Mofiche/Getriebebeleg/Dokumentation/Getriebebeleg.pdf

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

## 1 Zeichnungsdokumentation

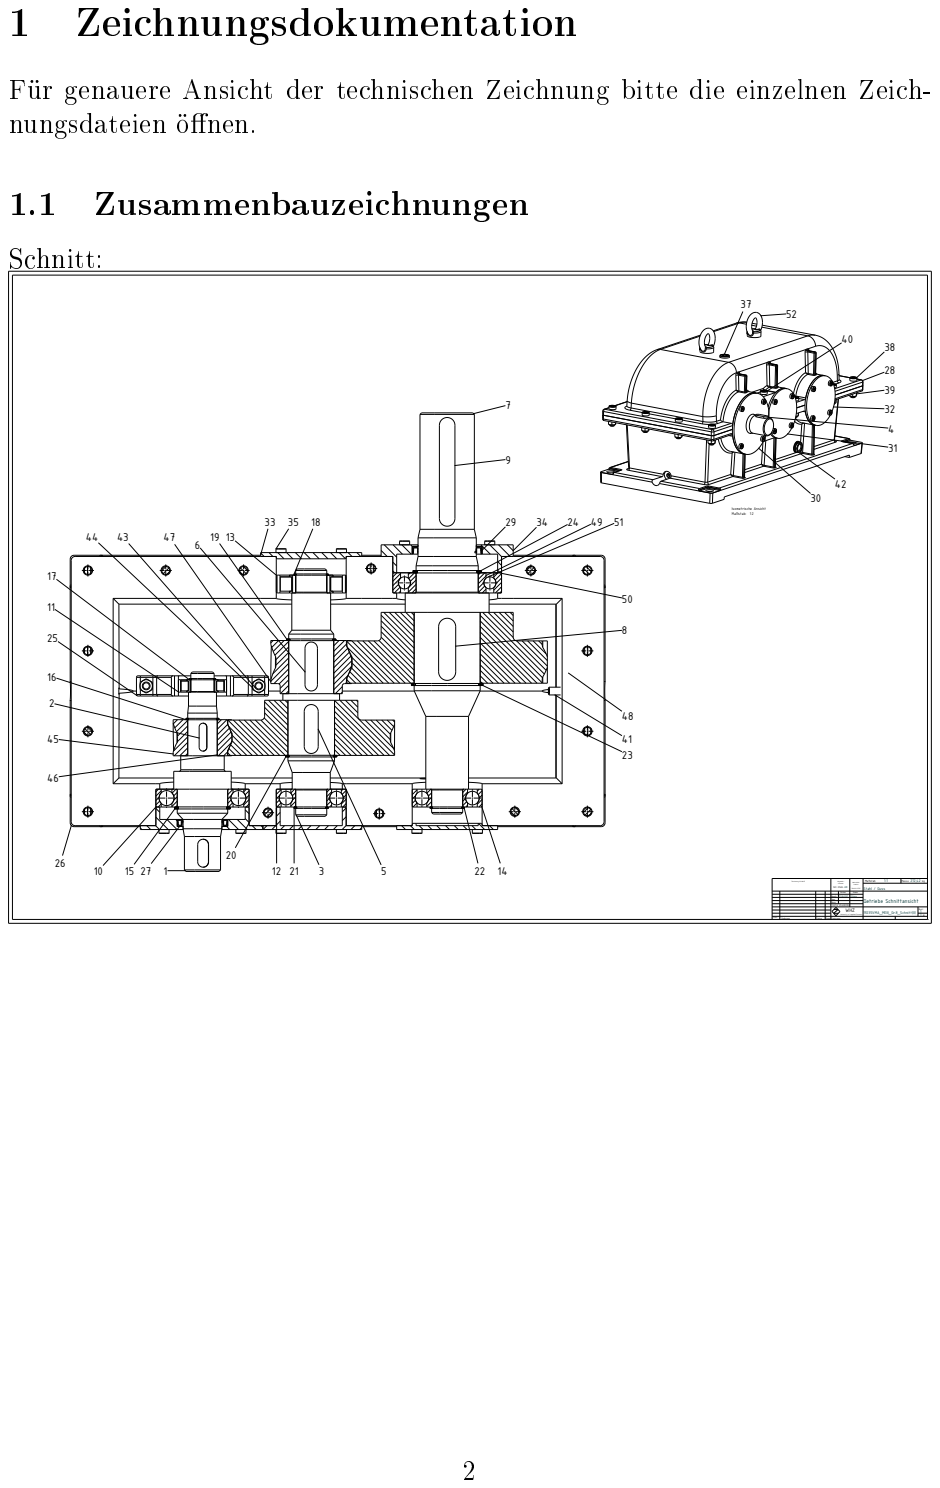
[picture p1: page 2]
Zusammenbauzeichnungen; Schnitt:; Maßstab; Gepr.; Bearb; Zust.; Datum; Name; Änderung; Blatt; Norm CATIA V5-6R2016; Allgemein- toleranz ISO 2768-; Tolerierung ISO 8015; Dateiname; Masse; WHZ; Getriebe Schnittansicht; 19235VMA_MEIII_Gr.8_Schnitt(0); 17.06.2021 M.Enge; Stahl / Guss; Isometrische Ansicht Maßstab: 1:2

Für genauere Ansicht der technischen Zeichnung bitte die einzelnen Zeich-
nungsdateien önen.

Werkstück-
kanten DIN ISO 13715

University of Applied Sciences

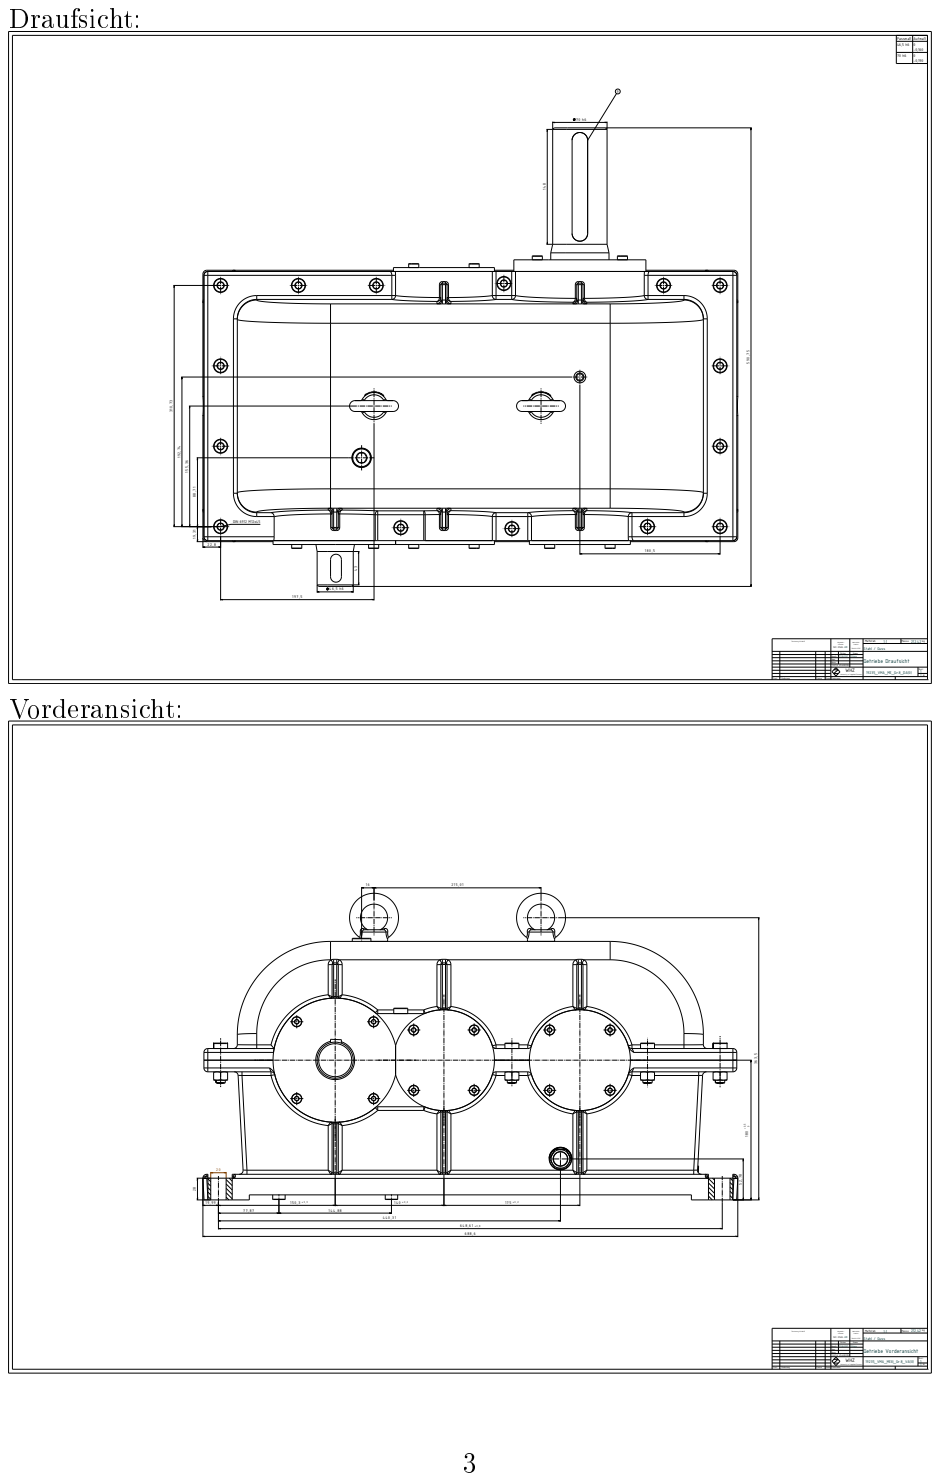
[picture p2: page 3]
Draufsicht:; Gepr.; Bearb; Name; Blatt; Datum; Norm CATIA V5-6R2016 WHZ; Getriebe Draufsicht; 19235_VMA_ME_Gr.8_DA(0); M.Enge; DIN 6912 M12x45; Vorderansicht:

9 70 h6 | Passmaß 46,5 h6 | Aufmaß 0 -0,160

Tolerierung ISO 8015 | Allgemein-toleranz ISO 2768-mK | Werkstück-kanten DIN ISO 13715 | Maßstab 1:1 Masse 212,42 Stahl / Guss | kg

Zust. Änderung | Datum Name Dateiname

University of Applied Sciences

Tolerierung ISO 8015 | ISO 2768-Allgemein-toleranz mK | Werkstück-kanten DIN ISO 13715 | Maßstab 1:1 Masse 212,42 Stahl / Guss | kg

Datum Norm Gepr. Bearb 17.06.2021 CATIA V5-6R2016 | Name M.Enge | Getriebe Vorderansicht

WHZ University of Applied Sciences | Blatt 19235_VMA_MEIII_Gr.8_VA(0) 1 1 | Bl.

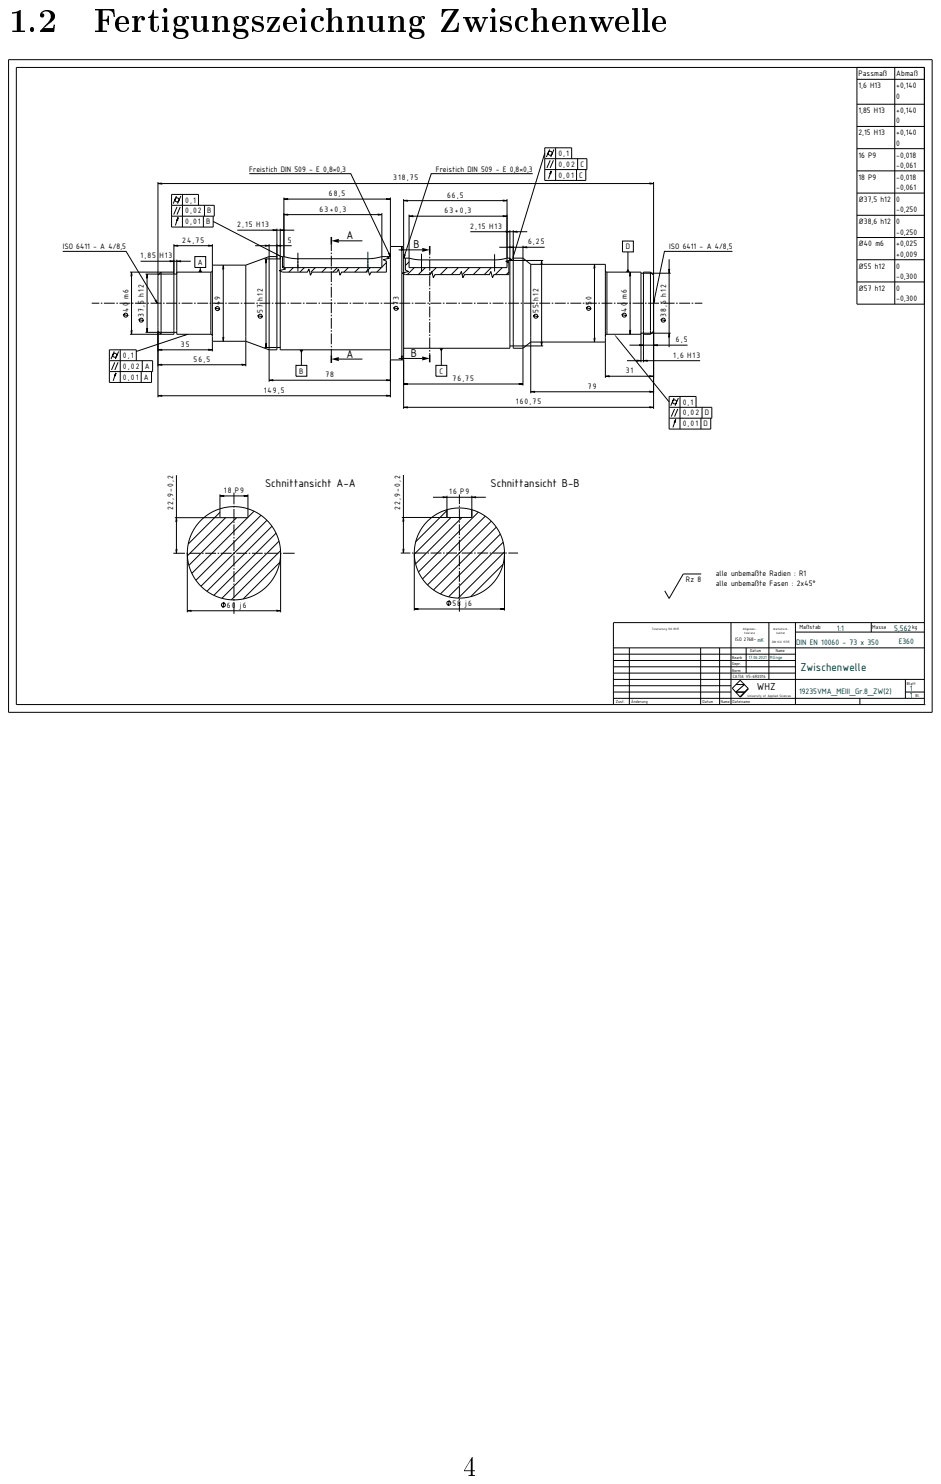
[picture p3: page 4]
Fertigungszeichnung Zwischenwelle; Maßstab; Werkstück- kanten; DIN ISO 13715; Allgemein- toleranz ISO 2768-; Tolerierung ISO 8015; Masse; DIN EN 10060 - 73 x 350; ISO 6411 - A 4/8,5; Freistich DIN 509 - E 0,8×0,3; Schnittansicht A-A; Schnittansicht B-B

Passmaß | Abmaß
1,6 H13 | +0,140 0

alle unbemaßte Radien : R1
alle unbemaßte Fasen : 2x45° Rz 8

Bearb | Datum 17.06.2021 | Name M.Enge | Zwischenwelle

Gepr.
Norm CATIA V5-6R2016

WHZ University of Applied Sciences | | Blatt 1 1 19235VMA_MEIII_Gr.8_ZW(2)

Zust. | Änderung | Datum | Name | Dateiname

1.3 | Stückliste
1 | 2 | 3 | 4 | 5 | 6
Pos. | Menge | Einheit | Benennung | Sachnummer / Norm - Kurzbezeichnung | Bemerkung
1 | 1 | Stck. | Eingangswelle | | C60
3 | 1 | Stck. | Zwischenwelle | | E360
7 | 1 | Stck. | Ausgangswelle | | S235JR
25 | 1 | Stck. | Lagerbock EW LL | | S235JR
26 | 1 | Stck. | Gehäuse Unterteil | | GG
28 | 1 | Stck. | Gehäuse Oberteil | | GG
30 | 1 | Stck. | Lagerdeckel EW LL | | S235JR
31 | 1 | Stck. | Lagerdeckel ZW FL | | S235JR
32 | 1 | Stck. | Lagerdeckel AW LL | | S235JR
33 | 1 | Stck. | Lagerdeckel ZW LL | | S235JR
34 | 1 | Stck. | Lagerdeckel AW FL | | S235JR
45 | 1 | Stck. | Ritzel Stufe 1 | | 16MnCr5
46 | 1 | Stck. | Rad Stufe 1 | | 16MnCr5
47 | 1 | Stck. | Ritzel Stufe 2 | | 16MnCr5
48 | 1 | Stck. | Rad Stufe 2 | | 16MnCr5

Datum | Name | Stückliste Getriebe gefertigt
| Bearb. | 17.06.2021 M.Enge
| Gepr.
| Norm
WH Zwickau | 19235_VMA_MEIII_Gr.8_gef(ST) | Blatt

Bl.
Zust. | Änderung | Datum | Nam
(Urspr.) | (Ers. f. :) | (Ers. d. :)

5

1 | 2 | 3 | 4 | 5 | 6
Pos. | Menge | Einheit | Benennung | Sachnummer / Norm - Kurzbezeichnung | Bemerkung
2 | 1 | Stck. | Paßfeder ZR 11 | A10x8x36 | C45
4 | 1 | Stck. | Paßfeder EW KupplungA14x9x36 | | C45
5 | 1 | Stck. | Paßfeder ZR 12 | A18x11x63 | C45
6 | 1 | Stck. | Paßfeder ZR 21 | A16x10x63 | C45
8 | 1 | Stck. | Paßfeder ZR 22 | A22x14x80 | C45
9 | 1 | Stck. | Paßfeder AW KupplungA20x12x140 | | C45
10 | 1 | Stck. | Lager EW FL | DIN 625 - 6213 | SKF
11 | 1 | Stck. | Lager EW LL | DIN 5412-1 – N206 | SKF
12 | 2 | Stck. | Lager ZW FL / AW LL | DIN 625 - 6308 | FAG
13 | 1 | Stck. | Lager ZW LL | DIN 5412-1 – N308 | Koyo
15 | 1 | Stck. | Sicherungsring EW FL | DIN 471 – 65x2,5 | C45
16 | 1 | Stck. | Sicherungsring ZR 11 | DIN 471 – 38x1,75 | C45
17 | 1 | Stck. | Sicherungsring EW FL | DIN 471 – 30x1,5 | C45
18 | 1 | Stck. | Sicherungsring ZW LL | DIN 471 – 40x1,75 | C45
19 | 1 | Stck. | Sicherungsring ZR 21 | DIN 471 – 58x2 | C45
20 | 1 | Stck. | Sicherungsring ZR 12 | DIN 471 – 60x2 | C45
21 | 2 | Stck. | Sich.ring ZW FL/AW LL DIN 471 – 40x1,75 | | C45
23 | 1 | Stck. | Sicherungsring ZR 22 | DIN 471 – 85x3 | C45
24 | 1 | Stck. | Sicherungsring AW FL | DIN 471 – 80x2,5 | C45
27 | 1 | Stck. | RWDR Eingangswelle | A50x65x8 | NBR
29 | 1 | Stck. | RWDR Ausgangswelle | A70x90x10 | NBR
35 | 20 | .Stck. | Zylinderschraube | DIN 7984 – M8x25 | C45
36 | 15 | Stck. | Zylinderschraube | DIN 7984 – M12x45 | C45
37 | 1 | Stck. | Zylinderschraube | DIN 7984 – M16x30 | C45
39 | 14 | Stck. | Sechskantmutter | ISO 4032 – M12 | C45
40 | 1 | Stck. | Zylinderschraube | DIN 7984 – M12x120 | C45
| | | Datum | Name | Stückliste Getriebe gekauft
| | | | Bearb. | 17.06.2021 | M.Enge
| | | | Gepr.
| | | | Norm
WH Zwickau | 19235_VMA_MEIII_Gr.8_gek
(ST)

Blatt
1
Bl.
Zust. | Änderung | Datum | Nam
(Urspr.) | (Ers. f. :) | (Ers. d. :)

6

1 | 2 | 3 | 4 | 5 | 6
Pos. | Menge | Einheit | Benennung | Sachnummer / Norm - Kurzbezeichnung | Bemerkung
41 | 1 | Stck. | Zylinderschraube | DIN 7984 – M10x16 | C45
42 | 1 | Stck. | Ölschauglas | DIN 31691 – A – M20x1,5 A1A1 C45/Glas
43 | 2 | Stck. | Zylinderschraube | DIN 7984 – M10x55 | C45
44 | 2 | Stck. | Sechskantmutter | ISO 4032 – M10 | C45
49 | 1 | Stck. | Lager AW FL | DIN 625 - 6216 | Koyo
52 | 2 | Stck. | Ringschraube Oberteil | DIN 580 – M10 | C45
51 | 2 | Stck. | Ringschraube Gewinde DIN 580 – M10 | | C45
| 10,8 | Liter | Öl | | Addinol
Datum | Name | Stückliste Getriebe gekauft
| Bearb. | 17.06.2021 | M.Enge
| Gepr.
| Norm
WH Zwickau | 19235_VMA_MEIII_Gr.8_gek
(ST)

Blatt
2
Bl.
Zust. | Änderung | Datum | Nam
(Urspr.) | (Ers. f. :) | (Ers. d. :)

7

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

Für Berechnung der Zähnzahlen der ersten Stufe siehe 3.1.5

MtA2 = i1 · MtA

MtA2 =

z2
z1
- MtA

MtA2 =

82
27
- 402, 07565Nm

MtA2 = 1221, 11864Nm

dub¨ =

3

r
16 · KA · MtA2

π · τt zul

dub¨ =

3

r
16 · 1, 1 · 1221, 11864Nm
π · 30MP a
dub¨ = 61, 094mm → gewahlt d ¨ | W elle2 = 62mm
3.1.2 | Zahnräder
3.1.2.1 | Modulabschätzung

Stufe 1
Annahmen für die Modulabschätzung:
| β = 10◦
| z1 = 27
| SF = 1, 5
| σF lim = 430MP a

mn = 3

s
5 · KA · Mt
- cos²β
z1

2
·

b
d1

·

SF

σF lim

mn =

3

s
5 · 1, 1 · 402, 07565Nm · cos²

(10◦
)
27²
- 0, 6

·

1, 5
430MP a

mn = 2, 57655mm → gewahlt m ¨ n = 2, 5mm

Stufe 2
Annahmen für die Modulabschätzung:

9

| β = 10◦
| z3 = 31
| SF = 1, 5
| σF lim = 430MP a

mn = 3

s
5 · KA · Mt
- cos²β
z3

2
·

b
d1

·

SF

σF lim

mn =

3

s
5 · 1, 1 · 1221, 11864Nm · cos²

(10◦
)
31²
- 0, 6

·

1, 5
430MP a
mn = 3, 40296mm → gewahlt m ¨ | n = 3mm
3.1.2.2 | Mindestteilkreisdurchmesser

Stufe 1
t2 = 3, 3mm aus II 6/3

d1min ≥ dW elle1 + 2(t2 + 2, 5 · mn + 1, 25 · mn)
d1min ≥ 43mm + 2(3, 3mm + 2, 5 · 2, 5mm + 1, 25 · 2, 5mm)

d1min = 68, 35mm

Stufe 2
t2 = 4, 6mm aus II 6/3

d2min ≥ dW elle2 + 2(t2 + 2, 5 · mn + 1, 25 · mn)
d2min ≥ 62mm + 2(4, 6mm + 2, 5 · 3mm + 1, 25 · 3mm)

d2min = 93, 7mm

3.1.2.3 Mindestzähnezahlen

10

Stufe 1

mt1 =

mn
cosβ

mt1 =

2, 5mm
cos10◦
mt1 = 2, 53857mm

z1min =

d1min
mt

z1min =

68, 35mm
2, 53857mm

z1min = 26, 9 → gewahlt z ¨ 1 = 27

Stufe 2

mt2 =

mn
cosβ

mt2 =

3mm
cos10◦
mt2 = 3, 04628mm

z3min =

d2min
mt

z3min =

93, 7mm
3, 04628mm
z3min = 30, 7 → gewahlt z ¨ | 3 = 31
3.1.2.4 | Aufteilung Übersetzungsverhältnis und Auswahl Zähne-
zahlen

Aus iges;soll = i1 · i2 und i2 ≈ 0, 85 · i1 folgt:

i1 ≈

p
iges
0, 85

= 3, 328

→ gewahlt i ¨ 1 = 3

11

i2 =

iges
i1

i2 =

8
3

z2 = i1 · z1
z2 = 3 · 27
z2 = 81 → gewahlt z ¨ 2 = 82

z4 = i2 · z3

z4 =

8
3
- 31

z4 = 82, 6 → gewahlt z ¨ 4 = 83

Es wurde z2 = 82 gewählt,da 27 und 82 zueinander teilerfremd sind. Analog wurde die Auswahl für z4 vorgenommen

| Stufe 1 | Stufe 2
Ritzel | z1 = 27 | z3 = 31
Rad | z2 = 82 | z4 = 83

iges;ist =

z2
z1

·

z4
z3

iges;ist =

82
27

·

83
31
iges;ist = 8, 13142

∆i =

iges;ist − iges;soll

iges;soll
∆i = 0, 01643 = 1, 643%

−3% < ∆i < 3% → i.O.

12

3.1.2.5 Achsabstände

Stufe 1

ad1 = mt1 ·

z1 + z2
2

ad1 = 2, 53857mm ·

27 + 82
2
ad1 = 138, 35188mm → gewahlt a ¨ 1 = 140mm

Stufe 2

ad2 = mt2 ·

z3 + z4
2

ad2 = 3, 04628mm ·

31 + 83
2
ad2 = 173, 63795mm → gewahlt a ¨ | 2 = 175mm
3.1.2.6 | Prolverschiebung der Zahnräder

αt = arctan
tan(αn)
cos(β)

αt = arctan

tan(20◦
)
cos(10◦
)

αt = 20, 28356◦

13

Stufe 1

αwt1 = arccos
ad1
a1
- cos(αt)

αwt1 = arccos
138, 35188mm
140mm
- cos(20, 28356◦
)

αwt1 = 22, 03632◦

(x1 + x2)

1 = (z1 + z2) ·

inv(αwt1) − inv(αt)
2 · tan(αn)

(x1 + x2)

1 = (27 + 82) ·

inv(22, 03632◦

) − inv(20, 28356◦
)
2 · tan(20◦
)
(x1 + x2)
1 = 0, 6868893405

x1 wurde durch Berechnung mit KissSoft so gewählt, dass es zu einem opti-malen spezischem Gleiten kommt

(x1)1 = 0, 3842

(x2)1 = (x1 + x2)

1 − (x1)1
(x2)1 = 0, 3026893405

Stufe 2

αwt2 = arccos
ad2
a2
- cos(αt)

αwt2 = arccos
173, 63795mm
175mm
- cos(20, 28356◦
)

αwt2 = 21, 45769◦

(x1 + x2)

2 = (z3 + z4) ·

inv(αwt2) − inv(αt)
2 · tan(αn)

(x1 + x2)
2 = (31 + 83) ·

inv(21, 45769◦

) − inv(20, 28356◦
)
2 · tan(20◦
)
(x1 + x2)
2 = 0, 4667160627

14 x1 wurde durch Berechnung mit KissSoft so gewählt, dass es zu einem opti-malen spezischem Gleiten kommt

(x1)2 = 0, 6026

(x2)2 = (x1 + x2)

2 − (x1)2
(x2)2 = −0, 1538839373
3.1.3 | Welle-Nabe-Verbindungen
3.1.3.1 | Passfeder Kupplung Eingangswelle

Daten an der Passfederstelle:

| d = 46, 5mm → b = 14mm ; h = 9mm
| i = 1 → ϕ = 1
| Mt = 402, 07565Nm
| KA = 1, 1
| pw = 0, 9 · Re = 0, 9 · 580MP a = 522MP a
| t1 = 5, 5mm

erf. ltr =

2 · Mt

- KA
d · t1 · pw · (i · ϕ)

erf. ltr =

2 · 402.075, 65Nmm · 1, 1
46, 5mm · 5, 5mm · 522MP a · (1 · 1)

erf. ltr = 6, 63mm → gewahlt l ¨ tr = 22mm

Es wurde ltr = 22mm gewählt, da mit dieser tragenden Länge die laut DIN 6885 erforderliche Mindestlänge einer Passfeder mit einem Rohrdurchmesser von 46, 5mm bei einer Breite von b = 14mm erreicht wird. Die Berechnung der erforderlichen tragenden Länge wurde für die Welle berechnet, da die Nabe einen höherwertigen Werksto besitzt.

15

(Welle : C60 ; Nabe : 16MnCr5)

erf. l = erf. ltr + b

erf. l = 22mm + 14mm

erf. l = 36mm → genormteLnge

Vorgabe:

ltr < 1, 3 · d

22mm < 1, 3 · 46, 5mm

22mm < 60, 45mm → i.O.

3.1.3.2 Passfeder Ritzel Stufe 1

Daten an der Passfederstelle:

| d = 38mm → b = 10mm ; h = 8mm
| i = 1 → ϕ = 1
| Mt = 402, 07565Nm
| KA = 1, 1
| pw = 0, 9 · Re = 0, 9 · 580MP a = 522MP a
| t1 = 5mm

erf. ltr =

2 · Mt

- KA
d · t1 · pw · (i · ϕ)

erf. ltr =

2 · 402.075, 65Nmm · 1, 1
38mm · 5mm · 522MP a · (1 · 1)

erf. ltr = 8, 92mm → gewahlt l ¨ tr = 26mm

16

Es wurde ltr = 26mm gewählt, da mit dieser tragenden Länge die genauen durch KissSoft berechneten Sicherheiten gut erfüllt werden.Die Berechnung der erforderlichen tragenden Länge wurde für die Welle berechnet, da die Nabe einen höherwertigen Werksto besitzt.
(Welle : C60 ; Nabe : 16MnCr5)

erf. l = erf. ltr + b

erf. l = 26mm + 10mm

erf. l = 36mm → genormteLnge

Vorgabe:

ltr < 1, 3 · d

26mm < 1, 3 · 38mm

26mm < 49, 4mm → i.O.

3.1.3.3 Passfeder Rad Stufe 1

Daten an der Passfederstelle:

| d = 60mm → b = 18mm ; h = 11mm
| i = 1 → ϕ = 1
| Mt = 1.221, 11864Nm
| KA = 1, 1
| pw = 0, 9 · Re = 0, 9 · 360MP a = 324MP a
| t1 = 7mm

erf. ltr =

2 · Mt

- KA
d · t1 · pw · (i · ϕ)

erf. ltr =

2 · 1.221.118, 64Nmm · 1, 1 46, 5mm · 7mm · 324MP a · (1 · 1)

erf. ltr = 19, 74mm → gewahlt l ¨ tr = 45mm

17

Es wurde ltr = 45mm gewählt, da mit dieser tragenden Länge die genauen durch KissSoft berechneten Sicherheiten gut erfüllt werden.Die Berechnung der erforderlichen tragenden Länge wurde für die Welle berechnet, da die Nabe einen höherwertigen Werksto besitzt.
(Welle : E360 ; Nabe : 16MnCr5)

erf. l = erf. ltr + b

erf. l = 45mm + 18mm

erf. l = 63mm → genormteLnge

Vorgabe:

ltr < 1, 3 · d

45mm < 1, 3 · 60mm

45mm < 78mm → i.O.

3.1.3.4 Passfeder Ritzel Stufe 2

Daten an der Passfederstelle:

| d = 58mm → b = 16mm ; h = 10mm
| i = 1 → ϕ = 1
| Mt = 1.221, 11864Nm
| KA = 1, 1
| pw = 0, 9 · Re = 0, 9 · 360MP a = 324MP a
| t1 = 6mm

erf. ltr =

2 · Mt

- KA
d · t1 · pw · (i · ϕ)

erf. ltr =

2 · 1.221.118, 64Nmm · 1, 1 58mm · 6mm · 324MP a · (1 · 1)

erf. ltr = 28, 5mm → gewahlt l ¨ tr = 47mm

18

Es wurde ltr = 47mm gewählt, da mit dieser tragenden Länge die genauen durch KissSoft berechneten Sicherheiten gut erfüllt werden.Die Berechnung der erforderlichen tragenden Länge wurde für die Welle berechnet, da die Nabe einen höherwertigen Werksto besitzt.
(Welle : E360 ; Nabe : 16MnCr5)

erf. l = erf. ltr + b

erf. l = 47mm + 16mm

erf. l = 63mm → genormteLnge

Vorgabe:

ltr < 1, 3 · d

47mm < 1, 3 · 58mm

47mm < 75, 4mm → i.O.

3.1.3.5 Passfeder Rad Stufe 2

Daten an der Passfederstelle:

| d = 85mm → b = 22mm ; h = 14mm
| i = 1 → ϕ = 1
| Mt = 3.269, 44668Nm
| KA = 1, 1
| pw = 0, 9 · Re = 0, 9 · 235MP a = 211, 5MP a
| t1 = 9mm

erf. ltr =

2 · Mt

- KA
d · t1 · pw · (i · ϕ)

erf. ltr =

2 · 3.269.446, 68Nmm · 1, 1 85mm · 9mm · 211, 5MP a · (1 · 1)

erf. ltr = 44, 46mm → gewahlt l ¨ tr = 58mm

19

Es wurde ltr = 58mm gewählt, da mit dieser tragenden Länge die genauen durch KissSoft berechneten Sicherheiten gut erfüllt werden. Die Berechnung der erforderlichen tragenden Länge wurde für die Welle berechnet, da die Nabe einen höherwertigen Werksto besitzt.
(Welle : S235JR ; Nabe : 16MnCr5)

erf. l = erf. ltr + b

erf. l = 58mm + 20mm

erf. l = 80mm → genormteLnge

Vorgabe:

ltr < 1, 3 · d

58mm < 1, 3 · 85mm

58mm < 110, 5mm → i.O.

3.1.3.6 Passfeder Kupplung Ausgangswelle

Daten an der Passfederstelle:

| d = 70mm → b = 20mm ; h = 12mm
| i = 1 → ϕ = 1
| Mt = 3.269, 44668Nm
| KA = 1, 1
| pw = 0, 9 · Re = 0, 9 · 235MP a = 211, 5MP a
| t1 = 7, 5mm

erf. ltr =

2 · Mt

- KA
d · t1 · pw · (i · ϕ)

erf. ltr =

2 · 3.269.446, 68Nmm · 1, 1 70mm · 7mm · 211, 5MP a · (1 · 1)

erf. ltr = 64, 8mm → gewahlt l ¨ tr = 120mm

20

Es wurde ltr = 120mm gewählt, da mit dieser tragenden Länge die genauen durch KissSoft berechneten Sicherheiten gut erfüllt werden. Die Berechnung der erforderlichen tragenden Länge wurde für die Welle berechnet, da die Nabe einen höherwertigen Werksto besitzt.
(Welle : S235JR ; Nabe : 16MnCr5)

erf. l = erf. ltr + b

erf. l = 120mm + 20mm

erf. l = 140mm → genormteLnge

Vorgabe:

ltr < 1, 3 · d

58mm < 1, 3 · 85mm

58mm < 110, 5mm → i.O.

3.1.4 | Lager
3.1.4.1 | Loslager Eingangswelle
3.1.4.2 | Festlager Eingangswelle
3.1.4.3 | Loslager Zwischenwelle
3.1.4.4 | Festlager Zwischenwelle
3.1.4.5 | Loslager Ausgangswelle
3.1.4.6 | Festlager Augangswelle

21

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

Berechnung:

d = 37, 4mm

A =

π · (37, 4mm)

2

4

= 1098, 583535mm² ≈ 1099mm2

Wb =

π · (37, 4mm)

3

32

= 5135, 878026mm³ ≈ 5136mm³

Wt =

π · (37, 4mm)

3

16

= 10271, 75605mm³ ≈ 10272mm³

ασ,zd = 1 +

1
r
0, 62 ·

0,8mm
9,3mm + 7 ·

0,8mm
37,4mm

·

1 + 2 ·

0,8mm

37,4mm2

= 3, 150904031 ≈ 3, 151

ασ,b = 1 +

1
r
0, 62 ·

0,8mm
9,3mm + 11, 6 ·

0,8mm
37,4mm

·

1 + 2 ·

0,8mm

37,4mm2
+ 0, 2 ·
0,8mm

9,3mm3
·

37,4mm
56mm
= 2, 758909365 ≈ 2, 759

ατ,t = 1 +

1
r
3, 4 ·

0,8mm
9,3mm + 38 ·

0,8mm
37,4mm

·

1 + 2 ·

0,8mm

37,4mm2
+
0,8mm

9,3mm2
·

37,4mm
56mm
= 1, 920074077 ≈ 1, 92

ϕ =

1

4 ·

q9,3mm
0,8mm + 2

= 0, 06394605328 ≈ 0, 064

K1D aus Re = 0, 82

23

Zug/Druck und Biegung:

G

0 =

2, 3 · (1 + 0, 064)
0, 8mm

= 3, 059

1
mm

n = 1 + r
3, 059

1
mm
- 10

−
0,33+
0,82·580 | N mm2
712MP a | !
= 1, 175716365 ≈ 1, 176

βσ;zd =

3, 151
1, 176

= 2, 679421769 ≈ 2, 679

βσ;b =

2, 759
1, 176

= 2, 346088435 ≈ 2, 346

Torsion:

G

0 =

1, 15
0, 8mm

= 1, 4375

1
mm

n = 1 + r
1, 4375

1
mm
- 10

−
0,33+
0,82·580 | N mm2
712MP a | !
= 1, 120455435 ≈ 1, 12

βτ =

1, 92
1, 12

= 1, 714285714 ≈ 1, 714

24

Berechnungswerte:

K1 aus Rm = 0, 9 (II 1/18) K1 aus Re = 0, 82 (II 1/18) K2;b,τ = 0, 89 (II 1/18)
K2;zd = 1 (II 1/18)

KF σ = 1 − 0, 22 · lg
Rz

µm
·
lg

σB(d)
20 N
mm²

!
− 1

!

= 1 − 0, 22 · lg
8µm

µm
·
lg

0, 82 · 850 N
mm²
20 N
mm²

!
− 1

!

= 0, 892275612 ≈ 0, 892

KF τ = 0, 575 · 0, 892275612 + 0, 425 = 0, 9380582752 ≈ 0, 938

KV = 1

Kσ;zd =

βσ

K2;zd

+

1

KF σ

− 1

·

1
KV

=

2, 679
1

+

1
0, 875

− 1

·

1
1
= 2, 800151424 ≈ 2, 8

Kσ;b =

βσ

K2;b

+

1

KF σ

− 1

·

1
KV

=

2, 346
0, 89

+

1
0, 875

− 1

·

1
1
= 2, 756784369 ≈ 2, 757

Kτ =

βτ

K2;t

+

1

KF τ

− 1

·

1
KV

=

1, 714
0, 89

+

1
0, 938

− 1

·

1
1
= 1, 992229669 ≈ 1, 992

25

σzdFK = K1 Re

- Re · γF

= 0, 82 · 580

N
mm²
- 1

= 475, 6

N
mm²

σbFK = K1 Re

- σbF · γF

= 0, 82 · 638

N
mm²
- 1

= 523, 16

N
mm²

τtFK = K1 Re

- τtF · γF

= 0, 82 · 368

N
mm²
- 1

= 301, 76

N
mm²

σzdWK =

σzdW · K1;Rm
Kσ

=

340 N
mm²
- 0, 9
2, 8

= 109, 2857143

N
mm²

≈ 109, 286

N
mm²

σbWK =

σbW · K1;Rm
Kσ

=

425 N
mm²
- 0, 9
2, 757

= 138, 7486103

N
mm²

≈ 138, 749

N
mm²

τtWK =

τtW · K1;Rm
Kτ

=

255 N
mm²
- 0, 9
1, 992

= 115, 1975616

N
mm²

≈ 115, 198

N
mm²
26

σzdm =

FL
A

=

2044, 38N
1099mm²

= 1, 86021838

N
mm²

≈ 1, 86

N
mm²

σzda = σzdm · KA − σzdm

= 0, 186

N
mm²

σbm = 0, da wechselnd

σba =

Mbres
Wb

=

326663 N
mm²
5136mm³

= 63, 60260903

N
mm²

≈ 63, 6

N
mm²

τtm =

Mtres
Wt

=

402076Nmm
10272mm³

= 39, 14291277

N
mm²

≈ 39, 14

N
mm²

τta = τtm · KA − τtm

= 3, 914

N
mm²

27

ψzdσK =

σzdWK

2 · K1 · Rm − σzdWK

=

109, 286 N
mm²
2 · 0, 9 · 850 N

mm² − 109, 286 N
mm²
= 0, 07724450519 ≈ 0, 077

ψbσK =

σbWK

2 · K1 · Rm − σbWK

=

138, 749 N
mm²
2 · 0, 9 · 850 N

mm² − 138, 749 N
mm²
= 0, 09972935969 ≈ 0, 1

ψtτK =

τtWK

2 · K1 · Rm − τtWK

=

115, 198 N
mm²
2 · 0, 9 · 850 N

mm² − 115, 198 N
mm²
= 0, 08142307255 ≈ 0, 081

σmv =

q
(σzdm + σbm)

2 + 3 · (τtm)

2

=

s
1, 86

N
mm²

+ 0

N
mm²

2
+ 3 ·
39, 14

N
mm²

2

= 67, 81797992

N
mm²

≈ 67, 82

N
mm²

τtmv =

σmv √
3

=

67, 82 N
mm² √
3

= 39, 15472896

N
mm²

≈ 39, 15

N
mm²

28

RzdσKv =

σmv − σzda

σmv + σzda

=

67, 82 N

mm² − 0, 186 N
mm²
67, 82 N

mm² + 0, 186 N
mm²
= 0, 9945298944 ≈ 0, 995

RzdG =

1 + ψzdσK − 2 ·

σzdWK
σzdFK
1 − ψzdσK

=

1 + 0, 077 − 2 ·

109,286 N
mm2
475,6

N
mm2
1 − 0, 077
= 0, 6693806127 ≈ 0, 669

RzdσKv > RzdG :

σzdADK =

σzdFK

1 + σmv/σzda

=

475, 6

N
mm²
1 + 67,82 N
mm2
0,186 N
mm2
= 1, 300829747

N
mm²

≈ 1, 301

N
mm²

29

RbσKv =

σmv − σba

σmv + σba

=

67, 82 N
mm² − 63, 6

N
mm²
67, 82 N
mm² + 63, 6

N
mm²
= 0, 03211078983 ≈ 0, 032

RbG =

1 + ψbσK − 2 ·

σbWK
σbFK
1 − ψbσK

=

1 + 0, 1 − 2 ·

138,749 N
mm2
523,16 N
mm2
1 − 0, 1
= 0, 6323700741 ≈ 0, 632

RbσKv < RbG :

σbADK =

σbWK

1 + ψbσK · σmv/σba

=

138, 749 N
mm²
1 + 0, 1 ·

67,82 N
mm2
63,6

N
mm2
= 125, 4122302

N
mm²

≈ 125, 412

N
mm²

30

RtτKv =

τtmv − τta

τtmv + τta

=

39, 15 N

mm² − 3, 914 N
mm²
39, 15 N
mm² + 3, 914 N
mm²
= 0, 8182240386 ≈ 0, 818

RtG =

1 + ψtτK − 2 ·

τtWK
τtFK
1 − ψtτK

=

1 + 0, 081 − 2 ·

115,198 N
mm2
301,76 N
mm2
1 − 0, 081
= 0, 346098999 ≈ 0, 346

RtτKv > RtG

τtADK =

τtFK

1 + τtmv/τta

=

301, 76 N
mm²
1 + 39, 15 N

mm² /3, 914 N
mm²
= 27, 42635705

N
mm²

≈ 27, 426

N
mm²

31

Sicherheiten Dauerfestigkeit:

SD;zd =

σzdADK

σzda

=

1, 301 N
mm²
0, 186 N
mm²
= 6, 993709317 ≈ 6, 994

SD;b =

σbADK

σbda

=

125, 412 N
mm²
63, 6

N
mm²
= 1, 971890412 ≈ 1, 972

SD;t =

τtADK

τtda

=

27, 426 N
mm²
3, 914 N
mm²
= 7, 007245031 ≈ 7, 007

SD =

1
r
1
SD;zd

+

1
SD;b

2
+
1
SD;t

2

=

1
r
1
6,994 +

1

1,9722
+
1

7,0072

= 1, 502421074 ≈ 1, 502

32

Sicherheiten Flieÿen:

SF;zd =

σzdFK

σzdmax

=

σzdFK

σzdm · KA

=

475, 6

N
mm²
1, 86 N
mm²
- 1, 1
= 232, 4535679 ≈ 232, 454

SF;b =

σbFK

σbmax

=

σbFK

σba

=

523, 16 N
mm²
63, 6

N
mm²
= 7, 477987421 ≈ 7, 478

SF;t =

τtFK

τtmax

=

τtFK

τtm · KA

=

301, 76 N
mm²
39, 14 N
mm²
- 1, 1
= 7, 008872579 ≈ 7, 009

SF =

1
r
1
SF ;zd

+

1
SF ;b

2
+
1
SF ;t

2

=

1
r
1
232,454 +

1

7,4782
+
1

7,0092

= 5, 037403861 ≈ 5, 037

33

3.2.1.2 Passfeder
Belastungen an dieser Stellen:
| Mbx = 324.026, 1475Nmm ≈ 324.026Nmm
| Mby = 162.803, 685Nmm ≈ 162.804Nmm
| FL = 2.044, 38N Mt = 402.075, 6457Nmm ≈ 402.076Nmm

Mbres =

q
(Mbx)

2 + (Mby)

2

=

q
(324.026Nmm)

2 + (162.804Nmm)

2

= 362.626, 517Nmm ≈ 362.627Nmm

Zulässige Maximalspannungen

Re = 580

N
mm²

Rm = 850

N
mm²

σzdW ≈ 0, 4 · Rm = 340

N
mm²

σbW ≈ 0, 5 · Rm = 425

N
mm²

τtW ≈ 0, 3 · Rm = 255

N
mm²

σbF ≈ 1, 1 · Re = 638

N
mm²

τtF ≈

1, 1
√
3
- Re ≈ 368

N
mm²

34

Berechnung:

d = 38mm

A =

π · (38mm)

2

4

= 1.134, 114948mm² ≈ 1.134mm2

Wb =

π · (38mm)

3

32

= 5.387, 046003mm³ ≈ 5.387mm³

Wt =

π · (38mm)

3

16

= 10.774, 09201mm³ ≈ 10.774mm³

βσ = 2, 85 (II 1/17)
βτ = 1, 75 (II 1/17)
K1 aus Rm = 0, 9 (II 1/18) K1 aus Re = 0, 87 (II 1/18) K2;b,τ = 0, 89 (II 1/18)
K2;zd = 1 (II 1/18)

KF σ = 1 − 0, 22 · lg
Rz

µm
·
lg

σB(d)
20 N
mm²

!
− 1

!

= 1 − 0, 22 · lg
8µm

µm
·
lg

0, 9 · 850 N
mm²
20 N
mm²

!
− 1

!

= 0, 884249038 ≈ 0, 884

KF τ = 0, 575 · 0, 884249038 + 0, 425 = 0, 9334396697 ≈ 0, 933

KV = 1

35

Kσ;zd =

βσ

K2;zd

+

1

KF σ

− 1

·

1
KV

=

2, 85
1

+

1
0, 884

− 1

·

1
1
= 2, 980850253 ≈ 2, 981

Kσ;b =

βσ

K2;b

+

1

KF σ

− 1

·

1
KV

=

2, 85
0, 89

+

1
0, 884

− 1

·

1
1
= 3, 333097444 ≈ 3, 333

Kτ =

βτ

K2;t

+

1

KF τ

− 1

·

1
KV

=

1, 75
0, 89

+

1
0, 933

− 1

·

1
1
= 2, 03759865 ≈ 2, 038

σzdFK = K1 Re

- Re · γF

= 0, 87 · 580

N
mm²
- 1

= 504, 6

N
mm²

σbFK = K1 Re

- σbF · γF

= 0, 87 · 638

N
mm²
- 1

= 555, 6

N
mm²

τtFK = K1 Re

- τtF · γF

= 0, 87 · 368

N
mm²
- 1

= 320, 16

N
mm²

36

σzdWK =

σzdW · K1;Rm
Kσ

=

340 N
mm²
- 0, 9
2, 981

= 102, 6552742

N
mm²

≈ 102, 655

N
mm²

σbWK =

σbW · K1;Rm
Kσ

=

425 N
mm²
- 0, 9
3, 333

= 114, 7581211

N
mm²

≈ 114, 758

N
mm²

τtWK =

τtW · K1;Rm
Kτ

=

255 N
mm²
- 0, 9
2, 038

= 112, 6325835

N
mm²

≈ 112, 633

N
mm²

σzdm =

FL
A

=

2044, 38N
1134mm²

= 1, 802804233

N
mm²

≈ 1, 8

N
mm²

σzda = σzdm · KA − σzdm

= 0, 18

N
mm²

σbm = 0, da wechselnd

σba =

Mbres
Wb

=

362.627 N
mm²
5387mm³

= 67, 31520327

N
mm²

≈ 67, 3

N
mm²
37

τtm =

Mtres
Wt

=

402076Nmm
10774mm³

= 37, 31910154

N
mm²

≈ 37, 3

N
mm²

τta = τtm · KA − τtm

= 3, 73

N
mm²

ψzdσK =

σzdWK

2 · K1 · Rm − σzdWK

=

102, 655 N
mm²
2 · 0, 9 · 850 N

mm² − 102, 655 N
mm²
= 0, 07192044945 ≈ 0, 072

ψbσK =

σbWK

2 · K1 · Rm − σbWK

=

114, 758 N
mm²
2 · 0, 9 · 850 N

mm² − 114, 758 N
mm²
= 0, 08108728464 ≈ 0, 081

ψtτK =

τtWK

2 · K1 · Rm − τtWK

=

112, 633 N
mm²
2 · 0, 9 · 850 N

mm² − 112, 633 N
mm²
= 0, 07936604539 ≈ 0, 079

σmv =

q
(σzdm + σbm)

2 + 3 · (τtm)

2

=

s
1, 8

N
mm²

+ 0

N
mm²

2
+ 3 ·
37, 3

N
mm²

2

= 64, 63056552

N
mm²

≈ 64, 631

N
mm²

38

τtmv =

σmv √
3

=

64, 631 N
mm² √
3

= 37, 3144744

N
mm²

≈ 37, 314

N
mm²

RzdσKv =

σmv − σzda

σmv + σzda

=

64, 631 N

mm² − 0, 18 N
mm²
64, 621 N

mm² + 0, 18 N
mm²
= 0, 9944453017 ≈ 0, 994

RzdG =

1 + ψzdσK − 2 ·

σzdWK
σzdFK
1 − ψzdσK

=

1 + 0, 072 − 2 ·

102,655 N
mm2
555,6

N
mm2
1 − 0, 072
= 0, 7146777975 ≈ 0, 715

RzdσKv > RzdG :

σzdADK =

σzdFK

1 + σmv/σzda

=

504, 6

N
mm²
1 + 64,631 N
mm2
0,18 N
mm2
= 1, 401450393

N
mm²

≈ 1, 401

N
mm²

39

RbσKv =

σmv − σba

σmv + σba

=

64, 631 N
mm² − 67, 3

N
mm²
64, 631 N
mm² + 67, 3

N
mm²
= −0, 020238005 ≈ −0, 020

RbG =

1 + ψbσK − 2 ·

σbWK
σbFK
1 − ψbσK

=

1 + 0, 1 − 2 ·

138,749 N
mm2
523,16 N
mm2
1 − 0, 1
= 0, 6323700741 ≈ 0, 632

RbσKv < RbG :

σbADK =

σbWK

1 + ψbσK · σmv/σba

=

114, 758 N
mm²
1 + 0, 082 ·

64,631 N
mm2
67,3

N
mm2
= 106, 4691374

N
mm²

≈ 106, 469

N
mm²

40

RtτKv =

τtmv − τta

τtmv + τta

=

37, 31 N

mm² − 3, 73 N
mm²
37, 31 N
mm² + 3, 73 N
mm²
= 0, 8182261209 ≈ 0, 818

RtG =

1 + ψtτK − 2 ·

τtWK
τtFK
1 − ψtτK

=

1 + 0, 079 − 2 ·

112,636 N
mm2
320,16 N
mm2
1 − 0, 079
= 0, 4082889999 ≈ 0, 408

RtτKv > RtG

τtADK =

τtFK

1 + τtmv/τta

=

320, 16 N
mm²
1 + 37, 31 N

mm² /3, 73 N
mm²
= 20, 09836257

N
mm²

≈ 29, 098

N
mm²

41

Sicherheiten Dauerfestigkeit:

SD;zd =

σzdADK

σzda

=

1, 401 N
mm²
0, 18 N
mm²
= 7, 785835517 ≈ 7, 786

SD;b =

σbADK

σbda

=

106, 469 N
mm²
67, 315 N
mm²
= 1, 581650686 ≈ 1, 582

SD;t =

τtADK

τtda

=

29, 098 N
mm²
3, 73 N
mm²
= 7, 80116959 ≈ 7, 801

SD =

1
r
1
SD;zd

+

1
SD;b

2
+
1
SD;t

2

=

1
r
1
7,786 +

1

1,5822
+
1

7,8012

= 1, 296320606 ≈ 1, 296

42

Sicherheiten Flieÿen:

SF;zd =

σzdFK

σzdmax

=

σzdFK

σzdm · KA

=

504, 6

N
mm²
1, 8

N
mm²
- 1, 1
= 254, 4520721 ≈ 254, 452

SF;b =

σbFK

σbmax

=

σbFK

σba

=

555, 6

N
mm²
67, 3

N
mm²
= 8, 253707528 ≈ 8, 254

SF;t =

τtFK

τtmax

=

τtFK

τtm · KA

=

320, 16 N
mm²
37, 319 N
mm²
- 1, 1
= 7, 799076972 ≈ 7, 799

SF =

1
r
1
SF ;zd

+

1
SF ;b

2
+
1
SF ;t

2

=

1
r
1
254,452 +

1

8,2542
+
1

7,7992

= 5, 582553646 ≈ 5, 583

3.2.2 | Verformungen
3.2.3 | Biegekritische Drehzahl
3.2.4 | Welle-Nabe-Verbindung
3.2.4.1 | Passfeder Kupplung
| d = 45mm
| b = 14mm

43

| h = 9mm
| ltr = 22mm
| i = 1 → ϕ = 1
| Mt = 402, 07565Nm
| KA = 1, 1
| t1 = 5, 5mm
| pzul = 0, 9 · Rm
| = 0, 9 · 580

N
mm²
| = 522

N
mm²

pW =

2 · Mt

- KA
d · t1 · ltr · (i · ϕ)

pW =

2 · 402.075, 65Nmm · 1, 1
45mm · 5, 5mm · 22mm · (1 · 1)

= 162, 453596

N
mm²

≈ 162, 5

N
mm²

pW < pzul → i.O.

3.2.4.2 | Passfeder Zahnrad
| d = 45mm
| b = 14mm
| h = 9mm
| ltr = 22mm
| i = 1 → ϕ = 1
| Mt = 402, 07565Nm
| KA = 1, 1

44

t1 = 5, 5mm

pzul = 0, 9 · Rm

= 0, 9 · 580

N
mm²

= 522

N
mm²

pW =

2 · Mt

- KA
d · t1 · ltr · (i · ϕ)

pW =

2 · 402.075, 65Nmm · 1, 1
45mm · 5, 5mm · 22mm · (1 · 1)

= 162, 453596

N
mm²

≈ 162, 5

N
mm²

pW < pzul → i.O.

3.2.5 | Lager
3.2.5.1 | Festlager
Lager SKF 6213 Aus SKF Katalog folgt:
| C = 58, 5kN
| C0 = 40, 5kN

45

dF L = 65mm

Fa = 2044, 38N

FF x = 2690, 97N

FF y = 5355, 81N

Fr =

q
(2690, 97N)

2 + (5355, 81N)

2
≈ 5993, 83N

Fa
C0

=

2044, 38N
40500N

= 0, 0504781852 ≈ 0, 050

Lineare Regression für e und Y zwischen benachbarten Werten:

→ e = 0, 252

Fa
Fr

=

2044, 38N
5993, 83N

≈ 0, 341

Fa
Fr

> e

X = 0, 56

→ Y = 1, 765

P = 0, 56 · 5993, 83N + 1, 765 · 2044, 38N ≈ 6.965N

Lh =

10⁶
60 · 950 1
min

·

58, 5kN

6, 965kN 3
≈ 10395h

3.2.5.2 Loslager
Lager SKF N206 ECM Aus SKF Katalog folgt:

46

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
