Mofiche/Getriebebeleg/Dokumentation/KissSoft/Getriebebeleg - Ausgangswelle.pdf

KISSsoft Release 2020 B
KISSsoft – student license (not for commercial use) Projekt
Name | : | Getriebebeleg
Beschreibung: | MEIII Beleg
Kunde | : | Prof. Fischer
| | | Datei
Name | : | Ausgangswelle
Geändert von: | Moritz | am: 18.06.2021 | um: 09:55:13

### Berechnung von Wellen, Achsen und Trägern

Eingabedaten

Koordinatensystem Welle: | siehe Bild W-002
Bezeichnung | Welle 1
Zeichnung
Startposition (mm) | | 0.000
Länge (mm) | | 517.000
Drehzahl (1/min) | | 116.83
Drehrichtung: | im Uhrzeigersinn
Werkstoff | S235J2 (St37.3 N)
Elastizitätsmodul (N/mm²) | | 206000.000
Poissonzahl nu | | 0.300
Dichte (kg/m³) | | 7830.000
Wärmeausdehnungskoeffizient | (10^-6/K) | 11.500
Temperatur (°C) | | 70.000
Gewicht der Welle (kg) | | 16.881
Hinweis: Gewicht gilt für die Welle ohne Berücksichtigung der Zahnräder
Gewicht der Welle, inklusive Zusatzmassen (kg) | 35.934
Massenträgheitsmoment (kg*m²) | | 0.183
Schwungmoment GD2 (Nm²) | | 7.176
Lage im Raum (°) | | 0.000
Zahnräder als Massen berücksichtigt
Schubverformungen werden berücksichtigt
Schubkorrekturfaktor | | 1.100
Der Druckwinkel von Wälzlagern wird berücksichtigt
Toleranzlage: | Mittelwert

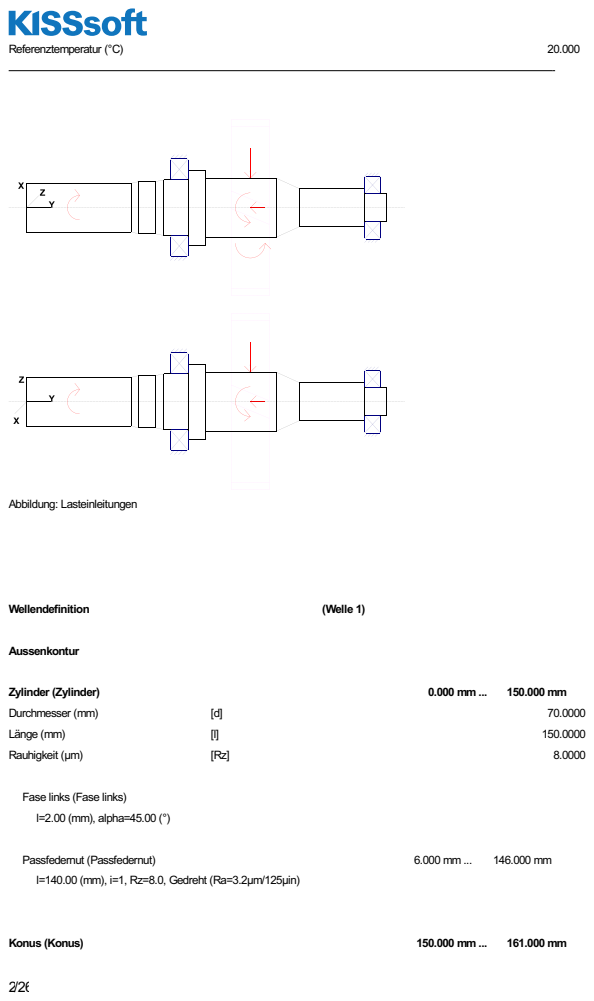
[picture p4: page 2]
Referenztemperatur (°C); Abbildung: Lasteinleitungen; Wellendefinition; (Welle 1); Aussenkontur; Zylinder (Zylinder); Durchmesser (mm); Länge (mm); Rauhigkeit (µm); Passfedernut (Passfedernut); Konus (Konus)

Fase links (Fase links)
l=2.00 (mm), alpha=45.00 (°)

l=140.00 (mm), i=1, Rz=8.0, Gedreht (Ra=3.2μm/125μin)

Durchmesser links (mm) | [dl] | 70.0000
Durchmesser rechts (mm) | [dr] | 75.0000
Länge (mm) | [l] | 11.0000
Rauhigkeit (µm) | [Rz] | 8.0000
Zylinder (Zylinder) | 161.000 mm ... | 185.000 mm
Durchmesser (mm) | [d] | 75.0000
Länge (mm) | [l] | 24.0000
Rauhigkeit (µm) | [Rz] | 1.8000
Konus (Konus) | 185.000 mm ... | 197.000 mm
Durchmesser links (mm) | [dl] | 75.0000
Durchmesser rechts (mm) | [dr] | 80.0000
Länge (mm) | [l] | 12.0000
Rauhigkeit (µm) | [Rz] | 8.0000
Zylinder (Zylinder) | 197.000 mm ... | 232.000 mm
Durchmesser (mm) | [d] | 80.0000
Länge (mm) | [l] | 35.0000
Rauhigkeit (µm) | [Rz] | 8.0000

Radius rechts (Radius rechts)
r=1.00 (mm), Rz=8.0, Gedreht (Ra=3.2μm/125μin)

Rechtecknut (Rechtecknut)
b=3.15 (mm), t=1.75 (mm), r=0.30 (mm), Rz=8.0, Gedreht (Ra=3.2μm/125μin)
Zylinder (Zylinder) | 232.000 mm ... | 257.000 mm
Durchmesser (mm) | [d] | 108.0000
Länge (mm) | [l] | 25.0000
Rauhigkeit (µm) | [Rz] | 8.0000
Zylinder (Zylinder) | 257.000 mm ... | 358.000 mm
Durchmesser (mm) | [d] | 85.0000
Länge (mm) | [l] | 101.0000
Rauhigkeit (µm) | [Rz] | 8.0000
Passfedernut (Passfedernut) | 264.600 mm ... | 344.600 mm
l=80.00 (mm), i=1, Rz=8.0, Gedreht (Ra=3.2μm/125μin)

Freistich links (Freistich links)
r=1.20 (mm), t=0.40 (mm), l=4.00 (mm), Rz=8.0, Gedreht (Ra=3.2μm/125μin) Form E (DIN 509), Reihe 1, mit üblicher Beanspruchung

Rechtecknut (Rechtecknut)
b=2.65 (mm), t=1.75 (mm), r=0.30 (mm), Rz=8.0, Gedreht (Ra=3.2μm/125μin)
Konus (Konus) | 358.000 mm ... | 391.000 mm
Durchmesser links (mm) | [dl] | 85.0000
Durchmesser rechts (mm) | [dr] | 55.0000
Länge (mm) | [l] | 33.0000
Rauhigkeit (µm) | [Rz] | 8.0000
Zylinder (Zylinder) | 391.000 mm ... | 485.000 mm
Durchmesser (mm) | [d] | 55.0000
Länge (mm) | [l] | 94.0000
Rauhigkeit (µm) | [Rz] | 8.0000
Zylinder (Zylinder) | 485.000 mm ... | 517.000 mm
Durchmesser (mm) | [d] | 40.0000
Länge (mm) | [l] | 32.0000
Rauhigkeit (µm) | [Rz] | 8.0000

Radius links (Radius links)
r=1.00 (mm), Rz=32.0, Gedreht (Ra=3.2μm/125μin)

Rechtecknut (Rechtecknut)
b=1.85 (mm), t=1.25 (mm), r=0.17 (mm), Rz=8.0, Gedreht (Ra=3.2μm/125μin)

Fase rechts (Fase rechts)
l=2.00 (mm), alpha=45.00 (°)

Kräfte

Art des Kraftelements | | Kupplung/Motor
Bezeichnung im Modell | | Kupplung/Motor
Position auf Welle (mm) | [ylocal] | 76.0000
Position im globalen System (mm) | [yglobal] | 76.0000

Wirkdurchmesser (mm) | 0.0000
Radialkraftfaktor (-) | 0.0000
Richtung der Radialkraft (°) | 0.0000
Axialkraftfaktor (-) | 0.0000
Länge der Krafteinleitung (mm) | 140.0000
Leistung (kW) | 40.0000 | treibend
(Abtrieb)
Drehmoment (Nm) | -3269.4477
Axialkraft (N) | 0.0000
Querkraft X (N) | 0.0000
Querkraft Z (N) | 0.0000
Biegemoment X (Nm) | 0.0000
Biegemoment Z (Nm) | 0.0000
Masse (kg) | 0.0000
Massenträgheitsmoment Jp (kg*m²) | 0.0000
Massenträgheitsmoment Jxx (kg*m²) | 0.0000
Massenträgheitsmoment Jzz (kg*m²) | 0.0000
Exzentrizität (mm) | 0.0000
Art des Kraftelements | Stirnrad
Bezeichnung im Modell | Stirnrad
Position auf Welle (mm) | [ylocal] | 321.0000
Position im globalen System (mm) | [yglobal] | 321.0000
Wälzkreisdurchmesser (mm) | 253.1250
Schrägungswinkel (°) | 10.2530 | rechts
Betriebseingriffswinkel im Normalschnitt (°) | 23.5454
Position des Eingriffs (°) | 0.0000
Länge der Krafteinleitung (mm) | 54.5000
Leistung (kW) | 40.0000 | getrieben
(Antrieb)
Drehmoment (Nm) | 3269.4477
Axialkraft (N) | -4672.7048
Querkraft X (N) | -11439.3671
Querkraft Z (N) | -25832.6732
Biegemoment X (Nm) | 0.0000
Biegemoment Z (Nm) | -591.3892

Lager

---------------------------------------------------------------------------------------------------------------------------- Bezeichnung im Modell | FL
Lager Typ | SKF 216
Lager Bauform | Rillenkugellager (einreihig)

Lager Position (mm) | [ylokal] | 219.000
Lager Position (mm) | [yglobal] | 219.000
Befestigung Aussenring | Festlager
Innendurchmesser (mm) | [d] | 80.000
Aussendurchmesser (mm) | [D] | 140.000
Breite (mm) | [b] | 26.000
Eckradius (mm) | [r] | 2.000
Statische Tragzahl (kN) | [C0] | 85.000
Dynamische Tragzahl (kN) | [C] | 88.000
Tragzahl Ermüdung (kN) | [Cu] | 3.500
Werte für die approximierte Geometrie:
Dynamische Tragzahl (kN) | [Ctheo] | 0.000
Statische Tragzahl (kN) | [C0theo] | 0.000
Korrekturfaktor Dynamische Tragzahl | [fC] | 1.000
Korrekturfaktor Statische Tragzahl | [fC0] | 1.000
---------------------------------------------------------------------------------------------------------------------------- Bezeichnung im Modell | LL
Lager Typ | SKF 6308
Lager Bauform | Rillenkugellager (einreihig)
SKF Explorer
Lager Position (mm) | [ylokal] | 496.500
Lager Position (mm) | [yglobal] | 496.500
Befestigung Aussenring | Loslager
Innendurchmesser (mm) | [d] | 40.000
Aussendurchmesser (mm) | [D] | 90.000
Breite (mm) | [b] | 23.000
Eckradius (mm) | [r] | 1.500
Statische Tragzahl (kN) | [C0] | 24.000
Dynamische Tragzahl (kN) | [C] | 42.300
Tragzahl Ermüdung (kN) | [Cu] | 1.000
Werte für die approximierte Geometrie:
Dynamische Tragzahl (kN) | [Ctheo] | 0.000
Statische Tragzahl (kN) | [C0theo] | 0.000
Korrekturfaktor Dynamische Tragzahl | [fC] | 1.000
Korrekturfaktor Statische Tragzahl | [fC0] | 1.000
---------------------------------------- Welle 'Welle 1': Die Masse von folgendem Element wird berücksichtigt (y= | 321.0000 (mm)): Stirnrad

'Stirnrad' 6/26

m (yS= | 321.0000 (mm)): | 19.0528 (kg)
Jp: | 0.1698 (kg*m²), Jxx: | 0.0896 (kg*m²), Jzz: | 0.0896 (kg*m²)

Resultate

Welle

Maximale Durchbiegung (μm) | 77.267
Position des Maximums (mm) | 0.000
Massenschwerpunkt (mm) | 239.088
Summe der axialen Belastung (N) | -4672.705
Verdrehung unter Drehmoment (°) | 0.165

Lager

Ausfallwahrscheinlichkeit | [n] | 10.00 | %
Axialspiel (ISO 281) | [uA] | 10.00
µm
Schmierstoff | ISO-VG 220
Schmierstoff - Betriebstemperatur | [TB] | 20.00 | °C
Wälzlager klassisch (Druckwinkel berücksichtigen)
Welle 'Welle 1' Wälzlager 'FL' Position (Y-Koordinate) | [y] | 219.00 | mm
Dynamisch äquivalente Belastung | [P] | 19.07 | kN
Statisch äquivalente Belastung | [P0] | 19.07 | kN
Faktor für Ausfallwahrscheinlichkeit | [a1] | 1.000

Ergebnisse nach ISO 281:
Schmierstoff | ISO-VG 220
Lastverhältnis | [C/P] | 4.615
Betriebsviskosität | [ν] | 912.866
mm²/s
Bezugsviskosität | [ν1] | 0.000
mm²/s
Viskositätsverhältnis | [κ] | 0.000
Nominelle Lagerlebensdauer | [Lnh] | 14022.00 | h
Statischer Sicherheitsfaktor | [S0] | 4.46

Lagerreaktionskraft | [Fx] | 9.366 | kN
Lagerreaktionskraft | [Fy] | 4.673 | kN
Lagerreaktionskraft | [Fz] | 16.610 | kN
Lagerreaktionskraft | [Fr] | 19.068 | kN (60.58°)
Lagerreaktionsmoment | [Mx] | 0.00 | Nm
Lagerreaktionsmoment | [My] | 0.00 | Nm
Lagerreaktionsmoment | [Mz] | -0.00 | Nm
Lagerreaktionsmoment | [Mr] | 0.00 | Nm (0°)
Ölstand | [H] | 0.000 | mm
Rollreibungsmoment | [Mrr] | 1.402
Nm
Gleitreibungsmoment | [Msl] | 1.297
Nm
Reibungsmoment Dichtungen | [Mseal] | 0.000
Nm
Reibungsmoment Dichtungen nach SKF-Hauptkatalog 17000/1 EN:2018 bestimmt
Reibungsmoment Strömungsverluste | [Mdrag] | 0.000
Nm
Reibungsmoment | [Mloss] | 2.699
Nm
Verlustleistung | [Ploss] | 33.023 | W
Das Reibungsmoment wird nach Angaben aus dem SKF-Katalog 2018 berechnet. Es wird immer mit einem Beiwert für Zusätze im Schmierstoff μbl=0.15 gerechnet. Die Faktoren zur Berechnung des Reibmomentes wurden für dieses Lager angenommen. Lagerverschiebung | [ux] | -4.861

µm
Lagerverschiebung | [uy] | -10.000
µm
Lagerverschiebung | [uz] | -8.739
µm
Lagerverschiebung | [ur] | 10.000
µm | (-119.08°)
Lagerneigung | [rx] | -0.384
mrad | (-1.32')
Lagerneigung | [ry] | 2.147
mrad | (7.38')
Lagerneigung | [rz] | 0.106
mrad | (0.36')
Lagerneigung | [rr] | 0.398
mrad | (1.37')
Welle 'Welle 1' Wälzlager 'LL' Position (Y-Koordinate) | [y] | 496.50 | mm

Dynamisch äquivalente Belastung | [P] | 9.80 | kN
Statisch äquivalente Belastung | [P0] | 9.80 | kN
Faktor für Ausfallwahrscheinlichkeit | [a1] | 1.000

Ergebnisse nach ISO 281:
Schmierstoff | ISO-VG 220
Lastverhältnis | [C/P] | 4.318
Betriebsviskosität | [ν] | 912.866
mm²/s
Bezugsviskosität | [ν1] | 0.000
mm²/s
Viskositätsverhältnis | [κ] | 0.000
Nominelle Lagerlebensdauer | [Lnh] | 11481.31 | h
Statischer Sicherheitsfaktor | [S0] | 2.45
Lagerreaktionskraft | [Fx] | 2.073 | kN
Lagerreaktionskraft | [Fy] | 0.000 | kN
Lagerreaktionskraft | [Fz] | 9.575 | kN
Lagerreaktionskraft | [Fr] | 9.797 | kN (77.78°)
Ölstand | [H] | 0.000 | mm
Rollreibungsmoment | [Mrr] | 0.180
Nm
Gleitreibungsmoment | [Msl] | 0.215
Nm
Reibungsmoment Dichtungen | [Mseal] | 0.000
Nm
Reibungsmoment Dichtungen nach SKF-Hauptkatalog 17000/1 EN:2018 bestimmt
Reibungsmoment Strömungsverluste | [Mdrag] | 0.000
Nm
Reibungsmoment | [Mloss] | 0.395
Nm
Verlustleistung | [Ploss] | 4.838 | W
Das Reibungsmoment wird nach Angaben aus dem SKF-Katalog 2018 berechnet. Es wird immer mit einem Beiwert für Zusätze im Schmierstoff μbl=0.15 gerechnet. Lagerverschiebung | [ux] | -1.367

µm
Lagerverschiebung | [uy] | 149.186
µm
Lagerverschiebung | [uz] | -6.355
µm
Lagerverschiebung | [ur] | 6.500
µm | (-102.14°)
Lagerneigung | [rx] | 0.603
mrad | (2.07')
Lagerneigung | [ry] | 2.872

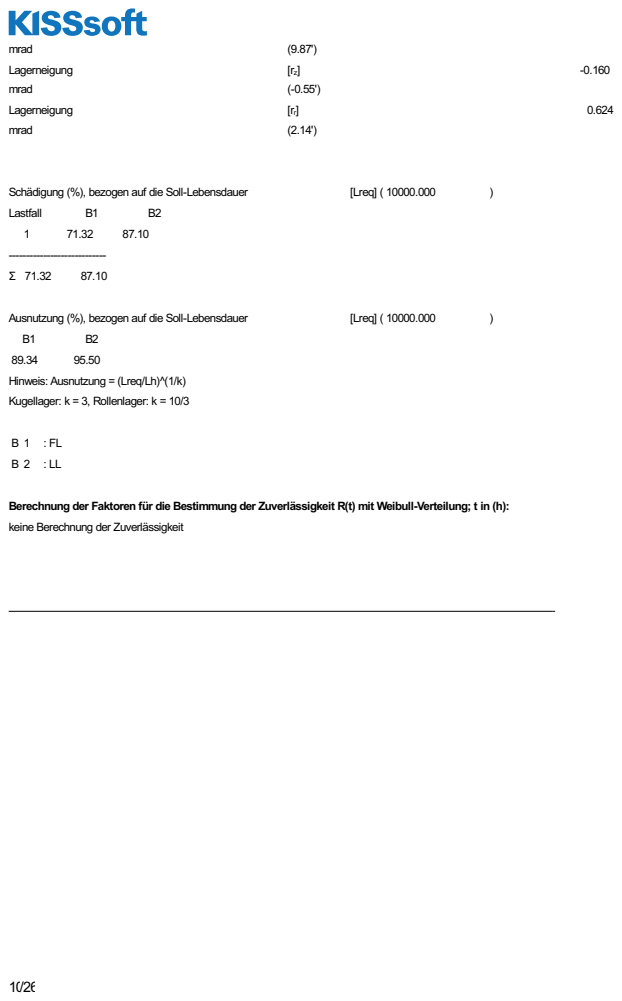
[picture p5: page 10]
mrad; Lagerneigung; Schädigung (%), bezogen auf die Soll-Lebensdauer; [Lreq] ( 10000.000; Lastfall; Ausnutzung (%), bezogen auf die Soll-Lebensdauer

Hinweis: Ausnutzung = (Lreq/Lh)^(1/k)
Kugellager: k = 3, Rollenlager: k = 10/3

Berechnung der Faktoren für die Bestimmung der Zuverlässigkeit R(t) mit Weibull-Verteilung; t in (h):
keine Berechnung der Zuverlässigkeit

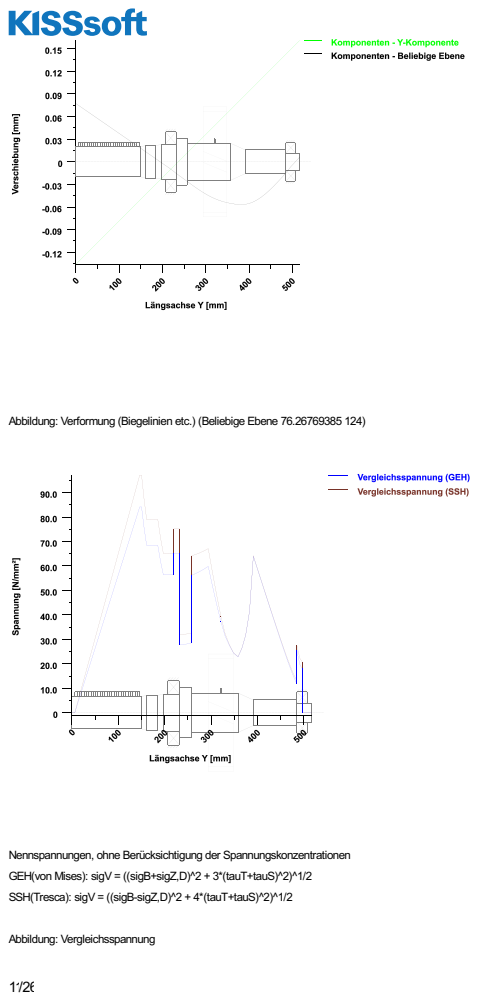
[picture p6: page 11]
Abbildung: Vergleichsspannung

Abbildung: Verformung (Biegelinien etc.) (Beliebige Ebene 76.26769385 124)

Nennspannungen, ohne Berücksichtigung der Spannungskonzentrationen
GEH(von Mises): sigV = ((sigB+sigZ,D)^2 + 3*(tauT+tauS)^2)^1/2
SSH(Tresca): sigV = ((sigB-sigZ,D)^2 + 4*(tauT+tauS)^2)^1/2

### Eigenfrequenzen

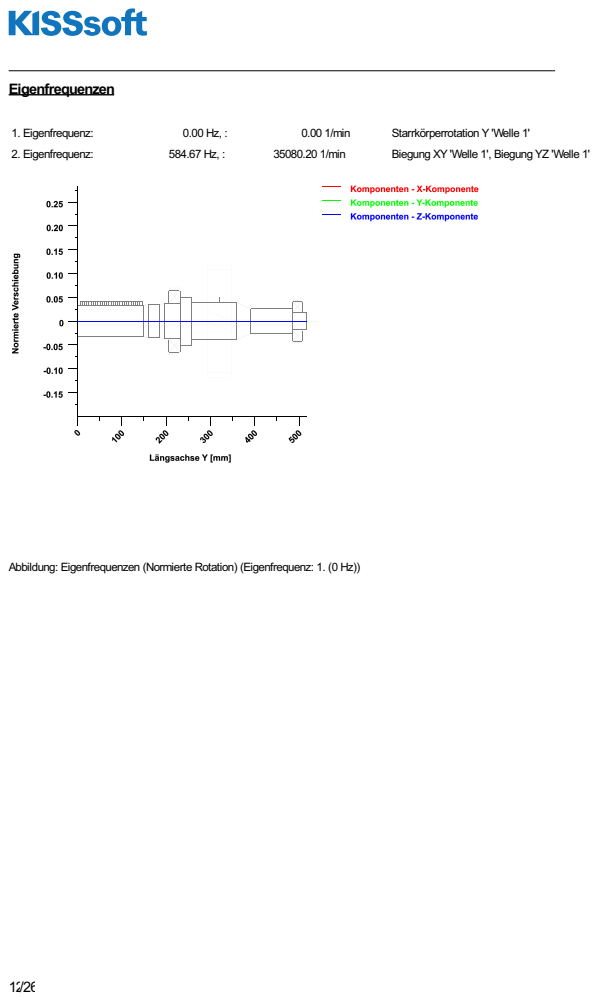
[picture p7: page 12]
1. Eigenfrequenz:; 0.00 1/min; Starrkörperrotation Y 'Welle 1' 2. Eigenfrequenz:; 35080.20 1/min; Biegung XY 'Welle 1', Biegung YZ 'Welle 1'

Abbildung: Eigenfrequenzen (Normierte Rotation) (Eigenfrequenz: 1. (0 Hz))

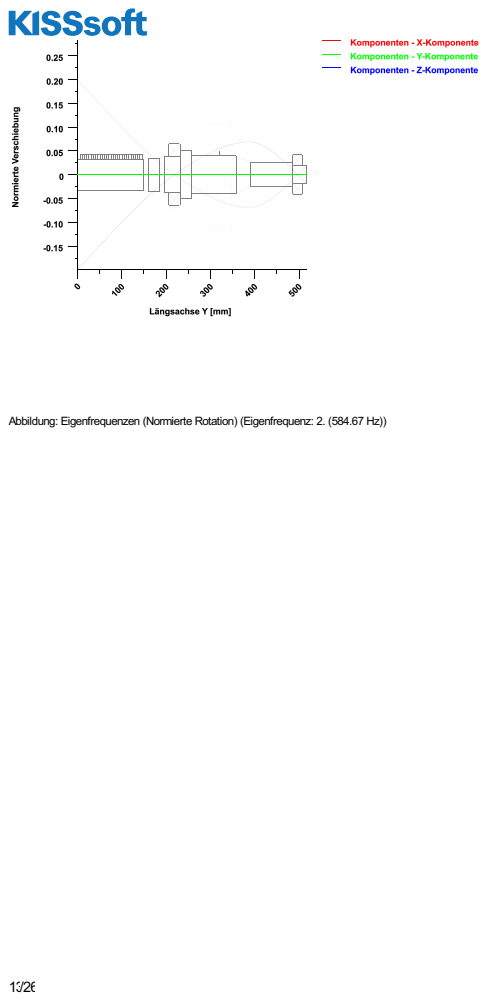
[picture p8: page 13]

Abbildung: Eigenfrequenzen (Normierte Rotation) (Eigenfrequenz: 2. (584.67 Hz))

### Festigkeitsberechnung nach DIN 743:2012

Zusammenfassung

Welle 1

Werkstoff | S235J2 (St37.3 N)
Werkstoffart | Baustahl
Werkstoff-Behandlung | unbehandelt
Oberflächen-Behandlung | Keine

Berechnung der Dauerfestigkeit und der statischen Festigkeit

Berechnung für Beanspruchungsfall 2 (σav/σmv = konst)
Querschnitt | Lage (Y-Koor) (mm)
A-A | 293.75 | Passfeder
B-B | 230.00 | Press-Sitz
C-C | 264.61 | Passfeder
D-D | 257.00 | Wellenabsatz mit Freistich
E-E | 264.59 | Glatte Welle
F-F | 232.00 | Wellenabsatz

Resultate:
Querschnitt | βσ | KFσ | K2d | SD | SS
A-A | 2.14 | 1.00 | 0.84 | 1.41 | 4.24
B-B | 1.82 | 1.00 | 0.84 | 1.70 | 3.91
C-C | 2.14 | 1.00 | 0.84 | 1.75 | 4.52
D-D | 2.26 | 0.95 | 0.84 | 1.86 | 4.48
E-E | 1.00 | 0.95 | 0.84 | 1.87 | 4.52
F-F | 2.36 | 0.95 | 0.84 | 1.89 | 3.91
Sollsicherheiten: | | | | 1.20 | 1.20

Abkürzungen:
βσ: Kerbfaktor Biegung
KFσ: Oberflächenfaktor
K2d: Grössenfaktor Biegung SD: Sicherheit Dauerfestigkeit SS: Sicherheit Streckgrenze

Ausnutzung (%) | [Smin/S]
Querschnitt | Statisch | Dauerfest
A-A | 28.312 | 84.876
B-B | 30.680 | 70.574
C-C | 26.545 | 68.563
D-D | 26.808 | 64.439
E-E | 26.544 | 64.231
F-F | 30.688 | 63.519
Maximale Ausnutzung (%) | [A] | 84.876

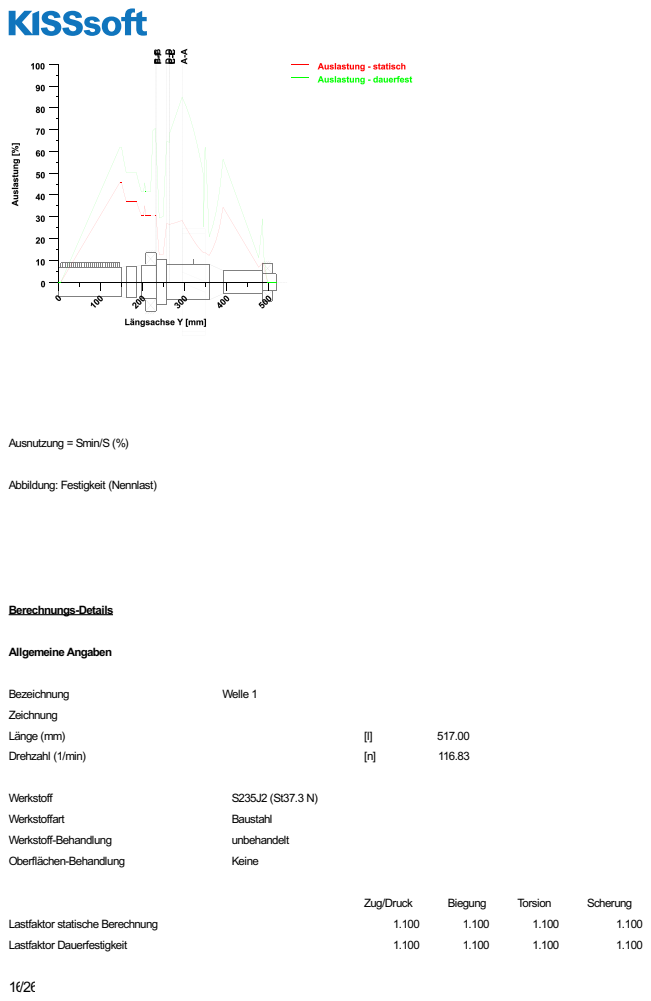
[picture p9: page 16]
Ausnutzung = Smin/S (%); Berechnungs-Details; Allgemeine Angaben; Bezeichnung; Welle 1; Zeichnung; Länge (mm); Drehzahl (1/min); Werkstoff; Werkstoffart; Baustahl; Werkstoff-Behandlung; unbehandelt; Oberflächen-Behandlung; Keine; Zug/Druck; Biegung; Torsion; Scherung; Lastfaktor statische Berechnung; Lastfaktor Dauerfestigkeit

Abbildung: Festigkeit (Nennlast)

Bezugsdurchmesser Werkstoff (mm) | [dB] | 16.00
σB nach DIN 743, bei dB (N/mm²) | [σB] | 360.00
σS nach DIN 743, bei dB (N/mm²) | [σS] | 235.00
[σzdW], bei dB (N/mm²) | 145.00
[σbW], | bei dB (N/mm²) | 180.00
[τtW], | bei dB (N/mm²) | 110.00
Dicke Rohmaterial (mm) | [dWerkst] | 110.00
Werkstoffdaten nach DIN743/3 mit K1(d) berechnet
Werkstoff-Festigkeitswerte aus Dicke Rohmaterial bestimmt
Geometrischer Grössenfaktor K1d mit Rohdurchmesser berechnet
[σBeff] (N/mm²) | 356.57
[σSeff] (N/mm²) | 202.24
[σbFK] (N/mm²) | 242.68
[τtFK] (N/mm²) | 140.11
[σbBRand] (N/mm²) | 360.00
[σzdW] (N/mm²) | 143.62
[σbW] (N/mm²) | 178.29
[τtW] (N/mm²) | 108.95

Dauerfestigkeit für Einstufenbeanspruchung

Berechnung für Beanspruchungsfall 2 (σ.av/σ.mv = konst)

Querschnitt 'A-A' | Passfeder
Kommentar | Y= 264.60...344.60mm
Position (Y-Koordinate) (mm) | [y] | 293.750
Aussendurchmesser (mm) | [da] | 85.000
Innendurchmesser (mm) | [di] | 0.000
Kerbwirkung | Passfeder
Anzahl Passfedern | [n] | 1
Nut mit Fingerfräser bearbeitet
Norm: | DIN 6885.1:1968 Standard
[b, t] (mm) | 22.000 9.100
Mittlere Rauheit (µm) | [Rz] | 8.000
Zug/Druck | Biegung | Torsion | Scherung
Belastung: (N) (Nm)
Mittelwert | [Fzdm, Mbm, Tm, Fqm] | -4677.4 | 0.0 | 3272.7 | 0.0
Ausschlag (Amplitude) | [Fzda, Mba, Ta, Fqa] | 462.6 | 1554.5 | 323.7 | 20872.7
Maximalwert | [Fzdmax, Mbmax, Tmax, Fqmax] | -5140.0 | 1554.5 | 3596.4 | 20872.7
Querschnitt, Widerstandsmomente: (mm²) (mm3)

[A, Wb, Wt, A] | 5674.5 | 60291.6 | 120583.2 | 5674.5

Spannungen: (N/mm²)
[σzdm, σbm, τm, τqm] (N/mm²) | -0.824 | 0.000 | 27.141 | 0.000
[σzda, σba, τa, τqa] (N/mm²) | 0.082 | 25.782 | 2.684 | 4.904
[σzdmax,σbmax,τmax,τqmax] (N/mm²) | -0.906 | 25.782 | 29.825 | 4.904
Technologischer Grösseneinfluss | [K1(σB)] | 0.990
| [K1(σS)] | 0.861
| | Zug/Druck | Biegung | Torsion
Kerbwirkungszahl | [ß(dB)] | 2.100 | 2.100 | 1.300
[dB] (mm) = | 40.0
Geometrischer Grösseneinfluss | [K3(d)] | 0.948 | 0.948 | 0.982
Geometrischer Grösseneinfluss | [K3(dB)] | 0.964 | 0.964 | 0.987
Kerbwirkungszahl | [ß] | 2.136 | 2.136 | 1.308
Geometrischer Grösseneinfluss | [K2(d)] | 1.000 | 0.838 | 0.838
Einflussfaktor Oberflächenrauheit | [KF] | 1.000 | 1.000 | 1.000
Rauheitsfaktor ist gemäss Norm in der Kerbwirkungszahl inbegriffen
Oberflächenverfestigungfaktor | [KV] | 1.000 | 1.000 | 1.000
Gesamteinflussfaktor | [K] | 2.136 | 2.549 | 1.561

Vorhandene Sicherheitszahl für den Dauerfestigkeitsnachweis:
Vergleichsmittelspannung (N/mm²) | [σmV] | | | 47.002
Vergleichsmittelspannung (N/mm²) | [τmV] | | | 27.137
Bauteilwechselfestigkeit (N/mm²) | [σWK] | 67.240 | 69.941 | 69.818
Einflussfaktor Mittelspannungsempf. | [ψσK] | 0.104 | 0.109 | 0.109
Ertragbare Amplitude (N/mm²) | [σADK] | 0.350 | 58.370 | 12.612
Sicherheit gegen Ermüdung | [S] | | | 1.414
Sollsicherheit gegen Ermüdung | [Smin] | | | 1.200
Resultat (%) | [S/Smin] | | | 117.8

Vorhandene Sicherheitszahl
für den Nachweis gegen Überschreiten der Fliessgrenze:
Statische Stützziffer | [K2F] | 1.000 | 1.200 | 1.200
Erhöhungsfaktor | [γF] | 1.000 | 1.000 | 1.000
Bauteilfliessgrenze (N/mm²) | [σFK] | 202.236 | 242.683 | 140.113
Sicherheit Fliessgrenze | [S] | | | 4.238
Sollsicherheit | [Smin] | | | 1.200

Resultat (%) | [S/Smin] | 353.2
Querschnitt 'B-B' | Press-Sitz
Kommentar
Position (Y-Koordinate) (mm) | [y] | 230.000
Aussendurchmesser (mm) | [da] | 80.000
Innendurchmesser (mm) | [di] | 0.000
Kerbwirkung | Press-Sitz
Charakteristik: | Fester Press-Sitz
Mittlere Rauheit (µm) | [Rz] | 8.000
Zug/Druck | Biegung | Torsion | Scherung
Belastung: (N) (Nm)
Mittelwert | [Fzdm, Mbm, Tm, Fqm] | -4677.4 | 0.0 | 3272.7 | 0.0
Ausschlag (Amplitude) | [Fzda, Mba, Ta, Fqa] | 462.6 | 222.9 | 323.7 | 20905.6
Maximalwert | [Fzdmax, Mbmax, Tmax, Fqmax] | -5140.0 | 222.9 | 3596.4 | 20905.6
Querschnitt, Widerstandsmomente: (mm²) (mm3)
[A, Wb, Wt, A] | 5026.5 | 50265.5 | 100531.0 | 5026.5

Spannungen: (N/mm²)
[σzdm, σbm, τm, τqm] (N/mm²) | -0.931 | 0.000 | 32.554 | 0.000
[σzda, σba, τa, τqa] (N/mm²) | 0.092 | 4.435 | 3.220 | 5.545
[σzdmax,σbmax,τmax,τqmax] (N/mm²) | -1.023 | 4.435 | 35.774 | 5.545
Technologischer Grösseneinfluss | [K1(σB)] | 0.990
| [K1(σS)] | 0.861
| | Zug/Druck | Biegung | Torsion
Kerbwirkungszahl | [ß(dB)] | 1.800 | 1.800 | 1.200
[dB] (mm) = | 40.0
Geometrischer Grösseneinfluss | [K3(d)] | 0.960 | 0.960 | 0.987
Geometrischer Grösseneinfluss | [K3(dB)] | 0.971 | 0.971 | 0.991
Kerbwirkungszahl | [ß] | 1.822 | 1.822 | 1.204
Geometrischer Grösseneinfluss | [K2(d)] | 1.000 | 0.842 | 0.842
Einflussfaktor Oberflächenrauheit | [KF] | 1.000 | 1.000 | 1.000
Rauheitsfaktor ist gemäss Norm in der Kerbwirkungszahl inbegriffen

Oberflächenverfestigungfaktor | [KV] | 1.000 | 1.000 | 1.000
Gesamteinflussfaktor | [K] | 1.822 | 2.164 | 1.431

Vorhandene Sicherheitszahl für den Dauerfestigkeitsnachweis:
Vergleichsmittelspannung (N/mm²) | [σmV] | | | 56.378
Vergleichsmittelspannung (N/mm²) | [τmV] | | | 32.550
Bauteilwechselfestigkeit (N/mm²) | [σWK] | 78.818 | 82.381 | 76.163
Einflussfaktor Mittelspannungsempf. | [ψσK] | 0.124 | 0.131 | 0.120
Ertragbare Amplitude (N/mm²) | [σADK] | 0.330 | 17.698 | 12.612
Sicherheit gegen Ermüdung | [S] | | | 1.700
Sollsicherheit gegen Ermüdung | [Smin] | | | 1.200
Resultat (%) | [S/Smin] | | | 141.7

Vorhandene Sicherheitszahl
für den Nachweis gegen Überschreiten der Fliessgrenze:
Statische Stützziffer | [K2F] | 1.000 | 1.200 | 1.200
Erhöhungsfaktor | [γF] | 1.000 | 1.000 | 1.000
Bauteilfliessgrenze (N/mm²) | [σFK] | 202.236 | 242.683 | 140.113
Sicherheit Fliessgrenze | [S] | | | 3.911
Sollsicherheit | [Smin] | | | 1.200
Resultat (%) | [S/Smin] | | | 325.9
Querschnitt 'C-C' | Passfeder
Kommentar | Y= 264.60...344.60mm
Position (Y-Koordinate) (mm) | [y] | 264.610
Aussendurchmesser (mm) | [da] | 85.000
Innendurchmesser (mm) | [di] | 0.000
Kerbwirkung | Passfeder
Anzahl Passfedern | [n] | 1
Nut mit Fingerfräser bearbeitet
Norm: | DIN 6885.1:1968 Standard
[b, t] (mm) | 22.000 9.100
Mittlere Rauheit (µm) | [Rz] | 8.000
Zug/Druck | Biegung | Torsion | Scherung
Belastung: (N) (Nm)
Mittelwert | [Fzdm, Mbm, Tm, Fqm] | -4677.4 | 0.0 | 3272.7 | 0.0
Ausschlag (Amplitude) | [Fzda, Mba, Ta, Fqa] | 462.6 | 946.1 | 323.7 | 20884.8
Maximalwert | [Fzdmax, Mbmax, Tmax, Fqmax] | -5140.0 | 946.1 | 3596.4 | 20884.8

Querschnitt, Widerstandsmomente: (mm²) (mm3)
[A, Wb, Wt, A] | 5674.5 | 60291.6 | 120583.2 | 5674.5

Spannungen: (N/mm²)
[σzdm, σbm, τm, τqm] (N/mm²) | -0.824 | 0.000 | 27.141 | 0.000
[σzda, σba, τa, τqa] (N/mm²) | 0.082 | 15.691 | 2.684 | 4.907
[σzdmax,σbmax,τmax,τqmax] (N/mm²) | -0.906 | 15.691 | 29.825 | 4.907
Technologischer Grösseneinfluss | [K1(σB)] | 0.990
| [K1(σS)] | 0.861
| | Zug/Druck | Biegung | Torsion
Kerbwirkungszahl | [ß(dB)] | 2.100 | 2.100 | 1.300
[dB] (mm) = | 40.0
Geometrischer Grösseneinfluss | [K3(d)] | 0.948 | 0.948 | 0.982
Geometrischer Grösseneinfluss | [K3(dB)] | 0.964 | 0.964 | 0.987
Kerbwirkungszahl | [ß] | 2.136 | 2.136 | 1.308
Geometrischer Grösseneinfluss | [K2(d)] | 1.000 | 0.838 | 0.838
Einflussfaktor Oberflächenrauheit | [KF] | 1.000 | 1.000 | 1.000
Rauheitsfaktor ist gemäss Norm in der Kerbwirkungszahl inbegriffen
Oberflächenverfestigungfaktor | [KV] | 1.000 | 1.000 | 1.000
Gesamteinflussfaktor | [K] | 2.136 | 2.549 | 1.561

Vorhandene Sicherheitszahl für den Dauerfestigkeitsnachweis:
Vergleichsmittelspannung (N/mm²) | [σmV] | | | 47.002
Vergleichsmittelspannung (N/mm²) | [τmV] | | | 27.137
Bauteilwechselfestigkeit (N/mm²) | [σWK] | 67.240 | 69.941 | 69.818
Einflussfaktor Mittelspannungsempf. | [ψσK] | 0.104 | 0.109 | 0.109
Ertragbare Amplitude (N/mm²) | [σADK] | 0.350 | 52.757 | 12.612
Sicherheit gegen Ermüdung | [S] | | | 1.750
Sollsicherheit gegen Ermüdung | [Smin] | | | 1.200
Resultat (%) | [S/Smin] | | | 145.9

Vorhandene Sicherheitszahl
für den Nachweis gegen Überschreiten der Fliessgrenze:
Statische Stützziffer | [K2F] | 1.000 | 1.200 | 1.200
Erhöhungsfaktor | [γF] | 1.000 | 1.000 | 1.000
Bauteilfliessgrenze (N/mm²) | [σFK] | 202.236 | 242.683 | 140.113
Sicherheit Fliessgrenze | [S] | | | 4.521

Sollsicherheit | [Smin] | 1.200
Resultat (%) | [S/Smin] | 376.7
Querschnitt 'D-D' | Wellenabsatz mit Freistich
Kommentar | Y= 257.00mm
Position (Y-Koordinate) (mm) | [y] | 257.000
Aussendurchmesser (mm) | [da] | 85.000
Innendurchmesser (mm) | [di] | 0.000
Kerbwirkung | Wellenabsatz mit Freistich
[D, d, D1, r, t1] (mm) | 108.000 | 84.200 | 85.000 | 1.200 | 0.400
Form B
Mittlere Rauheit (µm) | [Rz] | 8.000
Zug/Druck | Biegung | Torsion | Scherung
Belastung: (N) (Nm)
Mittelwert | [Fzdm, Mbm, Tm, Fqm] | -4677.4 | 0.0 | 3272.7 | 0.0
Ausschlag (Amplitude) | [Fzda, Mba, Ta, Fqa] | 462.6 | 787.1 | 323.7 | 20888.0
Maximalwert | [Fzdmax, Mbmax, Tmax, Fqmax] | -5140.0 | 787.1 | 3596.4 | 20888.0
Querschnitt, Widerstandsmomente: (mm²) (mm3)
[A, Wb, Wt, A] | 5568.2 | 58605.2 | 117210.4 | 5568.2

Spannungen: (N/mm²)
[σzdm, σbm, τm, τqm] (N/mm²) | -0.840 | 0.000 | 27.922 | 0.000
[σzda, σba, τa, τqa] (N/mm²) | 0.083 | 13.431 | 2.761 | 5.002
[σzdmax,σbmax,τmax,τqmax] (N/mm²) | -0.923 | 13.431 | 30.683 | 5.002
Technologischer Grösseneinfluss | [K1(σB)] | 0.990
| [K1(σS)] | 0.861
| | Zug/Druck | Biegung | Torsion
Formzahl | [α] | 3.439 | 3.052 | 2.041
Bezogenes Spannungsgefälle | [G'] | 2.048 | 2.048 | 0.958
Stützziffer | [n] | 1.348 | 1.348 | 1.238
Kerbwirkungszahl | [ß] | 2.551 | 2.264 | 1.648
Geometrischer Grösseneinfluss | [K2(d)] | 1.000 | 0.838 | 0.838
Einflussfaktor Oberflächenrauheit | [KF] | 0.950 | 0.950 | 0.971

Oberflächenverfestigungfaktor | [KV] | 1.000 | 1.000 | 1.000
Gesamteinflussfaktor | [K] | 2.604 | 2.754 | 1.996

Vorhandene Sicherheitszahl für den Dauerfestigkeitsnachweis:
Vergleichsmittelspannung (N/mm²) | [σmV] | | | 48.355
Vergleichsmittelspannung (N/mm²) | [τmV] | | | 27.918
Bauteilwechselfestigkeit (N/mm²) | [σWK] | 55.155 | 64.732 | 54.573
Einflussfaktor Mittelspannungsempf. | [ψσK] | 0.084 | 0.100 | 0.083
Ertragbare Amplitude (N/mm²) | [σADK] | 0.399 | 47.617 | 12.612
Sicherheit gegen Ermüdung | [S] | | | 1.862
Sollsicherheit gegen Ermüdung | [Smin] | | | 1.200
Resultat (%) | [S/Smin] | | | 155.2

Vorhandene Sicherheitszahl
für den Nachweis gegen Überschreiten der Fliessgrenze:
Statische Stützziffer | [K2F] | 1.000 | 1.200 | 1.200
Erhöhungsfaktor | [γF] | 1.150 | 1.150 | 1.000
Bauteilfliessgrenze (N/mm²) | [σFK] | 232.571 | 279.085 | 140.113
Sicherheit Fliessgrenze | [S] | | | 4.476
Sollsicherheit | [Smin] | | | 1.200
Resultat (%) | [S/Smin] | | | 373.0
Querschnitt 'E-E' | Glatte Welle
Kommentar | Y= 257.00mm
Position (Y-Koordinate) (mm) | [y] | 264.590
Aussendurchmesser (mm) | [da] | 85.000
Innendurchmesser (mm) | [di] | 0.000
Kerbwirkung | Glatte Welle
Mittlere Rauheit (µm) | [Rz] | 8.000
Zug/Druck | Biegung | Torsion | Scherung
Belastung: (N) (Nm)
Mittelwert | [Fzdm, Mbm, Tm, Fqm] | -4677.4 | 0.0 | 3272.7 | 0.0
Ausschlag (Amplitude) | [Fzda, Mba, Ta, Fqa] | 462.6 | 945.6 | 323.7 | 20884.8
Maximalwert | [Fzdmax, Mbmax, Tmax, Fqmax] | -5140.0 | 945.6 | 3596.4 | 20884.8
Querschnitt, Widerstandsmomente: (mm²) (mm3)
[A, Wb, Wt, A] | 5674.5 | 60291.6 | 120583.2 | 5674.5

Spannungen: (N/mm²)
[σzdm, σbm, τm, τqm] (N/mm²) | -0.824 | 0.000 | 27.141 | 0.000
[σzda, σba, τa, τqa] (N/mm²) | 0.082 | 15.684 | 2.684 | 4.907
[σzdmax,σbmax,τmax,τqmax] (N/mm²) | -0.906 | 15.684 | 29.825 | 4.907
Technologischer Grösseneinfluss | [K1(σB)] | 0.990
| [K1(σS)] | 0.861
| | Zug/Druck | Biegung | Torsion
Kerbwirkungszahl | [ß] | 1.000 | 1.000 | 1.000
Geometrischer Grösseneinfluss | [K2(d)] | 1.000 | 0.838 | 0.838
Einflussfaktor Oberflächenrauheit | [KF] | 0.950 | 0.950 | 0.971
Oberflächenverfestigungfaktor | [KV] | 1.000 | 1.000 | 1.000
Gesamteinflussfaktor | [K] | 1.053 | 1.246 | 1.223

Vorhandene Sicherheitszahl für den Dauerfestigkeitsnachweis:
Vergleichsmittelspannung (N/mm²) | [σmV] | | | 47.002
Vergleichsmittelspannung (N/mm²) | [τmV] | | | 27.137
Bauteilwechselfestigkeit (N/mm²) | [σWK] | 136.454 | 143.093 | 89.089
Einflussfaktor Mittelspannungsempf. | [ψσK] | 0.237 | 0.251 | 0.143
Ertragbare Amplitude (N/mm²) | [σADK] | 0.350 | 60.720 | 12.612
Sicherheit gegen Ermüdung | [S] | | | 1.868
Sollsicherheit gegen Ermüdung | [Smin] | | | 1.200
Resultat (%) | [S/Smin] | | | 155.7

Vorhandene Sicherheitszahl
für den Nachweis gegen Überschreiten der Fliessgrenze:
Statische Stützziffer | [K2F] | 1.000 | 1.200 | 1.200
Erhöhungsfaktor | [γF] | 1.000 | 1.000 | 1.000
Bauteilfliessgrenze (N/mm²) | [σFK] | 202.236 | 242.683 | 140.113
Sicherheit Fliessgrenze | [S] | | | 4.521
Sollsicherheit | [Smin] | | | 1.200
Resultat (%) | [S/Smin] | | | 376.7
Querschnitt 'F-F' | Wellenabsatz
Kommentar | Y= 232.00mm

Position (Y-Koordinate) (mm) | [y] | 232.000
Aussendurchmesser (mm) | [da] | 80.000
Innendurchmesser (mm) | [di] | 0.000
Kerbwirkung | Wellenabsatz
[D, r, t] (mm) | 108.000 | 1.000 | 14.000
Mittlere Rauheit (µm) | [Rz] | 8.000
Zug/Druck | Biegung | Torsion | Scherung
Belastung: (N) (Nm)
Mittelwert | [Fzdm, Mbm, Tm, Fqm] | -4677.4 | 0.0 | 3272.7 | 0.0
Ausschlag (Amplitude) | [Fzda, Mba, Ta, Fqa] | 462.6 | 264.7 | 323.7 | 20904.8
Maximalwert | [Fzdmax, Mbmax, Tmax, Fqmax] | -5140.0 | 264.7 | 3596.4 | 20904.8
Querschnitt, Widerstandsmomente: (mm²) (mm3)
[A, Wb, Wt, A] | 5026.5 | 50265.5 | 100531.0 | 5026.5

Spannungen: (N/mm²)
[σzdm, σbm, τm, τqm] (N/mm²) | -0.931 | 0.000 | 32.554 | 0.000
[σzda, σba, τa, τqa] (N/mm²) | 0.092 | 5.266 | 3.220 | 5.545
[σzdmax,σbmax,τmax,τqmax] (N/mm²) | -1.023 | 5.266 | 35.774 | 5.545
Technologischer Grösseneinfluss | [K1(σB)] | 0.990
| [K1(σS)] | 0.861
| | Zug/Druck | Biegung | Torsion
Formzahl | [α] | 3.709 | 3.255 | 2.158
Bezogenes Spannungsgefälle | [G'] | 2.436 | 2.436 | 1.150
Stützziffer | [n] | 1.380 | 1.380 | 1.261
Kerbwirkungszahl | [ß] | 2.689 | 2.359 | 1.712
Geometrischer Grösseneinfluss | [K2(d)] | 1.000 | 0.842 | 0.842
Einflussfaktor Oberflächenrauheit | [KF] | 0.950 | 0.950 | 0.971
Oberflächenverfestigungfaktor | [KV] | 1.000 | 1.000 | 1.000
Gesamteinflussfaktor | [K] | 2.741 | 2.855 | 2.062

Vorhandene Sicherheitszahl für den Dauerfestigkeitsnachweis:
Vergleichsmittelspannung (N/mm²) | [σmV] | | | 56.378
Vergleichsmittelspannung (N/mm²) | [τmV] | | | 32.550
Bauteilwechselfestigkeit (N/mm²) | [σWK] | 52.388 | 62.453 | 52.827
Einflussfaktor Mittelspannungsempf. | [ψσK] | 0.079 | 0.096 | 0.080
Ertragbare Amplitude (N/mm²) | [σADK] | 0.379 | 23.843 | 12.612

Sicherheit gegen Ermüdung | [S] | | | 1.889
Sollsicherheit gegen Ermüdung | [Smin] | | | 1.200
Resultat (%) | [S/Smin] | | | 157.4

Vorhandene Sicherheitszahl
für den Nachweis gegen Überschreiten der Fliessgrenze:
Statische Stützziffer | [K2F] | 1.000 | 1.200 | 1.200
Erhöhungsfaktor | [γF] | 1.150 | 1.150 | 1.000
Bauteilfliessgrenze (N/mm²) | [σFK] | 232.571 | 279.085 | 140.113
Sicherheit Fliessgrenze | [S] | | | 3.910
Sollsicherheit | [Smin] | | | 1.200
Resultat (%) | [S/Smin] | | | 325.9
Hinweise: - | Die Querkraft wird bei der Berechnung nach DIN 743 nicht berücksichtigt. - | Querschnitt mit Presssitz: Die Kerbfaktoren für den Fall 'Leichter Presssitz' sind nicht mehr definiert in DIN743. Die Faktoren werden aus der FKM-Richtlinine übernommen, ausser die Faktoren für den 'festen Pressitz' nach DIN sind kleiner, dann werden diese verwendet. Ende Protokoll

Zeilen: 883
