Mofiche/Getriebebeleg/Dokumentation/KissSoft/Getriebebeleg - Eingangswelle.pdf

KISSsoft Release 2020 B
KISSsoft – student license (not for commercial use) Projekt
Name | : | Getriebebeleg
Beschreibung: | MEIII Beleg
Kunde | : | Prof. Fischer
| | | Datei
Name | : | Eingangswelle
Geändert von: | Moritz | am: 18.06.2021 | um: 09:54:51

Wichtiger Hinweis: Bei der Berechnung sind Warnungen aufgetreten:

1-> Berechnung Kerbfaktor für Rechtecknut:
Als Bezugsdurchmesser wird dB = 30.00 mm verwendet, der Strukturradius ro* wird nach der Formel für Stahl berechnet. 2-> Berechnung Kerbfaktor für Rechtecknut:

Als Bezugsdurchmesser wird dB = 30.00 mm verwendet, der Strukturradius ro* wird nach der Formel für Stahl berechnet. Berechnung von Wellen, Achsen und Trägern

Eingabedaten

Koordinatensystem Welle: | siehe Bild W-002
Bezeichnung | Welle 1
Zeichnung
Startposition (mm) | | 0.000
Länge (mm) | | 257.000
Drehzahl (1/min) | | 950.00
Drehrichtung: | im Uhrzeigersinn
Werkstoff | C60
Elastizitätsmodul (N/mm²) | | 206000.000
Poissonzahl nu | | 0.300
Dichte (kg/m³) | | 7830.000
Wärmeausdehnungskoeffizient | (10^-6/K) | 11.500

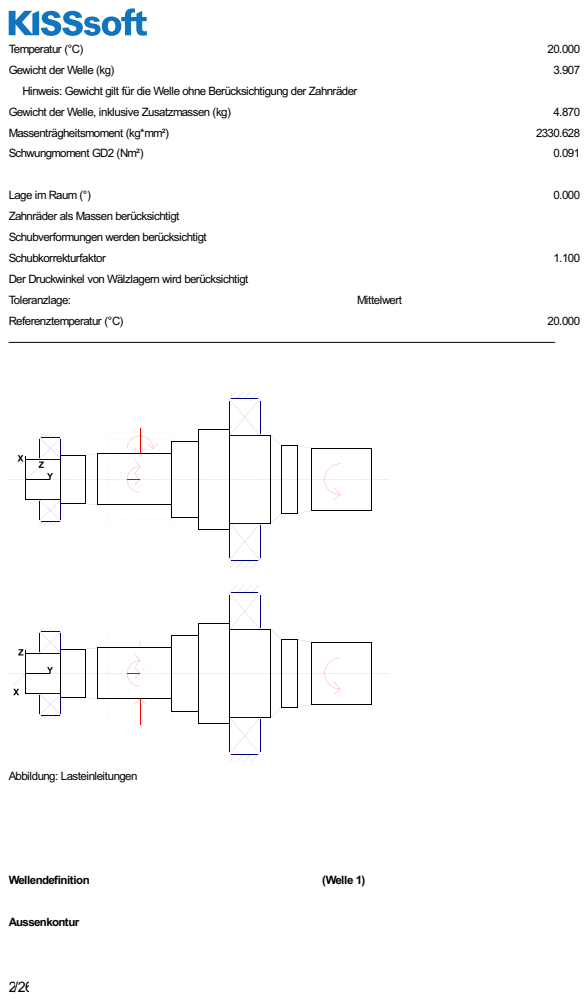
[picture p10: page 2]
Temperatur (°C); Gewicht der Welle (kg); Gewicht der Welle, inklusive Zusatzmassen (kg); Massenträgheitsmoment (kg*mm²); Schwungmoment GD2 (Nm²); Lage im Raum (°); Schubkorrekturfaktor; Toleranzlage:; Mittelwert; Referenztemperatur (°C); Abbildung: Lasteinleitungen; Wellendefinition; (Welle 1); Aussenkontur

Hinweis: Gewicht gilt für die Welle ohne Berücksichtigung der Zahnräder

Zahnräder als Massen berücksichtigt
Schubverformungen werden berücksichtigt
Der Druckwinkel von Wälzlagern wird berücksichtigt

Zylinder (Zylinder) | 0.000 mm ... | 26.000 mm
Durchmesser (mm) | [d] | 30.0000
Länge (mm) | [l] | 26.0000
Rauhigkeit (µm) | [Rz] | 8.0000

Fase links (Fase links)
l=2.00 (mm), alpha=45.00 (°)

Rechtecknut (Rechtecknut)
b=1.60 (mm), t=0.70 (mm), r=0.15 (mm), Rz=8.0, Gedreht (Ra=3.2μm/125μin)

Radius rechts (Radius rechts)
r=0.75 (mm), Rz=8.0, Gedreht (Ra=3.2μm/125μin)
Zylinder (Zylinder) | 26.000 mm ... | 44.000 mm
Durchmesser (mm) | [d] | 36.0000
Länge (mm) | [l] | 18.0000
Rauhigkeit (µm) | [Rz] | 8.0000
Konus (Konus) | 44.000 mm ... | 53.000 mm
Durchmesser links (mm) | [dl] | 36.0000
Durchmesser rechts (mm) | [dr] | 38.0000
Länge (mm) | [l] | 9.0000
Rauhigkeit (µm) | [Rz] | 8.0000
Zylinder (Zylinder) | 53.000 mm ... | 108.000 mm
Durchmesser (mm) | [d] | 38.0000
Länge (mm) | [l] | 55.0000
Rauhigkeit (µm) | [Rz] | 8.0000

Rechtecknut (Rechtecknut)
b=1.85 (mm), t=1.00 (mm), r=0.17 (mm), Rz=8.0, Gedreht (Ra=3.2μm/125μin)

Freistich rechts (Freistich rechts)
r=0.80 (mm), t=0.30 (mm), l=2.50 (mm), Rz=32.0, Gedreht (Ra=3.2μm/125μin)
Form E (DIN 509), Reihe 1, mit üblicher Beanspruchung
Passfedernut (Passfedernut) | 66.000 mm ... | 102.000 mm
l=36.00 (mm), i=1, Rz=8.0, Gedreht (Ra=3.2μm/125μin)

Zylinder (Zylinder) | 108.000 mm ... | 128.000 mm
Durchmesser (mm) | [d] | 56.0000
Länge (mm) | [l] | 20.0000
Rauhigkeit (µm) | [Rz] | 8.0000

Radius rechts (Radius rechts)
r=2.00 (mm), Rz=8.0, Gedreht (Ra=3.2μm/125μin)
Zylinder (Zylinder) | 128.000 mm ... | 151.000 mm
Durchmesser (mm) | [d] | 74.0000
Länge (mm) | [l] | 23.0000
Rauhigkeit (µm) | [Rz] | 8.0000
Zylinder (Zylinder) | 151.000 mm ... | 182.000 mm
Durchmesser (mm) | [d] | 65.0000
Länge (mm) | [l] | 31.0000
Rauhigkeit (µm) | [Rz] | 8.0000

Rechtecknut (Rechtecknut)
b=2.65 (mm), t=1.50 (mm), r=0.25 (mm), Rz=8.0, Gedreht (Ra=3.2μm/125μin)

Freistich links (Freistich links)
r=0.80 (mm), t=0.30 (mm), l=2.50 (mm), Rz=32.0, Gedreht (Ra=3.2μm/125μin) Form E (DIN 509), Reihe 1, mit üblicher Beanspruchung
Konus (Konus) | 182.000 mm ... | 190.000 mm
Durchmesser links (mm) | [dl] | 65.0000
Durchmesser rechts (mm) | [dr] | 50.0000
Länge (mm) | [l] | 8.0000
Rauhigkeit (µm) | [Rz] | 8.0000
Zylinder (Zylinder) | 190.000 mm ... | 202.000 mm
Durchmesser (mm) | [d] | 50.0000
Länge (mm) | [l] | 12.0000
Rauhigkeit (µm) | [Rz] | 1.8000
Konus (Konus) | 202.000 mm ... | 212.000 mm
Durchmesser links (mm) | [dl] | 50.0000
Durchmesser rechts (mm) | [dr] | 46.5000

Länge (mm) | [l] | 10.0000
Rauhigkeit (µm) | [Rz] | 8.0000
Zylinder (Zylinder) | 212.000 mm ... | 257.000 mm
Durchmesser (mm) | [d] | 46.5000
Länge (mm) | [l] | 45.0000
Rauhigkeit (µm) | [Rz] | 8.0000

Fase rechts (Fase rechts)
l=2.00 (mm), alpha=45.00 (°)
Passfedernut (Passfedernut) | 215.500 mm ... | 251.500 mm
l=36.00 (mm), i=1, Rz=8.0, Gedreht (Ra=3.2μm/125μin)

Kräfte

Art des Kraftelements | Kupplung/Motor
Bezeichnung im Modell | Kupplung/Motor
Position auf Welle (mm) | [ylocal] | 233.5000
Position im globalen System (mm) | [yglobal] | 233.5000
Wirkdurchmesser (mm) | 0.0000
Radialkraftfaktor (-) | 0.0000
Richtung der Radialkraft (°) | 0.0000
Axialkraftfaktor (-) | 0.0000
Länge der Krafteinleitung (mm) | 36.0000
Leistung (kW) | 40.0000 | getrieben
(Antrieb)
Drehmoment (Nm) | 402.0756
Axialkraft (N) | 0.0000
Querkraft X (N) | 0.0000
Querkraft Z (N) | 0.0000
Biegemoment X (Nm) | 0.0000
Biegemoment Z (Nm) | 0.0000
Masse (kg) | 0.0000
Massenträgheitsmoment Jp (kg*m²) | 0.0000
Massenträgheitsmoment Jxx (kg*m²) | 0.0000
Massenträgheitsmoment Jzz (kg*m²) | 0.0000
Exzentrizität (mm) | 0.0000
Art des Kraftelements | Stirnrad
Bezeichnung im Modell | Stirnrad

Position auf Welle (mm) | [ylocal] | 84.7500
Position im globalen System (mm) | [yglobal] | 84.7500
Wälzkreisdurchmesser (mm) | 69.3578
Schrägungswinkel (°) | 10.1167 | rechts
Betriebseingriffswinkel im Normalschnitt (°) | 21.7258
Position des Eingriffs (°) | 0.0000
Länge der Krafteinleitung (mm) | 46.5000
Leistung (kW) | 40.0000 | treibend
(Abtrieb)
Drehmoment (Nm) | -402.0756
Axialkraft (N) | 2068.7319
Querkraft X (N) | -4692.9324
Querkraft Z (N) | 11594.2448
Biegemoment X (Nm) | -0.0000
Biegemoment Z (Nm) | 71.7413

Lager

---------------------------------------------------------------------------------------------------------------------------- Bezeichnung im Modell | LL
Lager Typ | SKF NJ 206 ECP
Lager Bauform | Zylinderrollenlager (einreihig)
SKF Explorer
Lager Position (mm) | [ylokal] | 18.000
Lager Position (mm) | [yglobal] | 18.000
Befestigung Aussenring | Loslager
Innendurchmesser (mm) | [d] | 30.000
Aussendurchmesser (mm) | [D] | 62.000
Breite (mm) | [b] | 16.000
Eckradius (mm) | [r] | 1.000
Statische Tragzahl (kN) | [C0] | 36.500
Dynamische Tragzahl (kN) | [C] | 44.000
Tragzahl Ermüdung (kN) | [Cu] | 4.500
Werte für die approximierte Geometrie:
Dynamische Tragzahl (kN) | [Ctheo] | 0.000
Statische Tragzahl (kN) | [C0theo] | 0.000
Korrekturfaktor Dynamische Tragzahl | [fC] | 1.000
Korrekturfaktor Statische Tragzahl | [fC0] | 1.000
---------------------------------------------------------------------------------------------------------------------------- Bezeichnung im Modell | FL
Lager Typ | SKF 6213
Lager Bauform | Rillenkugellager (einreihig)

SKF Explorer
Lager Position (mm) | [ylokal] | 162.500
Lager Position (mm) | [yglobal] | 162.500
Befestigung Aussenring | Festlager
Innendurchmesser (mm) | [d] | 65.000
Aussendurchmesser (mm) | [D] | 120.000
Breite (mm) | [b] | 23.000
Eckradius (mm) | [r] | 1.500
Statische Tragzahl (kN) | [C0] | 40.500
Dynamische Tragzahl (kN) | [C] | 58.500
Tragzahl Ermüdung (kN) | [Cu] | 1.700
Werte für die approximierte Geometrie:
Dynamische Tragzahl (kN) | [Ctheo] | 0.000
Statische Tragzahl (kN) | [C0theo] | 0.000
Korrekturfaktor Dynamische Tragzahl | [fC] | 1.000
Korrekturfaktor Statische Tragzahl | [fC0] | 1.000
---------------------------------------- Welle 'Welle 1': Die Masse von folgendem Element wird berücksichtigt (y= | 84.7500 (mm)): Stirnrad
'Stirnrad' m (yS= | 84.7500 (mm)): | 0.9627 (kg)
Jp: | 0.0008 (kg*m²), Jxx: | 0.0005 (kg*m²), Jzz: | 0.0005 (kg*m²)

Resultate

Welle

Maximale Durchbiegung (μm) | 46.554
Position des Maximums (mm) | 80.149
Massenschwerpunkt (mm) | 146.928
Summe der axialen Belastung (N) | 2068.732
Verdrehung unter Drehmoment (°) | 0.073

Lager

Ausfallwahrscheinlichkeit | [n] | 10.00 | %

Axialspiel (ISO 281) | [uA] | 10.00
µm
Schmierstoff | ISO-VG 220
Schmierstoff - Betriebstemperatur | [TB] | 70.00 | °C
Wälzlager klassisch (Druckwinkel berücksichtigen)
Welle 'Welle 1' Wälzlager 'LL' Position (Y-Koordinate) | [y] | 18.00 | mm
Dynamisch äquivalente Belastung | [P] | 6.55 | kN
Statisch äquivalente Belastung | [P0] | 6.55 | kN
Faktor für Ausfallwahrscheinlichkeit | [a1] | 1.000

Ergebnisse nach ISO 281:
Schmierstoff | ISO-VG 220
Lastverhältnis | [C/P] | 6.717
Betriebsviskosität | [ν] | 48.884
mm²/s
Bezugsviskosität | [ν1] | 0.000
mm²/s
Viskositätsverhältnis | [κ] | 0.000
Nominelle Lagerlebensdauer | [Lnh] | 10031.02 | h
Statischer Sicherheitsfaktor | [S0] | 5.57
Lagerreaktionskraft | [Fx] | 2.028 | kN
Lagerreaktionskraft | [Fy] | 0.000 | kN
Lagerreaktionskraft | [Fz] | -6.229 | kN
Lagerreaktionskraft | [Fr] | 6.551 | kN (-71.96°)
Ölstand | [H] | 0.000 | mm
Rollreibungsmoment | [Mrr] | 0.101
Nm
Gleitreibungsmoment | [Msl] | 0.010
Nm
Reibungsmoment Dichtungen | [Mseal] | 0.000
Nm
Reibungsmoment Dichtungen nach SKF-Hauptkatalog 17000/1 EN:2018 bestimmt
Reibungsmoment Strömungsverluste | [Mdrag] | 0.000
Nm
Reibungsmoment | [Mloss] | 0.111
Nm
Verlustleistung | [Ploss] | 11.012 | W
Das Reibungsmoment wird nach Angaben aus dem SKF-Katalog 2018 berechnet. Es wird immer mit einem Beiwert für Zusätze im Schmierstoff μbl=0.15 gerechnet. Lagerverschiebung | [ux] | -4.968

µm

Lagerverschiebung | [uy] | 10.376
µm
Lagerverschiebung | [uz] | 15.472
µm
Lagerverschiebung | [ur] | 16.250
µm | (107.8°)
Lagerneigung | [rx] | 0.595
mrad | (2.05')
Lagerneigung | [ry] | -0.000
mrad | (0')
Lagerneigung | [rz] | 0.241
mrad | (0.83')
Lagerneigung | [rr] | 0.642
mrad | (2.21')
Welle 'Welle 1' Wälzlager 'FL' Position (Y-Koordinate) | [y] | 162.50 | mm
Dynamisch äquivalente Belastung | [P] | 6.79 | kN
Statisch äquivalente Belastung | [P0] | 5.95 | kN
Faktor für Ausfallwahrscheinlichkeit | [a1] | 1.000

Ergebnisse nach ISO 281:
Schmierstoff | ISO-VG 220
Lastverhältnis | [C/P] | 8.610
Betriebsviskosität | [ν] | 48.884
mm²/s
Bezugsviskosität | [ν1] | 0.000
mm²/s
Viskositätsverhältnis | [κ] | 0.000
Nominelle Lagerlebensdauer | [Lnh] | 11199.62 | h
Statischer Sicherheitsfaktor | [S0] | 6.81
Lagerreaktionskraft | [Fx] | 2.664 | kN
Lagerreaktionskraft | [Fy] | -2.068 | kN
Lagerreaktionskraft | [Fz] | -5.317 | kN
Lagerreaktionskraft | [Fr] | 5.947 | kN (-63.39°)
Ölstand | [H] | 0.000 | mm
Rollreibungsmoment | [Mrr] | 0.362
Nm
Gleitreibungsmoment | [Msl] | 0.182
Nm
Reibungsmoment Dichtungen | [Mseal] | 0.000
Nm
Reibungsmoment Dichtungen nach SKF-Hauptkatalog 17000/1 EN:2018 bestimmt

Reibungsmoment Strömungsverluste | [Mdrag] | 0.000
Nm
Reibungsmoment | [Mloss] | 0.545
Nm
Verlustleistung | [Ploss] | 54.187 | W
Das Reibungsmoment wird nach Angaben aus dem SKF-Katalog 2018 berechnet. Es wird immer mit einem Beiwert für Zusätze im Schmierstoff μbl=0.15 gerechnet. Lagerverschiebung | [ux] | -4.017

µm
Lagerverschiebung | [uy] | 10.000
µm
Lagerverschiebung | [uz] | 8.054
µm
Lagerverschiebung | [ur] | 9.000
µm | (116.51°)
Lagerneigung | [rx] | -0.509
mrad | (-1.75')
Lagerneigung | [ry] | 0.754
mrad | (2.59')
Lagerneigung | [rz] | -0.192
mrad | (-0.66')
Lagerneigung | [rr] | 0.543
mrad | (1.87')
Schädigung (%), bezogen auf die Soll-Lebensdauer | [Lreq] ( 10000.000 | )
Lastfall | B1 | B2
1 | 99.69 | 89.29
---------------------------- Σ 99.69 | 89.29
Ausnutzung (%), bezogen auf die Soll-Lebensdauer | [Lreq] ( 10000.000 | )
B1 | B2
99.91 | 96.29
Hinweis: Ausnutzung = (Lreq/Lh)^(1/k)
Kugellager: k = 3, Rollenlager: k = 10/3

B 1 : LL
B 2 : FL

Berechnung der Faktoren für die Bestimmung der Zuverlässigkeit R(t) mit Weibull-Verteilung; t in (h): keine Berechnung der Zuverlässigkeit

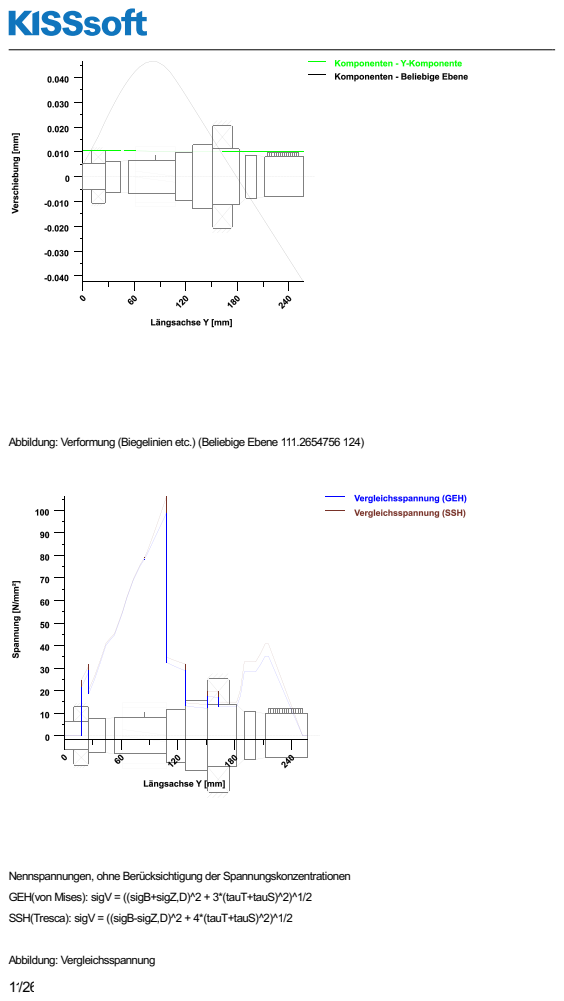
[picture p11: page 11]
Abbildung: Vergleichsspannung

Abbildung: Verformung (Biegelinien etc.) (Beliebige Ebene 111.2654756 124)

Nennspannungen, ohne Berücksichtigung der Spannungskonzentrationen
GEH(von Mises): sigV = ((sigB+sigZ,D)^2 + 3*(tauT+tauS)^2)^1/2
SSH(Tresca): sigV = ((sigB-sigZ,D)^2 + 4*(tauT+tauS)^2)^1/2

### Eigenfrequenzen

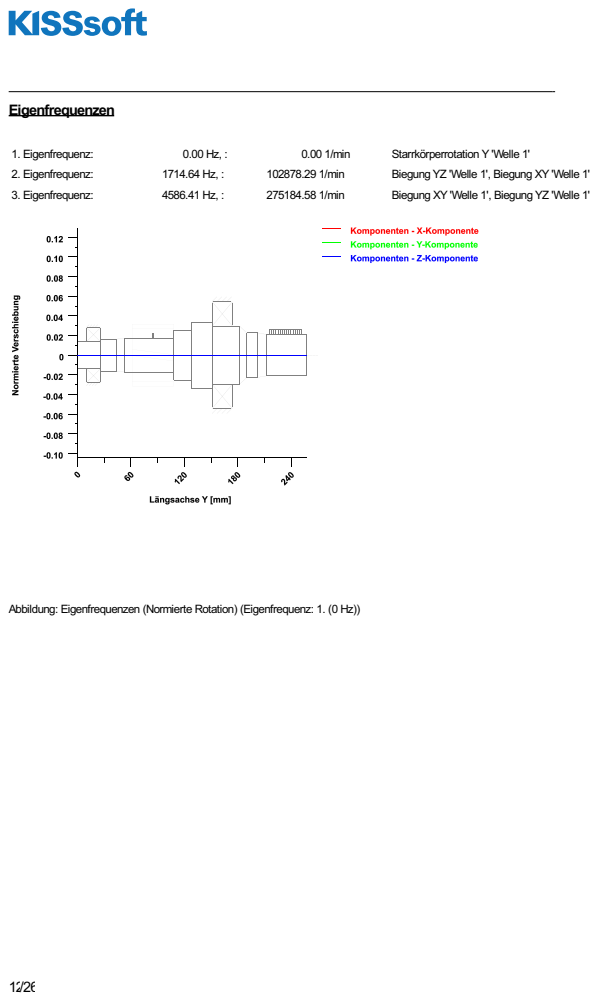
[picture p12: page 12]
1. Eigenfrequenz:; 0.00 1/min; Starrkörperrotation Y 'Welle 1' 2. Eigenfrequenz:; 102878.29 1/min; Biegung YZ 'Welle 1', Biegung XY 'Welle 1' 3. Eigenfrequenz:; 275184.58 1/min; Biegung XY 'Welle 1', Biegung YZ 'Welle 1'

Abbildung: Eigenfrequenzen (Normierte Rotation) (Eigenfrequenz: 1. (0 Hz))

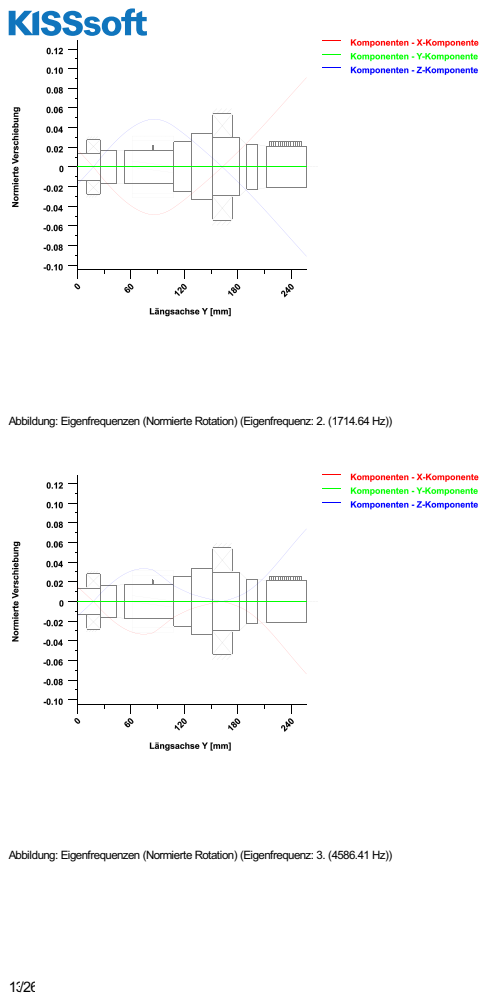
[picture p13: page 13]

Abbildung: Eigenfrequenzen (Normierte Rotation) (Eigenfrequenz: 2. (1714.64 Hz))

Abbildung: Eigenfrequenzen (Normierte Rotation) (Eigenfrequenz: 3. (4586.41 Hz))

### Festigkeitsberechnung nach DIN 743:2012

Zusammenfassung

Welle 1

Werkstoff | C60
Werkstoffart | Vergütungsstahl
Werkstoff-Behandlung | unlegiert, vergütet
Oberflächen-Behandlung | Keine

Berechnung der Dauerfestigkeit und der statischen Festigkeit

Berechnung für Beanspruchungsfall 2 (σav/σmv = konst)
Querschnitt | Lage (Y-Koor) (mm)
A-A | 101.36 | Passfeder
B-B | 101.99 | Passfeder
C-C | 108.00 | Wellenabsatz mit Freistich
D-D | 61.50 | Rechtecknut
E-E | 60.67 | Rechtecknut
F-F | 66.01 | Passfeder

Resultate:
Querschnitt | βσ | KFσ | K2d | SD | SS
A-A | 2.60 | 1.00 | 0.89 | 1.28 | 5.77
B-B | 2.60 | 1.00 | 0.89 | 1.29 | 5.75
C-C | 2.31 | 0.82 | 0.89 | 1.32 | 5.57
D-D | 2.66 | 1.06 | 0.90 | 1.76 | 8.63
E-E | 2.66 | 1.06 | 0.90 | 1.79 | 8.80
F-F | 2.60 | 1.00 | 0.89 | 1.81 | 8.36
Sollsicherheiten: | | | | 1.20 | 1.20

Abkürzungen:
βσ: Kerbfaktor Biegung
KFσ: Oberflächenfaktor
K2d: Grössenfaktor Biegung SD: Sicherheit Dauerfestigkeit SS: Sicherheit Streckgrenze

Ausnutzung (%) | [Smin/S]
Querschnitt | Statisch | Dauerfest
A-A | 20.808 | 93.389
B-B | 20.866 | 93.275
C-C | 21.561 | 90.954
D-D | 13.902 | 68.301
E-E | 13.638 | 67.006
F-F | 14.358 | 66.247
Maximale Ausnutzung (%) | [A] | 93.389

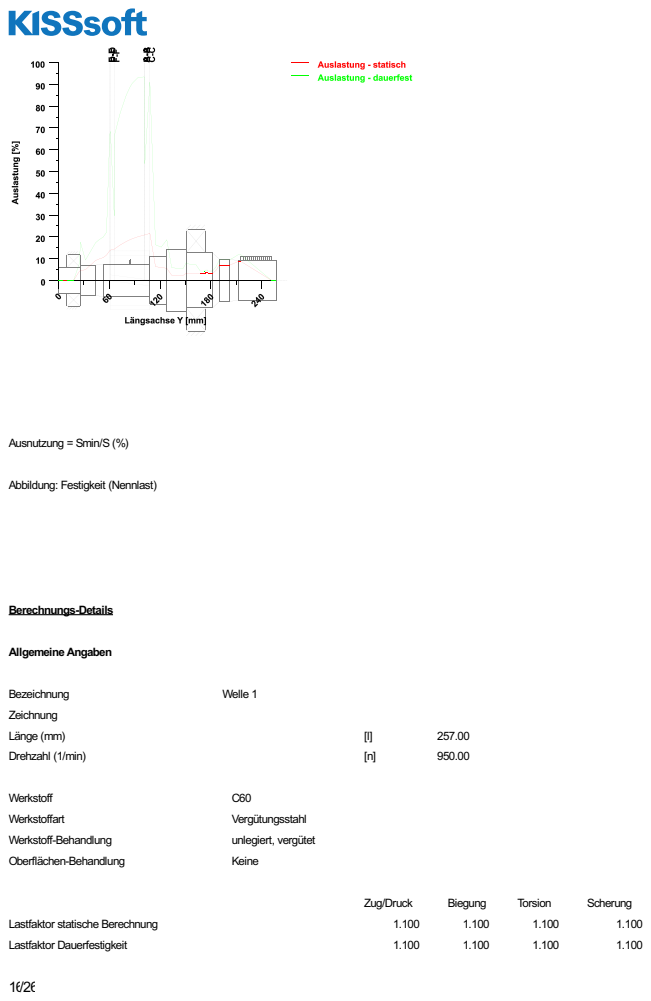
[picture p14: page 16]
Ausnutzung = Smin/S (%); Berechnungs-Details; Allgemeine Angaben; Bezeichnung; Welle 1; Zeichnung; Länge (mm); Drehzahl (1/min); Werkstoff; Werkstoffart; Vergütungsstahl; Werkstoff-Behandlung; unlegiert, vergütet; Oberflächen-Behandlung; Keine; Zug/Druck; Biegung; Torsion; Scherung; Lastfaktor statische Berechnung; Lastfaktor Dauerfestigkeit

Abbildung: Festigkeit (Nennlast)

Bezugsdurchmesser Werkstoff (mm) | [dB] | 16.00
σB nach DIN 743, bei dB (N/mm²) | [σB] | 850.00
σS nach DIN 743, bei dB (N/mm²) | [σS] | 580.00
[σzdW], bei dB (N/mm²) | 340.00
[σbW], | bei dB (N/mm²) | 425.00
[τtW], | bei dB (N/mm²) | 250.00
Dicke Rohmaterial (mm) | [dWerkst] | 75.00
Werkstoffdaten nach DIN743/3 mit K1(d) berechnet
Werkstoff-Festigkeitswerte aus Dicke Rohmaterial bestimmt
Geometrischer Grössenfaktor K1d mit Rohdurchmesser berechnet
[σBeff] (N/mm²) | 701.72
[σSeff] (N/mm²) | 447.69
[σbFK] (N/mm²) | 537.23
[τtFK] (N/mm²) | 310.17
[σbBRand] (N/mm²) | 743.75
[σzdW] (N/mm²) | 280.69
[σbW] (N/mm²) | 350.86
[τtW] (N/mm²) | 206.39

Dauerfestigkeit für Einstufenbeanspruchung

Berechnung für Beanspruchungsfall 2 (σ.av/σ.mv = konst)

Querschnitt 'A-A' | Passfeder
Kommentar | Y= 66.00...102.00mm
Position (Y-Koordinate) (mm) | [y] | 101.357
Aussendurchmesser (mm) | [da] | 38.000
Innendurchmesser (mm) | [di] | 0.000
Kerbwirkung | Passfeder
Anzahl Passfedern | [n] | 1
Nut mit Fingerfräser bearbeitet
Norm: | DIN 6885.1:1968 Standard
[b, t] (mm) | 10.000 5.100
Mittlere Rauheit (µm) | [Rz] | 8.000
Zug/Druck | Biegung | Torsion | Scherung
Belastung: (N) (Nm)
Mittelwert | [Fzdm, Mbm, Tm, Fqm] | -1774.5 | 0.0 | 345.0 | 0.0
Ausschlag (Amplitude) | [Fzda, Mba, Ta, Fqa] | 175.5 | 390.6 | 34.1 | 4614.8
Maximalwert | [Fzdmax, Mbmax, Tmax, Fqmax] | -1950.0 | 390.6 | 379.1 | 4614.8
Querschnitt, Widerstandsmomente: (mm²) (mm3)

[A, Wb, Wt, A] | 1134.1 | 5387.0 | 10774.1 | 1134.1

Spannungen: (N/mm²)
[σzdm, σbm, τm, τqm] (N/mm²) | -1.565 | 0.000 | 32.019 | 0.000
[σzda, σba, τa, τqa] (N/mm²) | 0.155 | 72.516 | 3.167 | 5.425
[σzdmax,σbmax,τmax,τqmax] (N/mm²) | -1.719 | 72.516 | 35.186 | 5.425
Technologischer Grösseneinfluss | [K1(σB)] | 0.826
| [K1(σS)] | 0.772
| | Zug/Druck | Biegung | Torsion
Kerbwirkungszahl | [ß(dB)] | 2.603 | 2.603 | 1.602
[dB] (mm) = | 40.0
Geometrischer Grösseneinfluss | [K3(d)] | 0.955 | 0.955 | 0.978
Geometrischer Grösseneinfluss | [K3(dB)] | 0.954 | 0.954 | 0.977
Kerbwirkungszahl | [ß] | 2.600 | 2.600 | 1.601
Geometrischer Grösseneinfluss | [K2(d)] | 1.000 | 0.892 | 0.892
Einflussfaktor Oberflächenrauheit | [KF] | 1.000 | 1.000 | 1.000
Rauheitsfaktor ist gemäss Norm in der Kerbwirkungszahl inbegriffen
Oberflächenverfestigungfaktor | [KV] | 1.000 | 1.000 | 1.000
Gesamteinflussfaktor | [K] | 2.600 | 2.915 | 1.795

Vorhandene Sicherheitszahl für den Dauerfestigkeitsnachweis:
Vergleichsmittelspannung (N/mm²) | [σmV] | | | 55.437
Vergleichsmittelspannung (N/mm²) | [τmV] | | | 32.007
Bauteilwechselfestigkeit (N/mm²) | [σWK] | 107.975 | 120.348 | 114.978
Einflussfaktor Mittelspannungsempf. | [ψσK] | 0.083 | 0.094 | 0.089
Ertragbare Amplitude (N/mm²) | [σADK] | 1.246 | 112.295 | 27.925
Sicherheit gegen Ermüdung | [S] | | | 1.285
Sollsicherheit gegen Ermüdung | [Smin] | | | 1.200
Resultat (%) | [S/Smin] | | | 107.1

Vorhandene Sicherheitszahl
für den Nachweis gegen Überschreiten der Fliessgrenze:
Statische Stützziffer | [K2F] | 1.000 | 1.200 | 1.200
Erhöhungsfaktor | [γF] | 1.000 | 1.000 | 1.000
Bauteilfliessgrenze (N/mm²) | [σFK] | 447.690 | 537.228 | 310.169
Sicherheit Fliessgrenze | [S] | | | 5.767
Sollsicherheit | [Smin] | | | 1.200

Resultat (%) | [S/Smin] | 480.6
Querschnitt 'B-B' | Passfeder
Kommentar | Y= 66.00...102.00mm
Position (Y-Koordinate) (mm) | [y] | 101.990
Aussendurchmesser (mm) | [da] | 38.000
Innendurchmesser (mm) | [di] | 0.000
Kerbwirkung | Passfeder
Anzahl Passfedern | [n] | 1
Nut mit Fingerfräser bearbeitet
Norm: | DIN 6885.1:1968 Standard
[b, t] (mm) | 10.000 5.100
Mittlere Rauheit (µm) | [Rz] | 8.000
Zug/Druck | Biegung | Torsion | Scherung
Belastung: (N) (Nm)
Mittelwert | [Fzdm, Mbm, Tm, Fqm] | -1802.7 | 0.0 | 350.5 | 0.0
Ausschlag (Amplitude) | [Fzda, Mba, Ta, Fqa] | 178.3 | 388.1 | 34.7 | 4801.0
Maximalwert | [Fzdmax, Mbmax, Tmax, Fqmax] | -1981.0 | 388.1 | 385.1 | 4801.0
Querschnitt, Widerstandsmomente: (mm²) (mm3)
[A, Wb, Wt, A] | 1134.1 | 5387.0 | 10774.1 | 1134.1

Spannungen: (N/mm²)
[σzdm, σbm, τm, τqm] (N/mm²) | -1.590 | 0.000 | 32.528 | 0.000
[σzda, σba, τa, τqa] (N/mm²) | 0.157 | 72.049 | 3.217 | 5.644
[σzdmax,σbmax,τmax,τqmax] (N/mm²) | -1.747 | 72.049 | 35.745 | 5.644
Technologischer Grösseneinfluss | [K1(σB)] | 0.826
| [K1(σS)] | 0.772
| | Zug/Druck | Biegung | Torsion
Kerbwirkungszahl | [ß(dB)] | 2.603 | 2.603 | 1.602
[dB] (mm) = | 40.0
Geometrischer Grösseneinfluss | [K3(d)] | 0.955 | 0.955 | 0.978
Geometrischer Grösseneinfluss | [K3(dB)] | 0.954 | 0.954 | 0.977
Kerbwirkungszahl | [ß] | 2.600 | 2.600 | 1.601

Geometrischer Grösseneinfluss | [K2(d)] | 1.000 | 0.892 | 0.892
Einflussfaktor Oberflächenrauheit | [KF] | 1.000 | 1.000 | 1.000
Rauheitsfaktor ist gemäss Norm in der Kerbwirkungszahl inbegriffen
Oberflächenverfestigungfaktor | [KV] | 1.000 | 1.000 | 1.000
Gesamteinflussfaktor | [K] | 2.600 | 2.915 | 1.795

Vorhandene Sicherheitszahl für den Dauerfestigkeitsnachweis:
Vergleichsmittelspannung (N/mm²) | [σmV] | | | 56.318
Vergleichsmittelspannung (N/mm²) | [τmV] | | | 32.515
Bauteilwechselfestigkeit (N/mm²) | [σWK] | 107.975 | 120.348 | 114.978
Einflussfaktor Mittelspannungsempf. | [ψσK] | 0.083 | 0.094 | 0.089
Ertragbare Amplitude (N/mm²) | [σADK] | 1.246 | 112.127 | 27.925
Sicherheit gegen Ermüdung | [S] | | | 1.287
Sollsicherheit gegen Ermüdung | [Smin] | | | 1.200
Resultat (%) | [S/Smin] | | | 107.2

Vorhandene Sicherheitszahl
für den Nachweis gegen Überschreiten der Fliessgrenze:
Statische Stützziffer | [K2F] | 1.000 | 1.200 | 1.200
Erhöhungsfaktor | [γF] | 1.000 | 1.000 | 1.000
Bauteilfliessgrenze (N/mm²) | [σFK] | 447.690 | 537.228 | 310.169
Sicherheit Fliessgrenze | [S] | | | 5.751
Sollsicherheit | [Smin] | | | 1.200
Resultat (%) | [S/Smin] | | | 479.2
Querschnitt 'C-C' | Wellenabsatz mit Freistich
Kommentar | Y= 108.00mm
Position (Y-Koordinate) (mm) | [y] | 108.000
Aussendurchmesser (mm) | [da] | 38.000
Innendurchmesser (mm) | [di] | 0.000
Kerbwirkung | Wellenabsatz mit Freistich
[D, d, D1, r, t1] (mm) | 56.000 | 37.400 | 38.000 | 0.800 | 0.300
Form B
Mittlere Rauheit (µm) | [Rz] | 32.000
Zug/Druck | Biegung | Torsion | Scherung
Belastung: (N) (Nm)
Mittelwert | [Fzdm, Mbm, Tm, Fqm] | -2070.4 | 0.0 | 402.5 | 0.0
Ausschlag (Amplitude) | [Fzda, Mba, Ta, Fqa] | 204.8 | 358.4 | 39.8 | 6571.4

Maximalwert | [Fzdmax, Mbmax, Tmax, Fqmax] | -2275.1 | 358.4 | 442.3 | 6571.4
Querschnitt, Widerstandsmomente: (mm²) (mm3)
[A, Wb, Wt, A] | | 1098.6 | 5135.9 | 10271.8 | 1098.6

Spannungen: (N/mm²)
[σzdm, σbm, τm, τqm] (N/mm²) | -1.885 | 0.000 | 39.183 | 0.000
[σzda, σba, τa, τqa] (N/mm²) | 0.186 | 69.785 | 3.875 | 7.976
[σzdmax,σbmax,τmax,τqmax] (N/mm²) | -2.071 | 69.785 | 43.058 | 7.976
Technologischer Grösseneinfluss | [K1(σB)] | 0.826
| [K1(σS)] | 0.772
| | Zug/Druck | Biegung | Torsion
Formzahl | [α] | 3.151 | 2.759 | 1.920
Bezogenes Spannungsgefälle | [G'] | 3.059 | 3.059 | 1.437
Stützziffer | [n] | 1.192 | 1.192 | 1.132
Kerbwirkungszahl | [ß] | 2.643 | 2.314 | 1.696
Geometrischer Grösseneinfluss | [K2(d)] | 1.000 | 0.892 | 0.892
Einflussfaktor Oberflächenrauheit | [KF] | 0.819 | 0.819 | 0.896
Oberflächenverfestigungfaktor | [KV] | 1.000 | 1.000 | 1.000
Gesamteinflussfaktor | [K] | 2.863 | 2.815 | 2.018

Vorhandene Sicherheitszahl für den Dauerfestigkeitsnachweis:
Vergleichsmittelspannung (N/mm²) | [σmV] | | | 67.841
Vergleichsmittelspannung (N/mm²) | [τmV] | | | 39.168
Bauteilwechselfestigkeit (N/mm²) | [σWK] | 98.041 | 124.625 | 102.256
Einflussfaktor Mittelspannungsempf. | [ψσK] | 0.075 | 0.097 | 0.079
Ertragbare Amplitude (N/mm²) | [σADK] | 1.411 | 113.840 | 27.925
Sicherheit gegen Ermüdung | [S] | | | 1.319
Sollsicherheit gegen Ermüdung | [Smin] | | | 1.200
Resultat (%) | [S/Smin] | | | 109.9

Vorhandene Sicherheitszahl
für den Nachweis gegen Überschreiten der Fliessgrenze:
Statische Stützziffer | [K2F] | 1.000 | 1.200 | 1.200
Erhöhungsfaktor | [γF] | 1.150 | 1.100 | 1.000
Bauteilfliessgrenze (N/mm²) | [σFK] | 514.844 | 590.951 | 310.169
Sicherheit Fliessgrenze | [S] | | | 5.566
Sollsicherheit | [Smin] | | | 1.200

Resultat (%) | [S/Smin] | 463.8
Querschnitt 'D-D' | Rechtecknut
Kommentar | Y= 59.75... 61.60mm
Position (Y-Koordinate) (mm) | [y] | 61.500
Aussendurchmesser (mm) | [da] | 38.000
Innendurchmesser (mm) | [di] | 0.000
Kerbwirkung | Rechtecknut
[d, r, t, m] (mm) | 36.00 | 0.17 | 1.00 | 1.85
Mittlere Rauheit (µm) | [Rz] | 8.000
Zug/Druck | Biegung | Torsion | Scherung
Belastung: (N) (Nm)
Mittelwert | [Fzdm, Mbm, Tm, Fqm] | 0.4 | 0.0 | 0.0 | 0.0
Ausschlag (Amplitude) | [Fzda, Mba, Ta, Fqa] | 0.0 | 313.6 | 0.0 | 7211.1
Maximalwert | [Fzdmax, Mbmax, Tmax, Fqmax] | 0.5 | 313.6 | 0.0 | 7211.1
Querschnitt, Widerstandsmomente: (mm²) (mm3)
[A, Wb, Wt, A] | 1017.9 | 4580.4 | 9160.9 | 1017.9

Spannungen: (N/mm²)
[σzdm, σbm, τm, τqm] (N/mm²) | 0.000 | 0.000 | 0.000 | 0.000
[σzda, σba, τa, τqa] (N/mm²) | 0.000 | 68.459 | 0.000 | 9.446
[σzdmax,σbmax,τmax,τqmax] (N/mm²) | 0.000 | 68.459 | 0.000 | 9.446
Technologischer Grösseneinfluss | [K1(σB)] | 0.826
| [K1(σS)] | 0.772
| | Zug/Druck | Biegung | Torsion
Kerbwirkungszahl | [ß(dB)] | 2.897 | 2.645 | 2.401
[dB] (mm) = | 30.0
Geometrischer Grösseneinfluss | [K3(d)] | 0.952 | 0.956 | 0.960
Geometrischer Grösseneinfluss | [K3(dB)] | 0.957 | 0.961 | 0.965
Kerbwirkungszahl | [ß] | 2.914 | 2.660 | 2.412
Geometrischer Grösseneinfluss | [K2(d)] | 1.000 | 0.895 | 0.895
Einflussfaktor Oberflächenrauheit | [KF] | 1.057 | 1.057 | 1.030
Oberflächenverfestigungfaktor | [KV] | 1.000 | 1.000 | 1.000

Gesamteinflussfaktor | [K] | 2.861 | 2.917 | 2.665

Vorhandene Sicherheitszahl für den Dauerfestigkeitsnachweis:
Vergleichsmittelspannung (N/mm²) | [σmV] | | | 0.000
Vergleichsmittelspannung (N/mm²) | [τmV] | | | 0.000
Bauteilwechselfestigkeit (N/mm²) | [σWK] | 98.114 | 120.277 | 77.440
Einflussfaktor Mittelspannungsempf. | [ψσK] | 0.075 | 0.094 | 0.058
Ertragbare Amplitude (N/mm²) | [σADK] | 95.040 | 120.277 | 76.332
Sicherheit gegen Ermüdung | [S] | | | 1.757
Sollsicherheit gegen Ermüdung | [Smin] | | | 1.200
Resultat (%) | [S/Smin] | | | 146.4

Vorhandene Sicherheitszahl
für den Nachweis gegen Überschreiten der Fliessgrenze:
Statische Stützziffer | [K2F] | 1.000 | 1.200 | 1.200
Erhöhungsfaktor | [γF] | 1.100 | 1.100 | 1.000
Bauteilfliessgrenze (N/mm²) | [σFK] | 492.459 | 590.951 | 310.169
Sicherheit Fliessgrenze | [S] | | | 8.632
Sollsicherheit | [Smin] | | | 1.200
Resultat (%) | [S/Smin] | | | 719.3
Querschnitt 'E-E' | Rechtecknut
Kommentar | Y= 59.75... 61.60mm
Position (Y-Koordinate) (mm) | [y] | 60.675
Aussendurchmesser (mm) | [da] | 38.000
Innendurchmesser (mm) | [di] | 0.000
Kerbwirkung | Rechtecknut
[d, r, t, m] (mm) | 36.00 | 0.17 | 1.00 | 1.85
Mittlere Rauheit (µm) | [Rz] | 8.000
Zug/Druck | Biegung | Torsion | Scherung
Belastung: (N) (Nm)
Mittelwert | [Fzdm, Mbm, Tm, Fqm] | 0.4 | 0.0 | 0.0 | 0.0
Ausschlag (Amplitude) | [Fzda, Mba, Ta, Fqa] | 0.0 | 307.6 | 0.0 | 7211.0
Maximalwert | [Fzdmax, Mbmax, Tmax, Fqmax] | 0.5 | 307.6 | 0.0 | 7211.0
Querschnitt, Widerstandsmomente: (mm²) (mm3)
[A, Wb, Wt, A] | 1017.9 | 4580.4 | 9160.9 | 1017.9

Spannungen: (N/mm²)
[σzdm, σbm, τm, τqm] (N/mm²) | 0.000 | 0.000 | 0.000 | 0.000
[σzda, σba, τa, τqa] (N/mm²) | 0.000 | 67.160 | 0.000 | 9.446
[σzdmax,σbmax,τmax,τqmax] (N/mm²) | 0.000 | 67.160 | 0.000 | 9.446
Technologischer Grösseneinfluss | [K1(σB)] | 0.826
| [K1(σS)] | 0.772
| | Zug/Druck | Biegung | Torsion
Kerbwirkungszahl | [ß(dB)] | 2.897 | 2.645 | 2.401
[dB] (mm) = | 30.0
Geometrischer Grösseneinfluss | [K3(d)] | 0.952 | 0.956 | 0.960
Geometrischer Grösseneinfluss | [K3(dB)] | 0.957 | 0.961 | 0.965
Kerbwirkungszahl | [ß] | 2.914 | 2.660 | 2.412
Geometrischer Grösseneinfluss | [K2(d)] | 1.000 | 0.895 | 0.895
Einflussfaktor Oberflächenrauheit | [KF] | 1.057 | 1.057 | 1.030
Oberflächenverfestigungfaktor | [KV] | 1.000 | 1.000 | 1.000
Gesamteinflussfaktor | [K] | 2.861 | 2.917 | 2.665

Vorhandene Sicherheitszahl für den Dauerfestigkeitsnachweis:
Vergleichsmittelspannung (N/mm²) | [σmV] | | | 0.000
Vergleichsmittelspannung (N/mm²) | [τmV] | | | 0.000
Bauteilwechselfestigkeit (N/mm²) | [σWK] | 98.114 | 120.277 | 77.440
Einflussfaktor Mittelspannungsempf. | [ψσK] | 0.075 | 0.094 | 0.058
Ertragbare Amplitude (N/mm²) | [σADK] | 95.040 | 120.277 | 76.332
Sicherheit gegen Ermüdung | [S] | | | 1.791
Sollsicherheit gegen Ermüdung | [Smin] | | | 1.200
Resultat (%) | [S/Smin] | | | 149.2

Vorhandene Sicherheitszahl
für den Nachweis gegen Überschreiten der Fliessgrenze:
Statische Stützziffer | [K2F] | 1.000 | 1.200 | 1.200
Erhöhungsfaktor | [γF] | 1.100 | 1.100 | 1.000
Bauteilfliessgrenze (N/mm²) | [σFK] | 492.459 | 590.951 | 310.169
Sicherheit Fliessgrenze | [S] | | | 8.799
Sollsicherheit | [Smin] | | | 1.200
Resultat (%) | [S/Smin] | | | 733.3

Querschnitt 'F-F' | Passfeder
Kommentar | Y= 66.00...102.00mm
Position (Y-Koordinate) (mm) | [y] | 66.010
Aussendurchmesser (mm) | [da] | 38.000
Innendurchmesser (mm) | [di] | 0.000
Kerbwirkung | Passfeder
Anzahl Passfedern | [n] | 1
Nut mit Fingerfräser bearbeitet
Norm: | DIN 6885.1:1968 Standard
[b, t] (mm) | 10.000 5.100
Mittlere Rauheit (µm) | [Rz] | 8.000
Zug/Druck | Biegung | Torsion | Scherung
Belastung: (N) (Nm)
Mittelwert | [Fzdm, Mbm, Tm, Fqm] | -200.4 | 0.0 | 39.0 | 0.0
Ausschlag (Amplitude) | [Fzda, Mba, Ta, Fqa] | 19.8 | 345.5 | 3.9 | 5881.1
Maximalwert | [Fzdmax, Mbmax, Tmax, Fqmax] | -220.2 | 345.5 | 42.9 | 5881.1
Querschnitt, Widerstandsmomente: (mm²) (mm3)
[A, Wb, Wt, A] | 1134.1 | 5387.0 | 10774.1 | 1134.1

Spannungen: (N/mm²)
[σzdm, σbm, τm, τqm] (N/mm²) | -0.177 | 0.000 | 3.623 | 0.000
[σzda, σba, τa, τqa] (N/mm²) | 0.017 | 64.142 | 0.358 | 6.914
[σzdmax,σbmax,τmax,τqmax] (N/mm²) | -0.194 | 64.142 | 3.981 | 6.914
Technologischer Grösseneinfluss | [K1(σB)] | 0.826
| [K1(σS)] | 0.772
| | Zug/Druck | Biegung | Torsion
Kerbwirkungszahl | [ß(dB)] | 2.603 | 2.603 | 1.602
[dB] (mm) = | 40.0
Geometrischer Grösseneinfluss | [K3(d)] | 0.955 | 0.955 | 0.978
Geometrischer Grösseneinfluss | [K3(dB)] | 0.954 | 0.954 | 0.977
Kerbwirkungszahl | [ß] | 2.600 | 2.600 | 1.601
Geometrischer Grösseneinfluss | [K2(d)] | 1.000 | 0.892 | 0.892
Einflussfaktor Oberflächenrauheit | [KF] | 1.000 | 1.000 | 1.000
Rauheitsfaktor ist gemäss Norm in der Kerbwirkungszahl inbegriffen
Oberflächenverfestigungfaktor | [KV] | 1.000 | 1.000 | 1.000

Gesamteinflussfaktor | [K] | 2.600 | 2.915 | 1.795

Vorhandene Sicherheitszahl für den Dauerfestigkeitsnachweis:
Vergleichsmittelspannung (N/mm²) | [σmV] | | | 6.273
Vergleichsmittelspannung (N/mm²) | [τmV] | | | 3.622
Bauteilwechselfestigkeit (N/mm²) | [σWK] | 107.975 | 120.348 | 114.978
Einflussfaktor Mittelspannungsempf. | [ψσK] | 0.083 | 0.094 | 0.089
Ertragbare Amplitude (N/mm²) | [σADK] | 1.244 | 119.254 | 27.925
Sicherheit gegen Ermüdung | [S] | | | 1.811
Sollsicherheit gegen Ermüdung | [Smin] | | | 1.200
Resultat (%) | [S/Smin] | | | 150.9

Vorhandene Sicherheitszahl
für den Nachweis gegen Überschreiten der Fliessgrenze:
Statische Stützziffer | [K2F] | 1.000 | 1.200 | 1.200
Erhöhungsfaktor | [γF] | 1.000 | 1.000 | 1.000
Bauteilfliessgrenze (N/mm²) | [σFK] | 447.690 | 537.228 | 310.169
Sicherheit Fliessgrenze | [S] | | | 8.358
Sollsicherheit | [Smin] | | | 1.200
Resultat (%) | [S/Smin] | | | 696.5
Hinweise: - | Die Querkraft wird bei der Berechnung nach DIN 743 nicht berücksichtigt. - | Querschnitt mit Presssitz: Die Kerbfaktoren für den Fall 'Leichter Presssitz' sind nicht mehr definiert in DIN743. Die Faktoren werden aus der FKM-Richtlinine übernommen, ausser die Faktoren für den 'festen Pressitz' nach DIN sind kleiner, dann werden diese verwendet. Ende Protokoll

Zeilen: 898
