Mofiche/Getriebebeleg/Dokumentation/KissSoft/Getriebebeleg - Zwischenwelle.pdf

KISSsoft Release 2020 B
KISSsoft – student license (not for commercial use) Projekt
Name | : | Getriebebeleg
Beschreibung: | MEIII Beleg
Kunde | : | Prof. Fischer
| | | Datei
Name | : | Zwischenwelle
Geändert von: | Moritz | am: 18.06.2021 | um: 09:48:33

Wichtiger Hinweis: Bei der Berechnung sind Warnungen aufgetreten:

1-> Berechnung Kerbfaktor für Rechtecknut:
Als Bezugsdurchmesser wird dB = 30.00 mm verwendet, der Strukturradius ro* wird nach der Formel für Stahl berechnet. 2-> Berechnung Kerbfaktor für Rechtecknut:

Als Bezugsdurchmesser wird dB = 30.00 mm verwendet, der Strukturradius ro* wird nach der Formel für Stahl berechnet. Berechnung von Wellen, Achsen und Trägern

Eingabedaten

Koordinatensystem Welle: | siehe Bild W-002
Bezeichnung | Welle 1
Zeichnung
Startposition (mm) | | 0.000
Länge (mm) | | 318.750
Drehzahl (1/min) | | 312.80
Drehrichtung: | im Uhrzeigersinn
Werkstoff | E360 (St70.2)
Elastizitätsmodul (N/mm²) | | 206000.000
Poissonzahl nu | | 0.300
Dichte (kg/m³) | | 7830.000
Wärmeausdehnungskoeffizient | (10^-6/K) | 11.500

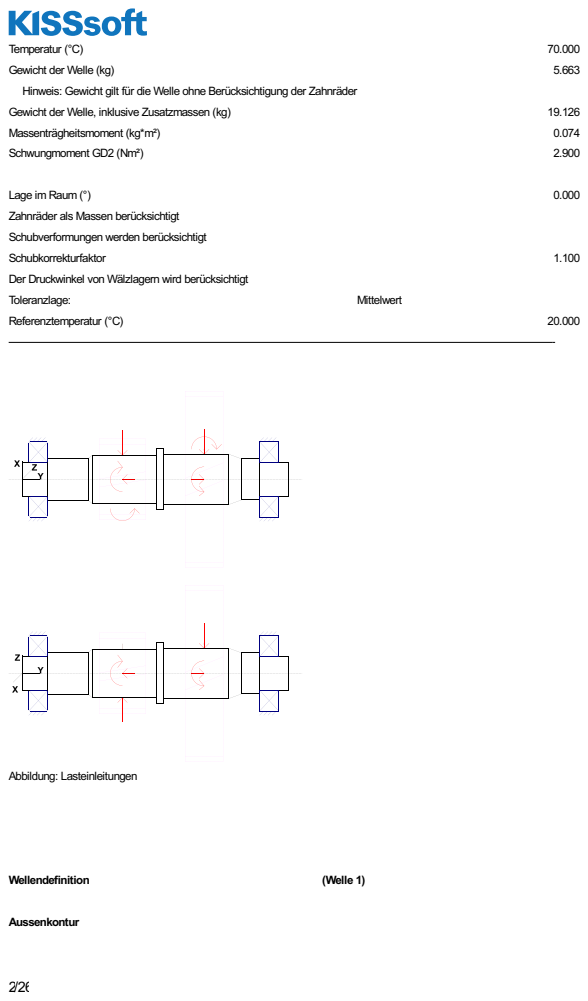
[picture p15: page 2]
Temperatur (°C); Gewicht der Welle (kg); Gewicht der Welle, inklusive Zusatzmassen (kg); Massenträgheitsmoment (kg*m²); Schwungmoment GD2 (Nm²); Lage im Raum (°); Schubkorrekturfaktor; Toleranzlage:; Mittelwert; Referenztemperatur (°C); Abbildung: Lasteinleitungen; Wellendefinition; (Welle 1); Aussenkontur

Hinweis: Gewicht gilt für die Welle ohne Berücksichtigung der Zahnräder

Zahnräder als Massen berücksichtigt
Schubverformungen werden berücksichtigt
Der Druckwinkel von Wälzlagern wird berücksichtigt

Zylinder (Zylinder) | 0.000 mm ... | 31.000 mm
Durchmesser (mm) | [d] | 40.0000
Länge (mm) | [l] | 31.0000
Rauhigkeit (µm) | [Rz] | 8.0000

Fase links (Fase links)
l=2.00 (mm), alpha=45.00 (°)

Radius rechts (Radius rechts)
r=1.00 (mm), Rz=32.0, Gedreht (Ra=3.2μm/125μin)

Rechtecknut (Rechtecknut)
b=1.60 (mm), t=0.70 (mm), r=0.15 (mm), Rz=8.0, Gedreht (Ra=3.2μm/125μin)
Zylinder (Zylinder) | 31.000 mm ... | 79.000 mm
Durchmesser (mm) | [d] | 50.0000
Länge (mm) | [l] | 48.0000
Rauhigkeit (µm) | [Rz] | 8.0000
Konus (Konus) | 79.000 mm ... | 84.000 mm
Durchmesser links (mm) | [dl] | 50.0000
Durchmesser rechts (mm) | [dr] | 58.0000
Länge (mm) | [l] | 5.0000
Rauhigkeit (µm) | [Rz] | 8.0000
Zylinder (Zylinder) | 84.000 mm ... | 160.750 mm
Durchmesser (mm) | [d] | 58.0000
Länge (mm) | [l] | 76.7500
Rauhigkeit (µm) | [Rz] | 8.0000

Rechtecknut (Rechtecknut)
b=2.15 (mm), t=1.50 (mm), r=0.20 (mm), Rz=8.0, Gedreht (Ra=3.2μm/125μin)

Freistich rechts (Freistich rechts)
r=0.80 (mm), t=0.30 (mm), l=2.50 (mm), Rz=32.0, Gedreht (Ra=3.2μm/125μin)
Form E (DIN 509), Reihe 1, mit üblicher Beanspruchung
Passfedernut (Passfedernut) | 94.250 mm ... | 157.250 mm
l=63.00 (mm), i=1, Rz=8.0, Gedreht (Ra=3.2μm/125μin)

Zylinder (Zylinder) | 160.750 mm ... | 169.250 mm
Durchmesser (mm) | [d] | 73.0000
Länge (mm) | [l] | 8.5000
Rauhigkeit (µm) | [Rz] | 8.0000
Zylinder (Zylinder) | 169.250 mm ... | 247.250 mm
Durchmesser (mm) | [d] | 60.0000
Länge (mm) | [l] | 78.0000
Rauhigkeit (µm) | [Rz] | 8.0000

Rechtecknut (Rechtecknut)
b=2.15 (mm), t=1.50 (mm), r=0.20 (mm), Rz=8.0, Gedreht (Ra=3.2μm/125μin)
Passfedernut (Passfedernut) | 174.750 mm ... | 237.750 mm
l=63.00 (mm), i=1, Rz=8.0, Gedreht (Ra=3.2μm/125μin)

Freistich links (Freistich links)
r=0.80 (mm), t=0.30 (mm), l=2.50 (mm), Rz=32.0, Gedreht (Ra=3.2μm/125μin) Form E (DIN 509), Reihe 1, mit üblicher Beanspruchung
Konus (Konus) | 247.250 mm ... | 262.250 mm
Durchmesser links (mm) | [dl] | 60.0000
Durchmesser rechts (mm) | [dr] | 49.0000
Länge (mm) | [l] | 15.0000
Rauhigkeit (µm) | [Rz] | 8.0000
Zylinder (Zylinder) | 262.250 mm ... | 283.750 mm
Durchmesser (mm) | [d] | 49.0000
Länge (mm) | [l] | 21.5000
Rauhigkeit (µm) | [Rz] | 8.0000
Zylinder (Zylinder) | 283.750 mm ... | 318.750 mm
Durchmesser (mm) | [d] | 40.0000
Länge (mm) | [l] | 35.0000
Rauhigkeit (µm) | [Rz] | 8.0000

Fase rechts (Fase rechts)
l=2.00 (mm), alpha=45.00 (°)

Rechtecknut (Rechtecknut)

b=1.85 (mm), t=1.25 (mm), r=0.17 (mm), Rz=32.0, Gedreht (Ra=3.2μm/125μin)

Radius links (Radius links)
r=1.00 (mm), Rz=32.0, Gedreht (Ra=3.2μm/125μin)

Kräfte

Art des Kraftelements | Stirnrad
Bezeichnung im Modell | Stirnrad
Position auf Welle (mm) | [ylocal] | 120.0000
Position im globalen System (mm) | [yglobal] | 120.0000
Wälzkreisdurchmesser (mm) | 96.8750
Schrägungswinkel (°) | 10.2530 | links
Betriebseingriffswinkel im Normalschnitt (°) | 23.5454
Position des Eingriffs (°) | 0.0000
Länge der Krafteinleitung (mm) | 55.5000
Leistung (kW) | 40.0000 | treibend
(Abtrieb)
Drehmoment (Nm) | -1221.1189
Axialkraft (N) | -4560.1092
Querkraft X (N) | -11163.7189
Querkraft Z (N) | 25210.1973
Biegemoment X (Nm) | 0.0000
Biegemoment Z (Nm) | -220.8803
Art des Kraftelements | Stirnrad
Bezeichnung im Modell | Stirnrad
Position auf Welle (mm) | [ylocal] | 217.5000
Position im globalen System (mm) | [yglobal] | 217.5000
Wälzkreisdurchmesser (mm) | 210.6422
Schrägungswinkel (°) | 10.1167 | links
Betriebseingriffswinkel im Normalschnitt (°) | 21.7258
Position des Eingriffs (°) | 0.0000
Länge der Krafteinleitung (mm) | 45.5000
Leistung (kW) | 40.0000 | getrieben
(Antrieb)
Drehmoment (Nm) | 1221.1189
Axialkraft (N) | 2068.7325
Querkraft X (N) | -4692.9336
Querkraft Z (N) | -11594.2477
Biegemoment X (Nm) | -0.0000
Biegemoment Z (Nm) | 217.8812

Lager

---------------------------------------------------------------------------------------------------------------------------- Bezeichnung im Modell | Loslager
Lager Typ | Koyo N308
Lager Bauform | Zylinderrollenlager (einreihig)
Lager Position (mm) | [ylokal] | 19.500
Lager Position (mm) | [yglobal] | 19.500
Befestigung Aussenring | Loslager
Innendurchmesser (mm) | [d] | 40.000
Aussendurchmesser (mm) | [D] | 90.000
Breite (mm) | [b] | 23.000
Eckradius (mm) | [r] | 1.500
Statische Tragzahl (kN) | [C0] | 56.900
Dynamische Tragzahl (kN) | [C] | 73.400
Tragzahl Ermüdung (kN) | [Cu] | 7.850
Werte für die approximierte Geometrie:
Dynamische Tragzahl (kN) | [Ctheo] | 0.000
Statische Tragzahl (kN) | [C0theo] | 0.000
Korrekturfaktor Dynamische Tragzahl | [fC] | 1.000
Korrekturfaktor Statische Tragzahl | [fC0] | 1.000
---------------------------------------------------------------------------------------------------------------------------- Bezeichnung im Modell | Festlager
Lager Typ | FAG 6308
Lager Bauform | Rillenkugellager (einreihig)
Lager Position (mm) | [ylokal] | 295.250
Lager Position (mm) | [yglobal] | 295.250
Befestigung Aussenring | Festlager
Innendurchmesser (mm) | [d] | 40.000
Aussendurchmesser (mm) | [D] | 90.000
Breite (mm) | [b] | 23.000
Eckradius (mm) | [r] | 0.000
Statische Tragzahl (kN) | [C0] | 25.000
Dynamische Tragzahl (kN) | [C] | 45.500
Tragzahl Ermüdung (kN) | [Cu] | 1.690
Werte für die approximierte Geometrie:
Dynamische Tragzahl (kN) | [Ctheo] | 0.000
Statische Tragzahl (kN) | [C0theo] | 0.000
Korrekturfaktor Dynamische Tragzahl | [fC] | 1.000

Korrekturfaktor Statische Tragzahl | [fC0] | 1.000
---------------------------------------- Welle 'Welle 1': Die Masse von folgendem Element wird berücksichtigt (y= | 120.0000 (mm)): Stirnrad
'Stirnrad' m (yS= | 120.0000 (mm)): | 2.0549 (kg)
Jp: | 0.0033 (kg*m²), Jxx: | 0.0022 (kg*m²), Jzz: | 0.0022 (kg*m²)
----------------------------------------- Welle 'Welle 1': Die Masse von folgendem Element wird berücksichtigt (y= | 217.5000 (mm)): Stirnrad
'Stirnrad' m (yS= | 217.5000 (mm)): | 11.4079 (kg)
Jp: | 0.0684 (kg*m²), Jxx: | 0.0362 (kg*m²), Jzz: | 0.0362 (kg*m²)

Resultate

Welle

Maximale Durchbiegung (μm) | 89.821
Position des Maximums (mm) | 129.652
Massenschwerpunkt (mm) | 161.200
Summe der axialen Belastung (N) | -2491.377
Verdrehung unter Drehmoment (°) | 0.069

Lager

Ausfallwahrscheinlichkeit | [n] | 10.00 | %
Axialspiel (ISO 281) | [uA] | 10.00
µm
Schmierstoff | ISO-VG 220
Schmierstoff - Betriebstemperatur | [TB] | 70.00 | °C
Wälzlager klassisch (Druckwinkel berücksichtigen)

Welle 'Welle 1' Wälzlager 'Loslager' 7/26

Position (Y-Koordinate) | [y] | 19.50 | mm
Dynamisch äquivalente Belastung | [P] | 15.23 | kN
Statisch äquivalente Belastung | [P0] | 15.23 | kN
Faktor für Ausfallwahrscheinlichkeit | [a1] | 1.000

Ergebnisse nach ISO 281:
Schmierstoff | ISO-VG 220
Lastverhältnis | [C/P] | 4.820
Betriebsviskosität | [ν] | 48.884
mm²/s
Bezugsviskosität | [ν1] | 0.000
mm²/s
Viskositätsverhältnis | [κ] | 0.000
Nominelle Lagerlebensdauer | [Lnh] | 10080.69 | h
Statischer Sicherheitsfaktor | [S0] | 3.74
Lagerreaktionskraft | [Fx] | 8.429 | kN
Lagerreaktionskraft | [Fy] | 0.000 | kN
Lagerreaktionskraft | [Fz] | -12.682 | kN
Lagerreaktionskraft | [Fr] | 15.227 | kN (-56.39°)
Ölstand | [H] | 0.000 | mm
Rollreibungsmoment | [Mrr] | 0.160
Nm
Gleitreibungsmoment | [Msl] | 0.074
Nm
Reibungsmoment Dichtungen | [Mseal] | 0.000
Nm
Reibungsmoment Dichtungen nach SKF-Hauptkatalog 17000/1 EN:2018 bestimmt
Reibungsmoment Strömungsverluste | [Mdrag] | 0.000
Nm
Reibungsmoment | [Mloss] | 0.234
Nm
Verlustleistung | [Ploss] | 7.659 | W
Das Reibungsmoment wird nach Angaben aus dem SKF-Katalog 2018 berechnet. Es wird immer mit einem Beiwert für Zusätze im Schmierstoff μbl=0.15 gerechnet. Lagerverschiebung | [ux] | -10.285

µm
Lagerverschiebung | [uy] | -169.774
µm
Lagerverschiebung | [uz] | 15.678
µm
Lagerverschiebung | [ur] | 18.750
µm | (123.26°)
Lagerneigung | [rx] | 0.779
mrad | (2.68')

Lagerneigung | [ry] | -0.000
mrad | (0')
Lagerneigung | [rz] | 0.582
mrad | (2')
Lagerneigung | [rr] | 0.972
mrad | (3.34')
Welle 'Welle 1' Wälzlager 'Festlager' Position (Y-Koordinate) | [y] | 295.25 | mm
Dynamisch äquivalente Belastung | [P] | 7.46 | kN
Statisch äquivalente Belastung | [P0] | 7.46 | kN
Faktor für Ausfallwahrscheinlichkeit | [a1] | 1.000

Ergebnisse nach ISO 281:
Schmierstoff | ISO-VG 220
Lastverhältnis | [C/P] | 6.095
Betriebsviskosität | [ν] | 48.884
mm²/s
Bezugsviskosität | [ν1] | 0.000
mm²/s
Viskositätsverhältnis | [κ] | 0.000
Nominelle Lagerlebensdauer | [Lnh] | 12065.02 | h
Statischer Sicherheitsfaktor | [S0] | 3.35
Lagerreaktionskraft | [Fx] | 7.428 | kN
Lagerreaktionskraft | [Fy] | 2.491 | kN
Lagerreaktionskraft | [Fz] | -0.747 | kN
Lagerreaktionskraft | [Fr] | 7.465 | kN (-5.74°)
Ölstand | [H] | 0.000 | mm
Rollreibungsmoment | [Mrr] | 0.099
Nm
Gleitreibungsmoment | [Msl] | 0.344
Nm
Reibungsmoment Dichtungen | [Mseal] | 0.000
Nm
Reibungsmoment Dichtungen nach SKF-Hauptkatalog 17000/1 EN:2018 bestimmt
Reibungsmoment Strömungsverluste | [Mdrag] | 0.000
Nm
Reibungsmoment | [Mloss] | 0.443
Nm
Verlustleistung | [Ploss] | 14.514 | W
Das Reibungsmoment wird nach Angaben aus dem SKF-Katalog 2018 berechnet. Es wird immer mit einem Beiwert für Zusätze im Schmierstoff μbl=0.15 gerechnet. Lagerverschiebung | [ux] | -6.490

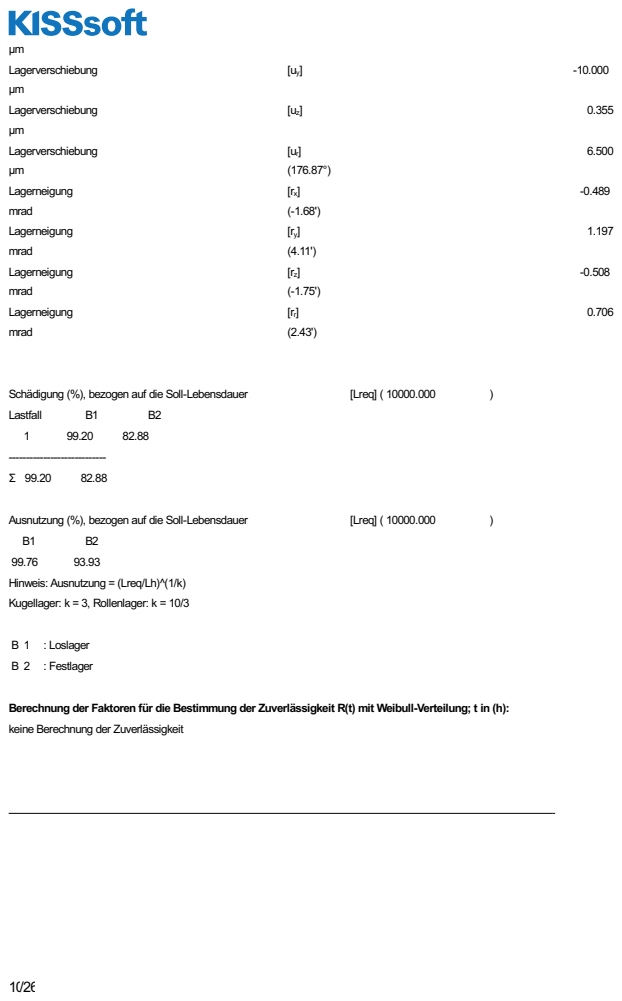
[picture p16: page 10]
Lagerverschiebung; Lagerneigung; mrad; Schädigung (%), bezogen auf die Soll-Lebensdauer; [Lreq] ( 10000.000; Lastfall; Ausnutzung (%), bezogen auf die Soll-Lebensdauer; B 1 : Loslager; B 2 : Festlager

Hinweis: Ausnutzung = (Lreq/Lh)^(1/k)
Kugellager: k = 3, Rollenlager: k = 10/3

Berechnung der Faktoren für die Bestimmung der Zuverlässigkeit R(t) mit Weibull-Verteilung; t in (h):
keine Berechnung der Zuverlässigkeit

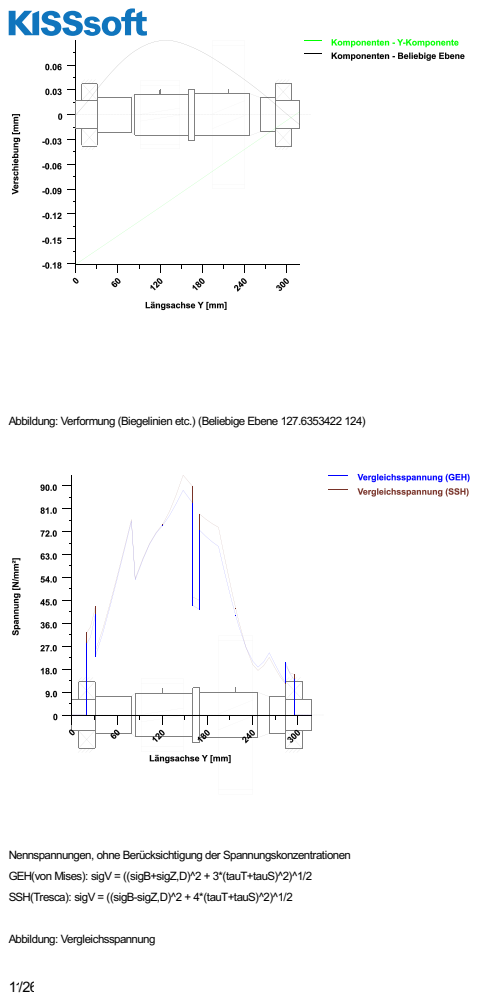
[picture p17: page 11]
Abbildung: Vergleichsspannung

Abbildung: Verformung (Biegelinien etc.) (Beliebige Ebene 127.6353422 124)

Nennspannungen, ohne Berücksichtigung der Spannungskonzentrationen
GEH(von Mises): sigV = ((sigB+sigZ,D)^2 + 3*(tauT+tauS)^2)^1/2
SSH(Tresca): sigV = ((sigB-sigZ,D)^2 + 4*(tauT+tauS)^2)^1/2

### Eigenfrequenzen

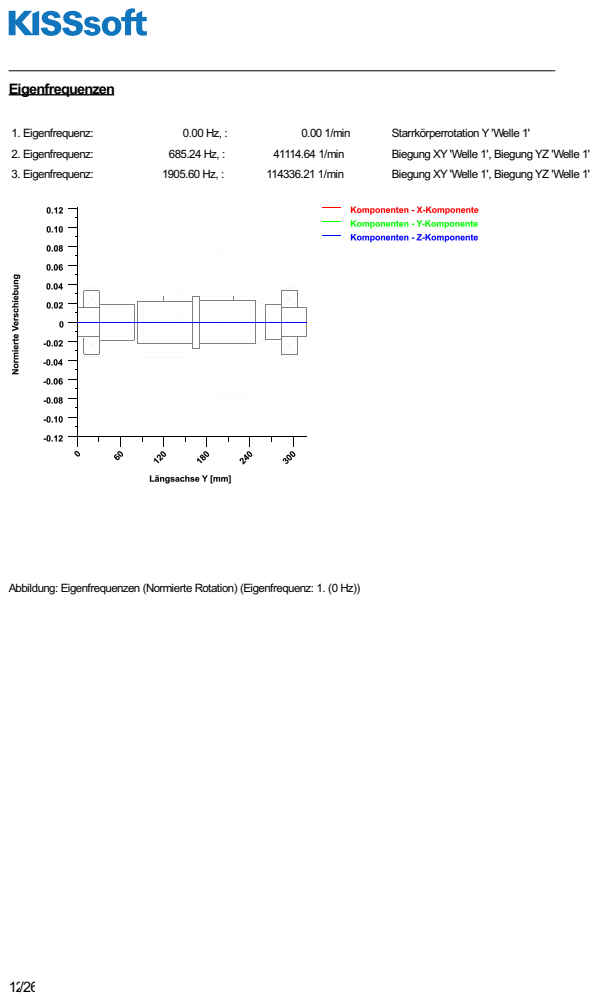
[picture p18: page 12]
1. Eigenfrequenz:; 0.00 1/min; Starrkörperrotation Y 'Welle 1' 2. Eigenfrequenz:; 41114.64 1/min; Biegung XY 'Welle 1', Biegung YZ 'Welle 1' 3. Eigenfrequenz:; 114336.21 1/min; Biegung XY 'Welle 1', Biegung YZ 'Welle 1'

Abbildung: Eigenfrequenzen (Normierte Rotation) (Eigenfrequenz: 1. (0 Hz))

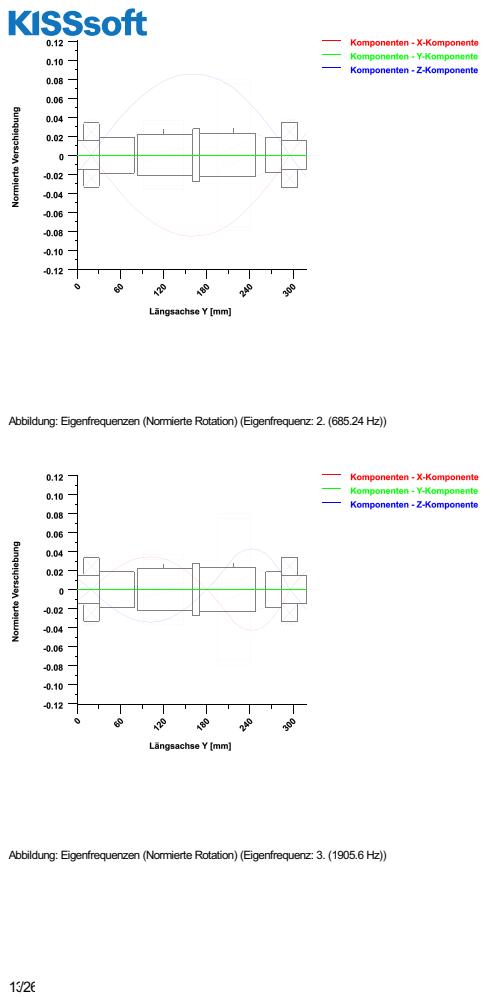
[picture p19: page 13]

Abbildung: Eigenfrequenzen (Normierte Rotation) (Eigenfrequenz: 2. (685.24 Hz))

Abbildung: Eigenfrequenzen (Normierte Rotation) (Eigenfrequenz: 3. (1905.6 Hz))

### Festigkeitsberechnung nach DIN 743:2012

Zusammenfassung

Welle 1

Werkstoff | E360 (St70.2)
Werkstoffart | Baustahl
Werkstoff-Behandlung | unbehandelt
Oberflächen-Behandlung | Keine

Berechnung der Dauerfestigkeit und der statischen Festigkeit

Berechnung für Beanspruchungsfall 2 (σav/σmv = konst)
Querschnitt | Lage (Y-Koor) (mm)
A-A | 138.50 | Passfeder
B-B | 157.24 | Passfeder
C-C | 92.25 | Rechtecknut
D-D | 160.75 | Wellenabsatz mit Freistich
E-E | 91.33 | Rechtecknut
F-F | 94.26 | Passfeder

Resultate:
Querschnitt | βσ | KFσ | K2d | SD | SS
A-A | 2.60 | 1.00 | 0.86 | 1.24 | 4.51
B-B | 2.60 | 1.00 | 0.86 | 1.37 | 4.66
C-C | 2.79 | 1.05 | 0.87 | 1.42 | 5.75
D-D | 2.38 | 0.83 | 0.86 | 1.42 | 4.89
E-E | 2.79 | 1.05 | 0.87 | 1.44 | 5.83
F-F | 2.60 | 1.00 | 0.86 | 1.69 | 5.99
Sollsicherheiten: | | | | 1.20 | 1.20

Abkürzungen:
βσ: Kerbfaktor Biegung
KFσ: Oberflächenfaktor
K2d: Grössenfaktor Biegung SD: Sicherheit Dauerfestigkeit SS: Sicherheit Streckgrenze

Ausnutzung (%) | [Smin/S]
Querschnitt | Statisch | Dauerfest
A-A | 26.600 | 96.432
B-B | 25.748 | 87.608
C-C | 20.852 | 84.596
D-D | 24.559 | 84.359
E-E | 20.587 | 83.520
F-F | 20.041 | 71.085
Maximale Ausnutzung (%) | [A] | 96.432

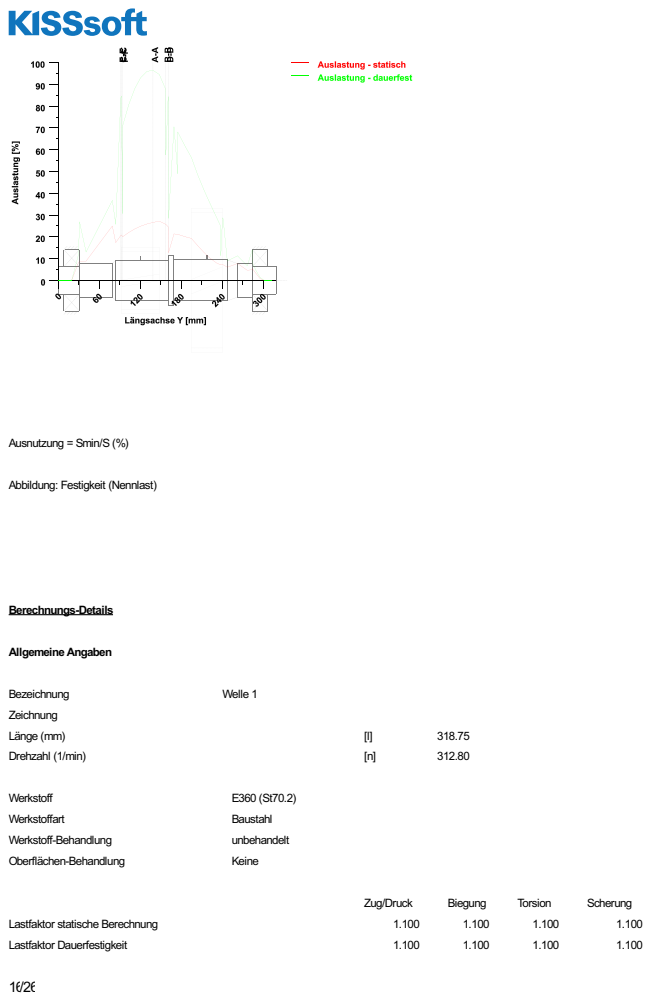
[picture p20: page 16]
Ausnutzung = Smin/S (%); Berechnungs-Details; Allgemeine Angaben; Bezeichnung; Welle 1; Zeichnung; Länge (mm); Drehzahl (1/min); Werkstoff; Werkstoffart; Baustahl; Werkstoff-Behandlung; unbehandelt; Oberflächen-Behandlung; Keine; Zug/Druck; Biegung; Torsion; Scherung; Lastfaktor statische Berechnung; Lastfaktor Dauerfestigkeit

Abbildung: Festigkeit (Nennlast)

Bezugsdurchmesser Werkstoff (mm) | [dB] | 16.00
σB nach DIN 743, bei dB (N/mm²) | [σB] | 670.00
σS nach DIN 743, bei dB (N/mm²) | [σS] | 360.00
[σzdW], bei dB (N/mm²) | 270.00
[σbW], | bei dB (N/mm²) | 335.00
[τtW], | bei dB (N/mm²) | 200.00
Dicke Rohmaterial (mm) | [dWerkst] | 75.00
Werkstoffdaten nach DIN743/3 mit K1(d) berechnet
Werkstoff-Festigkeitswerte aus Dicke Rohmaterial bestimmt
Geometrischer Grössenfaktor K1d mit Rohdurchmesser berechnet
[σBeff] (N/mm²) | 670.00
[σSeff] (N/mm²) | 325.38
[σbFK] (N/mm²) | 390.45
[τtFK] (N/mm²) | 225.43
[σbBRand] (N/mm²) | 678.00
[σzdW] (N/mm²) | 270.00
[σbW] (N/mm²) | 335.00
[τtW] (N/mm²) | 200.00

Dauerfestigkeit für Einstufenbeanspruchung

Berechnung für Beanspruchungsfall 2 (σ.av/σ.mv = konst)

Querschnitt 'A-A' | Passfeder
Kommentar | Y= 94.25...157.25mm
Position (Y-Koordinate) (mm) | [y] | 138.500
Aussendurchmesser (mm) | [da] | 58.000
Innendurchmesser (mm) | [di] | 0.000
Kerbwirkung | Passfeder
Anzahl Passfedern | [n] | 1
Nut mit Fingerfräser bearbeitet
Norm: | DIN 6885.1:1968 Standard
[b, t] (mm) | 16.000 6.100
Mittlere Rauheit (µm) | [Rz] | 8.000
Zug/Druck | Biegung | Torsion | Scherung
Belastung: (N) (Nm)
Mittelwert | [Fzdm, Mbm, Tm, Fqm] | 3803.7 | 0.0 | 1018.6 | 0.0
Ausschlag (Amplitude) | [Fzda, Mba, Ta, Fqa] | 376.2 | 1308.6 | 100.7 | 9163.5
Maximalwert | [Fzdmax, Mbmax, Tmax, Fqmax] | 4179.9 | 1308.6 | 1119.4 | 9163.5
Querschnitt, Widerstandsmomente: (mm²) (mm3)

[A, Wb, Wt, A] | 2642.1 | 19155.1 | 38310.2 | 2642.1

Spannungen: (N/mm²)
[σzdm, σbm, τm, τqm] (N/mm²) | 1.440 | 0.000 | 26.589 | 0.000
[σzda, σba, τa, τqa] (N/mm²) | 0.142 | 68.316 | 2.630 | 4.624
[σzdmax,σbmax,τmax,τqmax] (N/mm²) | 1.582 | 68.316 | 29.218 | 4.624
Technologischer Grösseneinfluss | [K1(σB)] | 1.000
| [K1(σS)] | 0.904
| | Zug/Druck | Biegung | Torsion
Kerbwirkungszahl | [ß(dB)] | 2.570 | 2.570 | 1.570
[dB] (mm) = | 40.0
Geometrischer Grösseneinfluss | [K3(d)] | 0.944 | 0.944 | 0.973
Geometrischer Grösseneinfluss | [K3(dB)] | 0.954 | 0.954 | 0.978
Kerbwirkungszahl | [ß] | 2.598 | 2.598 | 1.578
Geometrischer Grösseneinfluss | [K2(d)] | 1.000 | 0.863 | 0.863
Einflussfaktor Oberflächenrauheit | [KF] | 1.000 | 1.000 | 1.000
Rauheitsfaktor ist gemäss Norm in der Kerbwirkungszahl inbegriffen
Oberflächenverfestigungfaktor | [KV] | 1.000 | 1.000 | 1.000
Gesamteinflussfaktor | [K] | 2.598 | 3.009 | 1.827

Vorhandene Sicherheitszahl für den Dauerfestigkeitsnachweis:
Vergleichsmittelspannung (N/mm²) | [σmV] | | | 46.075
Vergleichsmittelspannung (N/mm²) | [τmV] | | | 26.602
Bauteilwechselfestigkeit (N/mm²) | [σWK] | 103.939 | 111.350 | 109.445
Einflussfaktor Mittelspannungsempf. | [ψσK] | 0.084 | 0.091 | 0.089
Ertragbare Amplitude (N/mm²) | [σADK] | 1.002 | 104.936 | 20.279
Sicherheit gegen Ermüdung | [S] | | | 1.244
Sollsicherheit gegen Ermüdung | [Smin] | | | 1.200
Resultat (%) | [S/Smin] | | | 103.7

Vorhandene Sicherheitszahl
für den Nachweis gegen Überschreiten der Fliessgrenze:
Statische Stützziffer | [K2F] | 1.000 | 1.200 | 1.200
Erhöhungsfaktor | [γF] | 1.000 | 1.000 | 1.000
Bauteilfliessgrenze (N/mm²) | [σFK] | 325.376 | 390.452 | 225.427
Sicherheit Fliessgrenze | [S] | | | 4.511
Sollsicherheit | [Smin] | | | 1.200

Resultat (%) | [S/Smin] | 375.9
Querschnitt 'B-B' | Passfeder
Kommentar | Y= 94.25...157.25mm
Position (Y-Koordinate) (mm) | [y] | 157.240
Aussendurchmesser (mm) | [da] | 58.000
Innendurchmesser (mm) | [di] | 0.000
Kerbwirkung | Passfeder
Anzahl Passfedern | [n] | 1
Nut mit Fingerfräser bearbeitet
Norm: | DIN 6885.1:1968 Standard
[b, t] (mm) | 16.000 6.100
Mittlere Rauheit (µm) | [Rz] | 8.000
Zug/Druck | Biegung | Torsion | Scherung
Belastung: (N) (Nm)
Mittelwert | [Fzdm, Mbm, Tm, Fqm] | 4564.5 | 0.0 | 1222.3 | 0.0
Ausschlag (Amplitude) | [Fzda, Mba, Ta, Fqa] | 451.4 | 1061.8 | 120.9 | 14056.3
Maximalwert | [Fzdmax, Mbmax, Tmax, Fqmax] | 5015.9 | 1061.8 | 1343.2 | 14056.3
Querschnitt, Widerstandsmomente: (mm²) (mm3)
[A, Wb, Wt, A] | 2642.1 | 19155.1 | 38310.2 | 2642.1

Spannungen: (N/mm²)
[σzdm, σbm, τm, τqm] (N/mm²) | 1.728 | 0.000 | 31.906 | 0.000
[σzda, σba, τa, τqa] (N/mm²) | 0.171 | 55.434 | 3.156 | 7.094
[σzdmax,σbmax,τmax,τqmax] (N/mm²) | 1.898 | 55.434 | 35.062 | 7.094
Technologischer Grösseneinfluss | [K1(σB)] | 1.000
| [K1(σS)] | 0.904
| | Zug/Druck | Biegung | Torsion
Kerbwirkungszahl | [ß(dB)] | 2.570 | 2.570 | 1.570
[dB] (mm) = | 40.0
Geometrischer Grösseneinfluss | [K3(d)] | 0.944 | 0.944 | 0.973
Geometrischer Grösseneinfluss | [K3(dB)] | 0.954 | 0.954 | 0.978
Kerbwirkungszahl | [ß] | 2.598 | 2.598 | 1.578

Geometrischer Grösseneinfluss | [K2(d)] | 1.000 | 0.863 | 0.863
Einflussfaktor Oberflächenrauheit | [KF] | 1.000 | 1.000 | 1.000
Rauheitsfaktor ist gemäss Norm in der Kerbwirkungszahl inbegriffen
Oberflächenverfestigungfaktor | [KV] | 1.000 | 1.000 | 1.000
Gesamteinflussfaktor | [K] | 2.598 | 3.009 | 1.827

Vorhandene Sicherheitszahl für den Dauerfestigkeitsnachweis:
Vergleichsmittelspannung (N/mm²) | [σmV] | | | 55.291
Vergleichsmittelspannung (N/mm²) | [τmV] | | | 31.922
Bauteilwechselfestigkeit (N/mm²) | [σWK] | 103.939 | 111.350 | 109.445
Einflussfaktor Mittelspannungsempf. | [ψσK] | 0.084 | 0.091 | 0.089
Ertragbare Amplitude (N/mm²) | [σADK] | 1.002 | 102.119 | 20.279
Sicherheit gegen Ermüdung | [S] | | | 1.370
Sollsicherheit gegen Ermüdung | [Smin] | | | 1.200
Resultat (%) | [S/Smin] | | | 114.1

Vorhandene Sicherheitszahl
für den Nachweis gegen Überschreiten der Fliessgrenze:
Statische Stützziffer | [K2F] | 1.000 | 1.200 | 1.200
Erhöhungsfaktor | [γF] | 1.000 | 1.000 | 1.000
Bauteilfliessgrenze (N/mm²) | [σFK] | 325.376 | 390.452 | 225.427
Sicherheit Fliessgrenze | [S] | | | 4.661
Sollsicherheit | [Smin] | | | 1.200
Resultat (%) | [S/Smin] | | | 388.4
Querschnitt 'C-C' | Rechtecknut
Kommentar | Y= 90.25... 92.40mm
Position (Y-Koordinate) (mm) | [y] | 92.250
Aussendurchmesser (mm) | [da] | 58.000
Innendurchmesser (mm) | [di] | 0.000
Kerbwirkung | Rechtecknut
[d, r, t, m] (mm) | 55.00 | 0.20 | 1.50 | 2.15
Mittlere Rauheit (µm) | [Rz] | 8.000
Zug/Druck | Biegung | Torsion | Scherung
Belastung: (N) (Nm)
Mittelwert | [Fzdm, Mbm, Tm, Fqm] | -0.2 | 0.0 | 0.0 | 0.0
Ausschlag (Amplitude) | [Fzda, Mba, Ta, Fqa] | 0.0 | 1219.0 | 0.0 | 16761.9
Maximalwert | [Fzdmax, Mbmax, Tmax, Fqmax] | -0.2 | 1219.0 | 0.0 | 16761.9

Querschnitt, Widerstandsmomente: (mm²) (mm3)
[A, Wb, Wt, A] | 2375.8 | 16333.8 | 32667.7 | 2375.8

Spannungen: (N/mm²)
[σzdm, σbm, τm, τqm] (N/mm²) | -0.000 | 0.000 | 0.000 | 0.000
[σzda, σba, τa, τqa] (N/mm²) | 0.000 | 74.632 | 0.000 | 9.407
[σzdmax,σbmax,τmax,τqmax] (N/mm²) | -0.000 | 74.632 | 0.000 | 9.407
Technologischer Grösseneinfluss | [K1(σB)] | 1.000
| [K1(σS)] | 0.904
| | Zug/Druck | Biegung | Torsion
Kerbwirkungszahl | [ß(dB)] | 2.996 | 2.737 | 2.490
[dB] (mm) = | 30.0
Geometrischer Grösseneinfluss | [K3(d)] | 0.937 | 0.942 | 0.947
Geometrischer Grösseneinfluss | [K3(dB)] | 0.956 | 0.960 | 0.963
Kerbwirkungszahl | [ß] | 3.058 | 2.788 | 2.532
Geometrischer Grösseneinfluss | [K2(d)] | 1.000 | 0.867 | 0.867
Einflussfaktor Oberflächenrauheit | [KF] | 1.054 | 1.054 | 1.029
Oberflächenverfestigungfaktor | [KV] | 1.000 | 1.000 | 1.000
Gesamteinflussfaktor | [K] | 3.006 | 3.164 | 2.892

Vorhandene Sicherheitszahl für den Dauerfestigkeitsnachweis:
Vergleichsmittelspannung (N/mm²) | [σmV] | | | 0.000
Vergleichsmittelspannung (N/mm²) | [τmV] | | | 0.000
Bauteilwechselfestigkeit (N/mm²) | [σWK] | 89.806 | 105.865 | 69.157
Einflussfaktor Mittelspannungsempf. | [ψσK] | 0.072 | 0.086 | 0.054
Ertragbare Amplitude (N/mm²) | [σADK] | 89.235 | 105.865 | 68.965
Sicherheit gegen Ermüdung | [S] | | | 1.418
Sollsicherheit gegen Ermüdung | [Smin] | | | 1.200
Resultat (%) | [S/Smin] | | | 118.2

Vorhandene Sicherheitszahl
für den Nachweis gegen Überschreiten der Fliessgrenze:
Statische Stützziffer | [K2F] | 1.000 | 1.200 | 1.200
Erhöhungsfaktor | [γF] | 1.150 | 1.100 | 1.000
Bauteilfliessgrenze (N/mm²) | [σFK] | 374.183 | 429.497 | 225.427
Sicherheit Fliessgrenze | [S] | | | 5.755
Sollsicherheit | [Smin] | | | 1.200

Resultat (%) | [S/Smin] | 479.6
Querschnitt 'D-D' | Wellenabsatz mit Freistich
Kommentar | Y= 160.75mm
Position (Y-Koordinate) (mm) | [y] | 160.750
Aussendurchmesser (mm) | [da] | 58.000
Innendurchmesser (mm) | [di] | 0.000
Kerbwirkung | Wellenabsatz mit Freistich
[D, d, D1, r, t1] (mm) | 73.000 | 57.400 | 58.000 | 0.800 | 0.300
Form B
Mittlere Rauheit (µm) | [Rz] | 32.000
Zug/Druck | Biegung | Torsion | Scherung
Belastung: (N) (Nm)
Mittelwert | [Fzdm, Mbm, Tm, Fqm] | 4564.5 | 0.0 | 1222.3 | 0.0
Ausschlag (Amplitude) | [Fzda, Mba, Ta, Fqa] | 451.4 | 1015.8 | 120.9 | 14055.5
Maximalwert | [Fzdmax, Mbmax, Tmax, Fqmax] | 5015.9 | 1015.8 | 1343.2 | 14055.5
Querschnitt, Widerstandsmomente: (mm²) (mm3)
[A, Wb, Wt, A] | 2587.7 | 18566.7 | 37133.5 | 2587.7

Spannungen: (N/mm²)
[σzdm, σbm, τm, τqm] (N/mm²) | 1.764 | 0.000 | 32.917 | 0.000
[σzda, σba, τa, τqa] (N/mm²) | 0.174 | 54.710 | 3.256 | 7.242
[σzdmax,σbmax,τmax,τqmax] (N/mm²) | 1.938 | 54.710 | 36.173 | 7.242
Technologischer Grösseneinfluss | [K1(σB)] | 1.000
| [K1(σS)] | 0.904
| | Zug/Druck | Biegung | Torsion
Formzahl | [α] | 3.449 | 3.065 | 2.045
Bezogenes Spannungsgefälle | [G'] | 3.073 | 3.073 | 1.437
Stützziffer | [n] | 1.286 | 1.286 | 1.196
Kerbwirkungszahl | [ß] | 2.682 | 2.383 | 1.710
Geometrischer Grösseneinfluss | [K2(d)] | 1.000 | 0.863 | 0.863
Einflussfaktor Oberflächenrauheit | [KF] | 0.826 | 0.826 | 0.900
Oberflächenverfestigungfaktor | [KV] | 1.000 | 1.000 | 1.000

Gesamteinflussfaktor | [K] | 2.892 | 2.970 | 2.091

Vorhandene Sicherheitszahl für den Dauerfestigkeitsnachweis:
Vergleichsmittelspannung (N/mm²) | [σmV] | | | 57.042
Vergleichsmittelspannung (N/mm²) | [τmV] | | | 32.933
Bauteilwechselfestigkeit (N/mm²) | [σWK] | 93.356 | 112.799 | 95.636
Einflussfaktor Mittelspannungsempf. | [ψσK] | 0.075 | 0.092 | 0.077
Ertragbare Amplitude (N/mm²) | [σADK] | 1.141 | 102.935 | 20.280
Sicherheit gegen Ermüdung | [S] | | | 1.422
Sollsicherheit gegen Ermüdung | [Smin] | | | 1.200
Resultat (%) | [S/Smin] | | | 118.5

Vorhandene Sicherheitszahl
für den Nachweis gegen Überschreiten der Fliessgrenze:
Statische Stützziffer | [K2F] | 1.000 | 1.200 | 1.200
Erhöhungsfaktor | [γF] | 1.150 | 1.150 | 1.000
Bauteilfliessgrenze (N/mm²) | [σFK] | 374.183 | 449.019 | 225.427
Sicherheit Fliessgrenze | [S] | | | 4.886
Sollsicherheit | [Smin] | | | 1.200
Resultat (%) | [S/Smin] | | | 407.2
Querschnitt 'E-E' | Rechtecknut
Kommentar | Y= 90.25... 92.40mm
Position (Y-Koordinate) (mm) | [y] | 91.325
Aussendurchmesser (mm) | [da] | 58.000
Innendurchmesser (mm) | [di] | 0.000
Kerbwirkung | Rechtecknut
[d, r, t, m] (mm) | 55.00 | 0.20 | 1.50 | 2.15
Mittlere Rauheit (µm) | [Rz] | 8.000
Zug/Druck | Biegung | Torsion | Scherung
Belastung: (N) (Nm)
Mittelwert | [Fzdm, Mbm, Tm, Fqm] | -0.2 | 0.0 | 0.0 | 0.0
Ausschlag (Amplitude) | [Fzda, Mba, Ta, Fqa] | 0.0 | 1203.5 | 0.0 | 16761.7
Maximalwert | [Fzdmax, Mbmax, Tmax, Fqmax] | -0.2 | 1203.5 | 0.0 | 16761.7
Querschnitt, Widerstandsmomente: (mm²) (mm3)
[A, Wb, Wt, A] | 2375.8 | 16333.8 | 32667.7 | 2375.8

Spannungen: (N/mm²)
[σzdm, σbm, τm, τqm] (N/mm²) | -0.000 | 0.000 | 0.000 | 0.000
[σzda, σba, τa, τqa] (N/mm²) | 0.000 | 73.683 | 0.000 | 9.407
[σzdmax,σbmax,τmax,τqmax] (N/mm²) | -0.000 | 73.683 | 0.000 | 9.407
Technologischer Grösseneinfluss | [K1(σB)] | 1.000
| [K1(σS)] | 0.904
| | Zug/Druck | Biegung | Torsion
Kerbwirkungszahl | [ß(dB)] | 2.996 | 2.737 | 2.490
[dB] (mm) = | 30.0
Geometrischer Grösseneinfluss | [K3(d)] | 0.937 | 0.942 | 0.947
Geometrischer Grösseneinfluss | [K3(dB)] | 0.956 | 0.960 | 0.963
Kerbwirkungszahl | [ß] | 3.058 | 2.788 | 2.532
Geometrischer Grösseneinfluss | [K2(d)] | 1.000 | 0.867 | 0.867
Einflussfaktor Oberflächenrauheit | [KF] | 1.054 | 1.054 | 1.029
Oberflächenverfestigungfaktor | [KV] | 1.000 | 1.000 | 1.000
Gesamteinflussfaktor | [K] | 3.006 | 3.164 | 2.892

Vorhandene Sicherheitszahl für den Dauerfestigkeitsnachweis:
Vergleichsmittelspannung (N/mm²) | [σmV] | | | 0.000
Vergleichsmittelspannung (N/mm²) | [τmV] | | | 0.000
Bauteilwechselfestigkeit (N/mm²) | [σWK] | 89.806 | 105.865 | 69.157
Einflussfaktor Mittelspannungsempf. | [ψσK] | 0.072 | 0.086 | 0.054
Ertragbare Amplitude (N/mm²) | [σADK] | 89.235 | 105.865 | 68.965
Sicherheit gegen Ermüdung | [S] | | | 1.437
Sollsicherheit gegen Ermüdung | [Smin] | | | 1.200
Resultat (%) | [S/Smin] | | | 119.7

Vorhandene Sicherheitszahl
für den Nachweis gegen Überschreiten der Fliessgrenze:
Statische Stützziffer | [K2F] | 1.000 | 1.200 | 1.200
Erhöhungsfaktor | [γF] | 1.150 | 1.100 | 1.000
Bauteilfliessgrenze (N/mm²) | [σFK] | 374.183 | 429.497 | 225.427
Sicherheit Fliessgrenze | [S] | | | 5.829
Sollsicherheit | [Smin] | | | 1.200
Resultat (%) | [S/Smin] | | | 485.8

Querschnitt 'F-F' | Passfeder
Kommentar | Y= 94.25...157.25mm
Position (Y-Koordinate) (mm) | [y] | 94.260
Aussendurchmesser (mm) | [da] | 58.000
Innendurchmesser (mm) | [di] | 0.000
Kerbwirkung | Passfeder
Anzahl Passfedern | [n] | 1
Nut mit Fingerfräser bearbeitet
Norm: | DIN 6885.1:1968 Standard
[b, t] (mm) | 16.000 6.100
Mittlere Rauheit (µm) | [Rz] | 8.000
Zug/Druck | Biegung | Torsion | Scherung
Belastung: (N) (Nm)
Mittelwert | [Fzdm, Mbm, Tm, Fqm] | 165.1 | 0.0 | 44.3 | 0.0
Ausschlag (Amplitude) | [Fzda, Mba, Ta, Fqa] | 16.3 | 1246.8 | 4.4 | 15680.7
Maximalwert | [Fzdmax, Mbmax, Tmax, Fqmax] | 181.4 | 1246.8 | 48.6 | 15680.7
Querschnitt, Widerstandsmomente: (mm²) (mm3)
[A, Wb, Wt, A] | 2642.1 | 19155.1 | 38310.2 | 2642.1

Spannungen: (N/mm²)
[σzdm, σbm, τm, τqm] (N/mm²) | 0.062 | 0.000 | 1.156 | 0.000
[σzda, σba, τa, τqa] (N/mm²) | 0.006 | 65.089 | 0.114 | 7.913
[σzdmax,σbmax,τmax,τqmax] (N/mm²) | 0.069 | 65.089 | 1.270 | 7.913
Technologischer Grösseneinfluss | [K1(σB)] | 1.000
| [K1(σS)] | 0.904
| | Zug/Druck | Biegung | Torsion
Kerbwirkungszahl | [ß(dB)] | 2.570 | 2.570 | 1.570
[dB] (mm) = | 40.0
Geometrischer Grösseneinfluss | [K3(d)] | 0.944 | 0.944 | 0.973
Geometrischer Grösseneinfluss | [K3(dB)] | 0.954 | 0.954 | 0.978
Kerbwirkungszahl | [ß] | 2.598 | 2.598 | 1.578
Geometrischer Grösseneinfluss | [K2(d)] | 1.000 | 0.863 | 0.863
Einflussfaktor Oberflächenrauheit | [KF] | 1.000 | 1.000 | 1.000
Rauheitsfaktor ist gemäss Norm in der Kerbwirkungszahl inbegriffen
Oberflächenverfestigungfaktor | [KV] | 1.000 | 1.000 | 1.000

Gesamteinflussfaktor | [K] | 2.598 | 3.009 | 1.827

Vorhandene Sicherheitszahl für den Dauerfestigkeitsnachweis:
Vergleichsmittelspannung (N/mm²) | [σmV] | | | 2.002
Vergleichsmittelspannung (N/mm²) | [τmV] | | | 1.156
Bauteilwechselfestigkeit (N/mm²) | [σWK] | 103.939 | 111.350 | 109.445
Einflussfaktor Mittelspannungsempf. | [ψσK] | 0.084 | 0.091 | 0.089
Ertragbare Amplitude (N/mm²) | [σADK] | 1.001 | 111.040 | 20.279
Sicherheit gegen Ermüdung | [S] | | | 1.688
Sollsicherheit gegen Ermüdung | [Smin] | | | 1.200
Resultat (%) | [S/Smin] | | | 140.7

Vorhandene Sicherheitszahl
für den Nachweis gegen Überschreiten der Fliessgrenze:
Statische Stützziffer | [K2F] | 1.000 | 1.200 | 1.200
Erhöhungsfaktor | [γF] | 1.000 | 1.000 | 1.000
Bauteilfliessgrenze (N/mm²) | [σFK] | 325.376 | 390.452 | 225.427
Sicherheit Fliessgrenze | [S] | | | 5.988
Sollsicherheit | [Smin] | | | 1.200
Resultat (%) | [S/Smin] | | | 499.0
Hinweise: - | Die Querkraft wird bei der Berechnung nach DIN 743 nicht berücksichtigt. - | Querschnitt mit Presssitz: Die Kerbfaktoren für den Fall 'Leichter Presssitz' sind nicht mehr definiert in DIN743. Die Faktoren werden aus der FKM-Richtlinine übernommen, ausser die Faktoren für den 'festen Pressitz' nach DIN sind kleiner, dann werden diese verwendet. Ende Protokoll

Zeilen: 889
