Mofiche/Getriebebeleg/CAD/Stueckliste.xls

Donnerstag, 17. Juni 2021 10:46:29
Stückliste: Getriebe
Nummer | Teilenummer | Menge
 | Stirnradstufe_1 | 1
 | Stirnradstufe_2 | 1
1 | Eingangswelle | 1
2 | Paßfeder A 10x8x36 | 1
3 | Zwischenwelle | 1
4 | Paßfeder A 14x9x36 | 1
5 | Paßfeder A 18x11x63 | 1
6 | Paßfeder A 16x10x63 | 1
7 | Ausgangswelle | 1
8 | Paßfeder A 22x14x80.2 | 1
9 | Paßfeder A 20x12x140 | 1
10 | Rillenkugellager DIN 625 - 6213 d=65 D=120 B=23 | 1
11 | Zylinderrollenlager N 206 d=30 D=62 B=16 | 1
12 | Rillenkugellager DIN 625 - 6308 d=40 D=90 B=23 | 1
13 | Zylinderrollenlager N 308 d=40 D=90 B=23 | 1
14 | Rillenkugellager DIN 625 - 6308 d=40 D=90 B=23.2 | 1
15 | Sicherungsring DIN 471 - 65 x 2,5 | 1
 | bearing_6216 | 1
16 | Sicherungsring DIN 471 - 38 x 1,75 | 1
17 | Sicherungsring DIN 471 - 30 x 1,5 | 1
18 | Sicherungsring DIN 471 - 40 x 1,75 | 1
19 | Sicherungsring DIN 471 - 58 x 2 | 1
20 | Sicherungsring DIN 471 - 60 x 2 | 1
21 | Sicherungsring DIN 471 - 40 x 1,75.2 | 1
22 | Sicherungsring DIN 471 - 40 x 1,75.3 | 1
23 | Sicherungsring DIN 471 - 85 x 3 | 1
24 | Sicherungsring DIN 471 - 80 x 2,5 | 1
25 | Lagerbock_Einganswelle_LL | 1
26 | Gehaeuse_Unterteil | 1
27 | WDR DIN 3760 - A50 x 65 x 8 | 1
28 | Gehaeuse_Oberteil | 1
29 | WDR DIN 3760 - A70 x 90 x 10 | 1
30 | Lagerdeckel_Eingangswelle_FL | 1
31 | Lagerdeckel_Zwischenwelle_FL | 1
32 | Lagerdeckel_Ausgangswelle_LL | 1
33 | Lagerdeckel_Zwischenwelle_LL | 1
34 | Lagerdeckel_Ausgangswelle_FL | 1
35 | Zylinderschraube DIN 7984 - M8x25 | 20
36 | Zylinderschraube DIN 7984 - M12x45 | 1
37 | Zylinderschraube DIN 7984 - M16x30 | 1
 | Ringschraube | 2
38 | Zylinderschraube M12x45 | 14
39 | Sechskantmutter ISO 4032 - M12.2 | 14
40 | Zylinderschraube M12 x 120 | 1
41 | Zylinderschraube DIN 7984 - M10x16.2 | 1
42 | Oelschauglas | 1
43 | Zylinderschraube DIN 7984 - M10x55 | 2
44 | Sechskantmutter ISO 4032 - M10 | 2
Stückliste: Stirnradstufe_1
Nummer | Teilenummer | Menge
45 | Rad1_Stufe1 | 1
46 | Rad2_Stufe1 | 1
Stückliste: Stirnradstufe_2
Nummer | Teilenummer | Menge
47 | Rad1_Stufe2 | 1
48 | Rad2_Stufe2 | 1
Stückliste: Lager_6216
Nummer | Teilenummer | Menge
49 | bearing_6216_01 | 1
50 | bearing_6216_02 | 1
51 | bearing_6216_03 | 1
Stückliste: Ringschraube
Nummer | Teilenummer | Menge
52 | Ringschraube_Oberteil | 1
53 | Ringschraube_Gewinde | 1
Wiederholung von: Getriebe
Verschiedene Teile: 53
Teile gesamt: 102
Nummer | Teilenummer | Menge
45 | Rad1_Stufe1 | 1
46 | Rad2_Stufe1 | 1
47 | Rad1_Stufe2 | 1
48 | Rad2_Stufe2 | 1
1 | Eingangswelle | 1
2 | Paßfeder A 10x8x36 | 1
3 | Zwischenwelle | 1
4 | Paßfeder A 14x9x36 | 1
5 | Paßfeder A 18x11x63 | 1
6 | Paßfeder A 16x10x63 | 1
7 | Ausgangswelle | 1
8 | Paßfeder A 22x14x80.2 | 1
9 | Paßfeder A 20x12x140 | 1
10 | Rillenkugellager DIN 625 - 6213 d=65 D=120 B=23 | 1
11 | Zylinderrollenlager N 206 d=30 D=62 B=16 | 1
12 | Rillenkugellager DIN 625 - 6308 d=40 D=90 B=23 | 1
13 | Zylinderrollenlager N 308 d=40 D=90 B=23 | 1
14 | Rillenkugellager DIN 625 - 6308 d=40 D=90 B=23.2 | 1
15 | Sicherungsring DIN 471 - 65 x 2,5 | 1
49 | bearing_6216_01 | 1
50 | bearing_6216_02 | 1
51 | bearing_6216_03 | 1
16 | Sicherungsring DIN 471 - 38 x 1,75 | 1
17 | Sicherungsring DIN 471 - 30 x 1,5 | 1
18 | Sicherungsring DIN 471 - 40 x 1,75 | 1
19 | Sicherungsring DIN 471 - 58 x 2 | 1
20 | Sicherungsring DIN 471 - 60 x 2 | 1
21 | Sicherungsring DIN 471 - 40 x 1,75.2 | 1
22 | Sicherungsring DIN 471 - 40 x 1,75.3 | 1
23 | Sicherungsring DIN 471 - 85 x 3 | 1
24 | Sicherungsring DIN 471 - 80 x 2,5 | 1
25 | Lagerbock_Einganswelle_LL | 1
26 | Gehaeuse_Unterteil | 1
27 | WDR DIN 3760 - A50 x 65 x 8 | 1
28 | Gehaeuse_Oberteil | 1
29 | WDR DIN 3760 - A70 x 90 x 10 | 1
30 | Lagerdeckel_Eingangswelle_FL | 1
31 | Lagerdeckel_Zwischenwelle_FL | 1
32 | Lagerdeckel_Ausgangswelle_LL | 1
33 | Lagerdeckel_Zwischenwelle_LL | 1
34 | Lagerdeckel_Ausgangswelle_FL | 1
35 | Zylinderschraube DIN 7984 - M8x25 | 20
36 | Zylinderschraube DIN 7984 - M12x45 | 1
37 | Zylinderschraube DIN 7984 - M16x30 | 1
52 | Ringschraube_Oberteil | 2
53 | Ringschraube_Gewinde | 2
38 | Zylinderschraube M12x45 | 14
39 | Sechskantmutter ISO 4032 - M12.2 | 14
40 | Zylinderschraube M12 x 120 | 1
41 | Zylinderschraube DIN 7984 - M10x16.2 | 1
42 | Oelschauglas | 1
43 | Zylinderschraube DIN 7984 - M10x55 | 2
44 | Sechskantmutter ISO 4032 - M10 | 2
