Mofiche/Getriebebeleg/(list of files, cad)

Other CAD files:
CAD/6216.CATProduct
CAD/Ausgangswelle.CATPart
CAD/Eingangswelle.CATPart
CAD/Gehaeuse_Oberteil.CATPart
CAD/Gehaeuse_Unterteil.CATPart
CAD/Getriebe.CATProduct
CAD/ISO_4762_M12x120_STEEL_HEXAGON_SOCKET_HEAD_CAP_SCREW.CATPart
CAD/Lager6216/bearing_6216.CATProduct
CAD/Lager6216/bearing_6216_01.CATPart
CAD/Lager6216/bearing_6216_02.CATPart
CAD/Lager6216/bearing_6216_03.CATPart
CAD/Lagerbock_Einganswelle_LL.CATPart
CAD/Lagerdeckel_Ausgangswelle_FL.CATPart
CAD/Lagerdeckel_Ausgangswelle_LL.CATPart
CAD/Lagerdeckel_Eingangswelle_FL.CATPart
CAD/Lagerdeckel_Zwischenwelle_LL.CATPart
CAD/Oelschauauge.CATPart
CAD/PASSFEDER_A_10x8x36.CATPart
CAD/PASSFEDER_A_14x9x36.CATPart
CAD/PASSFEDER_A_16x10x63.CATPart
CAD/PASSFEDER_A_18x11x63.CATPart
CAD/PASSFEDER_A_20x12x140.CATPart
CAD/PASSFEDER_A_22x14x140.CATPart
CAD/PASSFEDER_A_22x14x80.CATPart
CAD/PASSFEDER_A_22x14x80_New_18.CATPart
CAD/RAD1_STUFE_1.CATPart
CAD/RILLENKUGELLAGER_DIN_625_6213.CATPart
CAD/RILLENKUGELLAGER_DIN_625_6308.CATPart
CAD/Rillenkugellager DIN 625 - 6308 d=40 D=90 B=23.2.CATPart
CAD/Ringschraube/c80312.CATProduct
CAD/Ringschraube/c80312_01.CATPart
CAD/Ringschraube/c80312_02.CATPart
CAD/SECHSKANTMUTTER_ISO_4032_M10.CATPart
CAD/SECHSKANTMUTTER_ISO_4032_M12.CATPart
CAD/SICHERUNGSRING_DIN_471_30x1,5.CATPart
CAD/SICHERUNGSRING_DIN_471_38x1,75.CATPart
CAD/SICHERUNGSRING_DIN_471_40x1,75.CATPart
CAD/SICHERUNGSRING_DIN_471_58x2.CATPart
CAD/SICHERUNGSRING_DIN_471_60x2.CATPart
CAD/SICHERUNGSRING_DIN_471_65x2,5.CATPart
CAD/SICHERUNGSRING_DIN_471_80x2,5.CATPart
CAD/SICHERUNGSRING_DIN_471_85x3.CATPart
CAD/STEUERTEIL_STIRNRADSTUFE_1.CATPart
CAD/STEUERTEIL_STIRNRADSTUFE_2.CATPart
CAD/STIRNRADSTUFE_1.CATProduct
CAD/STIRNRADSTUFE_2.CATProduct
CAD/Sechskantmutter ISO 4032 - M12.2.CATPart
CAD/Sicherungsring DIN 471 - 40 x 1,75.2.CATPart
CAD/Sicherungsring DIN 471 - 40 x 1,75.3.CATPart
CAD/Steuerteil.CATPart
CAD/Stirnradstufen_vorbereitet/Stirnradstufe_1/RAD1_STUFE_1.CATPart
CAD/Stirnradstufen_vorbereitet/Stirnradstufe_1/RAD2_STUFE_1.CATPart
CAD/Stirnradstufen_vorbereitet/Stirnradstufe_2/RAD1_STUFE_2.CATPart
CAD/Stirnradstufen_vorbereitet/Stirnradstufe_2/RAD2_STUFE_2.CATPart
CAD/WDR_DIN_3760_A50X65X8.CATPart
CAD/WDR_DIN_3760_A70X90X10.CATPart
CAD/ZYLINDERROLLENLAGER_N_206.CATPart
CAD/ZYLINDERROLLENLAGER_N_308.CATPart
CAD/ZYLINDERSCHRAUBE_DIN_7984_M10x16.CATPart
CAD/ZYLINDERSCHRAUBE_DIN_7984_M10x55.CATPart
CAD/ZYLINDERSCHRAUBE_DIN_7984_M10x60.CATPart
CAD/ZYLINDERSCHRAUBE_DIN_7984_M12x40.CATPart
CAD/ZYLINDERSCHRAUBE_DIN_7984_M12x45.CATPart
CAD/ZYLINDERSCHRAUBE_DIN_7984_M12x80.CATPart
CAD/ZYLINDERSCHRAUBE_DIN_7984_M16x30.CATPart
CAD/ZYLINDERSCHRAUBE_DIN_7984_M8x25.CATPart
CAD/Zwischenwelle.CATPart
CAD/Zylinderschraube DIN 7984 - M10x16.2.CATPart
CAD/Zylinderschraube M12x45.CATPart
CAD/din910-m10x1-st.CATPart
