Mofiche/Getriebebeleg/Dokumentation/Getriebe_Draufsicht.pdf

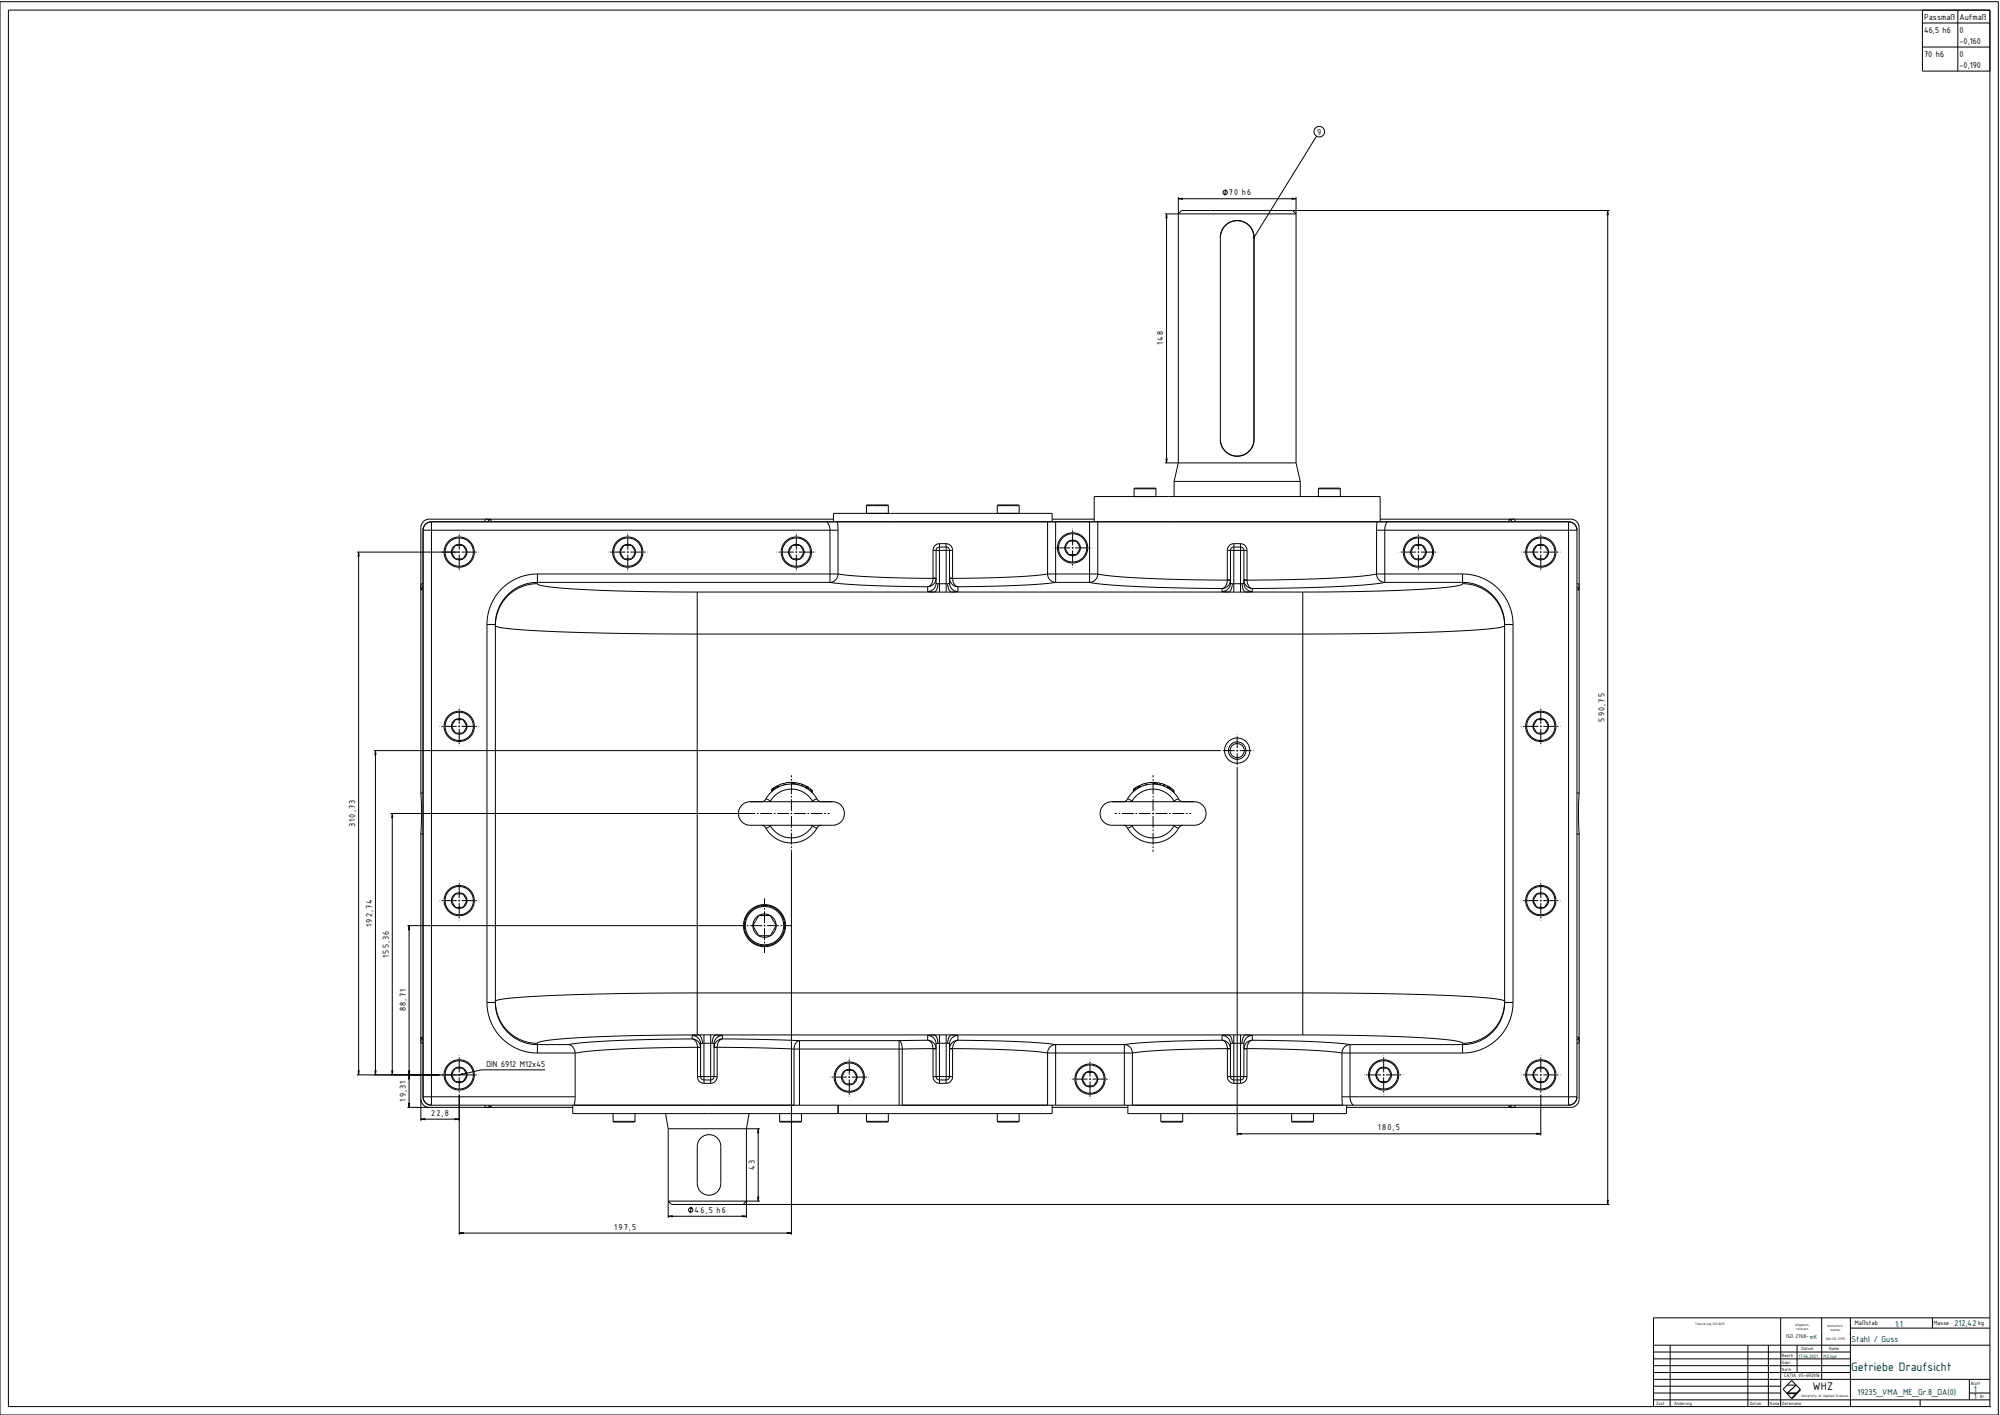
[picture p21: page 1]
DIN ISO 13715; ISO 2768-; Tolerierung ISO 8015; Stahl / Guss; DIN 6912 M12x45

70 h6 | Passmaß | Aufmaß

Datum | Name | Getriebe Draufsicht

Bearb | 17.06.2021 | M.Enge
Gepr.
Norm
CATIA V5-6R2016
WHZ University of Applied Sciences | 19235_VMA_ME_Gr.8_DA(0) | Blatt 1
