Mofiche/Getriebebeleg/Dokumentation/Getriebe_Schnitt.pdf

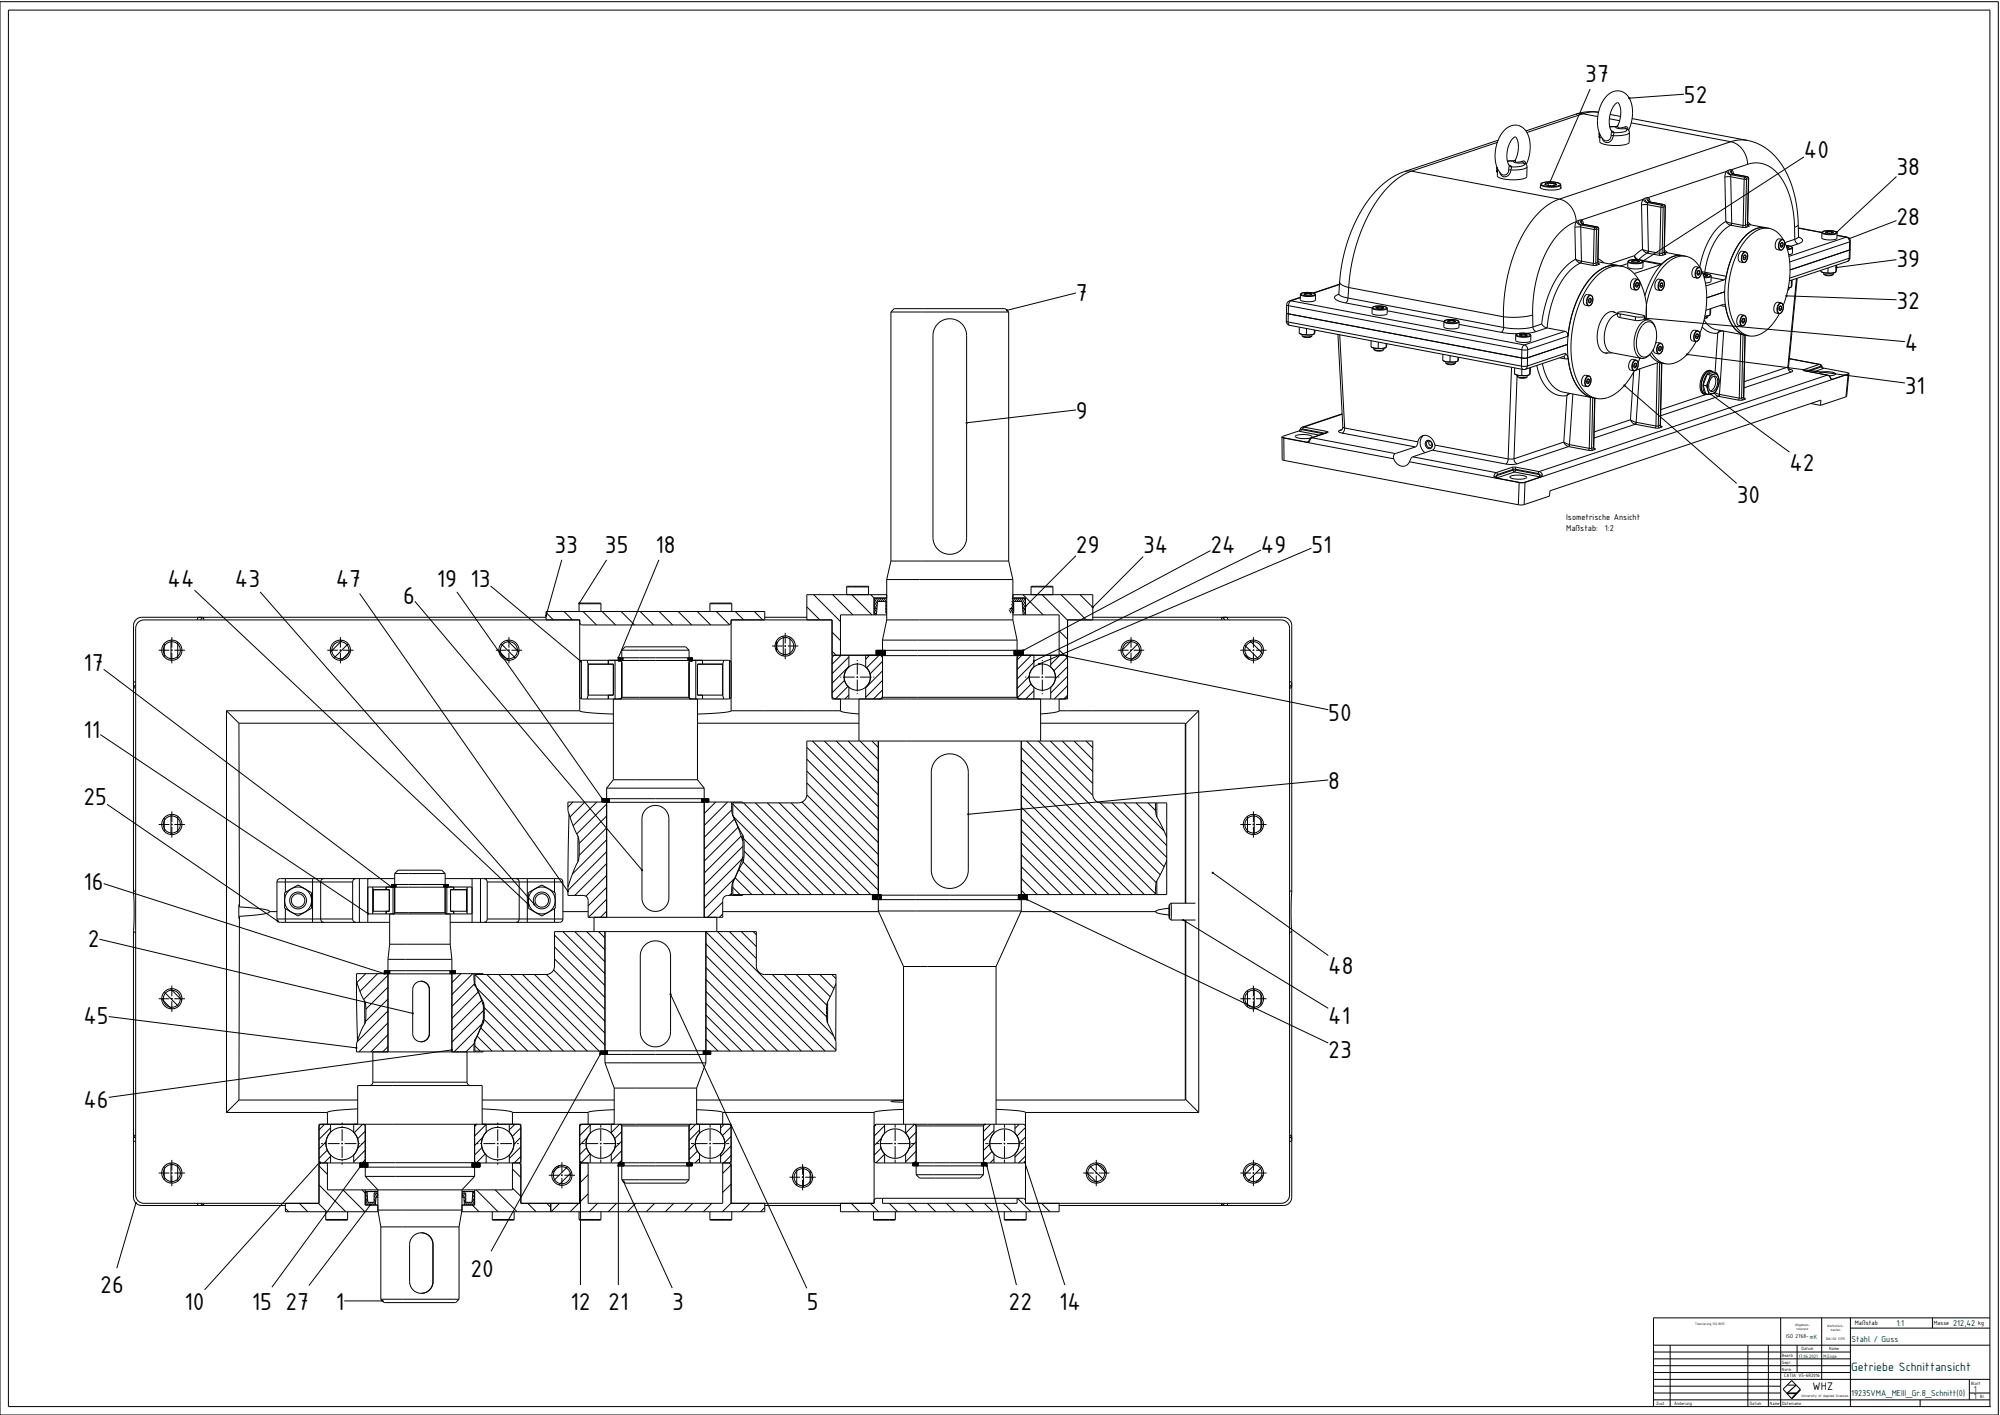
[picture p22: page 1]
CATIA V5-6R2016; DIN ISO 13715; ISO 2768-; Tolerierung ISO 8015; Getriebe Schnittansicht; 17.06.2021 M.Enge; Stahl / Guss; Isometrische Ansicht Maßstab: 1:2

University of Applied Sciences
