Mofiche/Getriebebeleg/Dokumentation/Getriebe_Vorderansicht.pdf

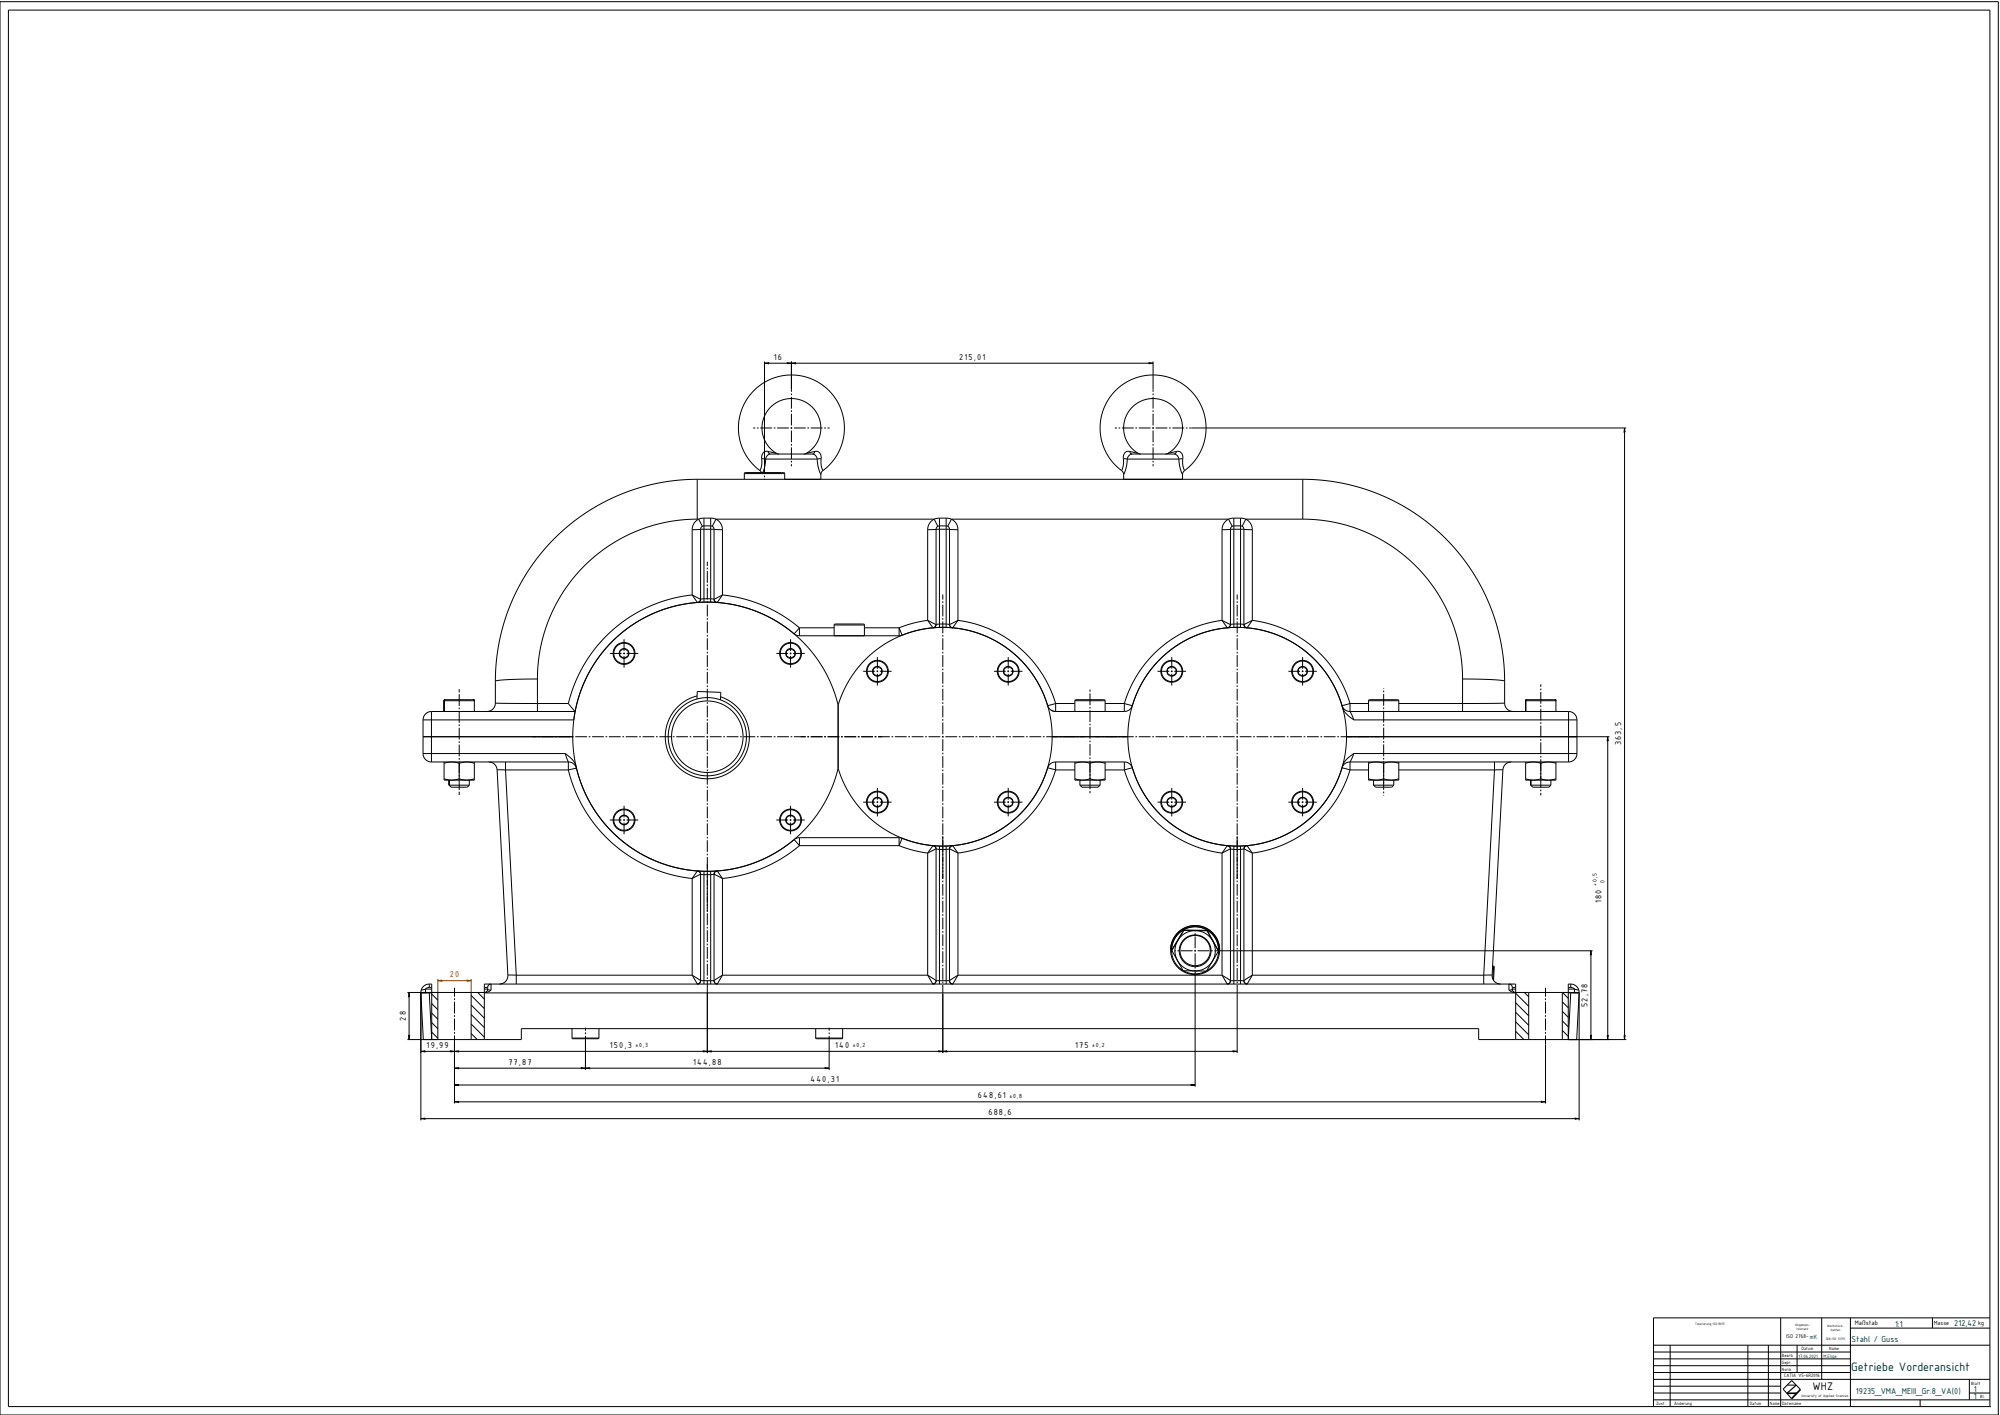
[picture p23: page 1]
DIN ISO 13715; ISO 2768-; Tolerierung ISO 8015; Stahl / Guss

Datum | Name | Getriebe Vorderansicht

Bearb | 17.06.2021 | M.Enge
Gepr.
Norm
CATIA V5-6R2016
WHZ University of Applied Sciences | 19235_VMA_MEIII_Gr.8_VA(0) | Blatt 1
