Mofiche/Getriebebeleg/Dokumentation/Zwischenwelle_Zeichnung.pdf

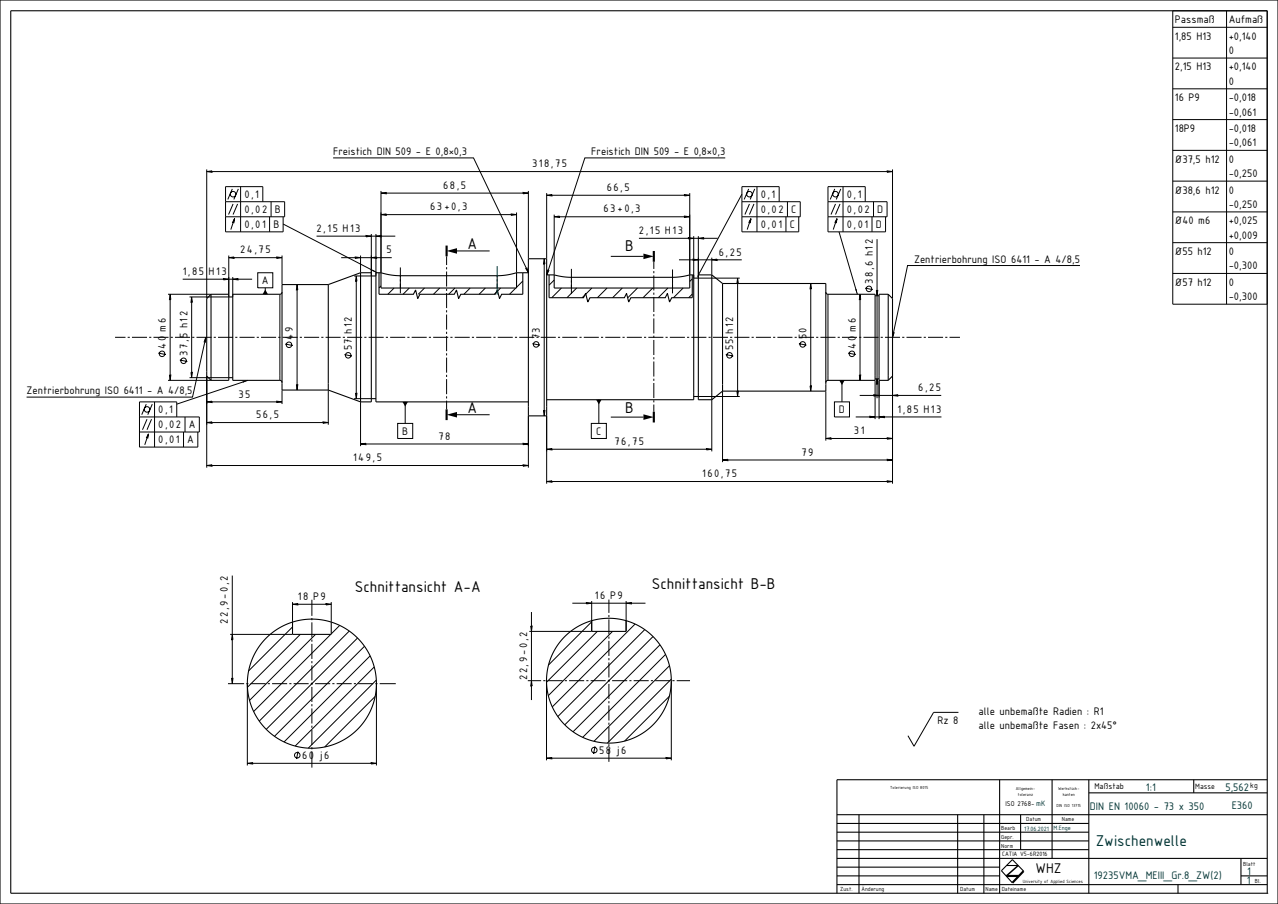
[picture p24: page 1]
DIN ISO 13715; ISO 2768-; Tolerierung ISO 8015; DIN EN 10060 - 73 x 350; Zentrierbohrung ISO 6411 - A 4/8,5; Schnittansicht A-A; Schnittansicht B-B

Freistich DIN 509 - E 0,8×0,3 Freistich DIN 509 - E 0,8×0,3 318,75 | Passmaß | Aufmaß

0,02 | A
0,01 | A

alle unbemaßte Radien : R1
alle unbemaßte Fasen : 2x45°

Datum | Name | Zwischenwelle

Bearb | 17.06.2021 | M.Enge
Gepr.
Norm
CATIA V5-6R2016
WHZ University of Applied Sciences | 19235VMA_MEIII_Gr.8_ZW(2) | Blatt 1
