Mofiche/Getriebebeleg/(commit log)

2021-05-28 Auslegung fertig
    [Ausgangswelle.CATPart, Eingangswelle.CATPart, RAD1_STUFE_1.CATPart, STEUERTEIL_STIRNRADSTUFE_1.CATPart, STEUERTEIL_STIRNRADSTUFE_2.CATPart, STIRNRADSTUFE_1.CATProduct, STIRNRADSTUFE_2.CATProduct]
2021-06-04 Wellen+ZR+Lager+Sicherungsring im CAD Modell
    [6216.CATProduct, Ausgangswelle.CATPart, Eingangswelle.CATPart, Getriebe.CATProduct, PASSFEDER_A_10x8x36.CATPart, PASSFEDER_A_14x9x36.CATPart, PASSFEDER_A_16x10x63.CATPart, PASSFEDER_A_18x11x63.CATPart]
2021-06-10 Getrieb Lagerdeckel 1.Seite
    [Ausgangswelle.CATPart, Eingangswelle.CATPart, Gehaeuse_Oberteil.CATPart, Gehaeuse_Unterteil.CATPart, Getriebe.CATProduct, Lagerbock_Einganswelle_LL.CATPart, Lagerdeckel_Ausgangswelle_LL.CATPart, Lagerdeckel_Eingangswelle_FL.CATPart]
2021-06-18 CAD Modell und Zeichnungen fertig
    [Ausgangswelle.CATPart, Eingangswelle.CATPart, Gehaeuse.xlsx, Gehaeuse_Oberteil.CATPart, Gehaeuse_Unterteil.CATPart, Getriebe.CATProduct, ISO_4762_M12x120_STEEL_HEXAGON_SOCKET_HEAD_CAP_SCREW.CATPart, Lagerbock_Einganswelle_LL.CATPart]
